AleksandarLilic/ama-riscv/examples/perf_runs_fpga/plots_mlp.pdf

## TDA for 'mlp_w2a8'

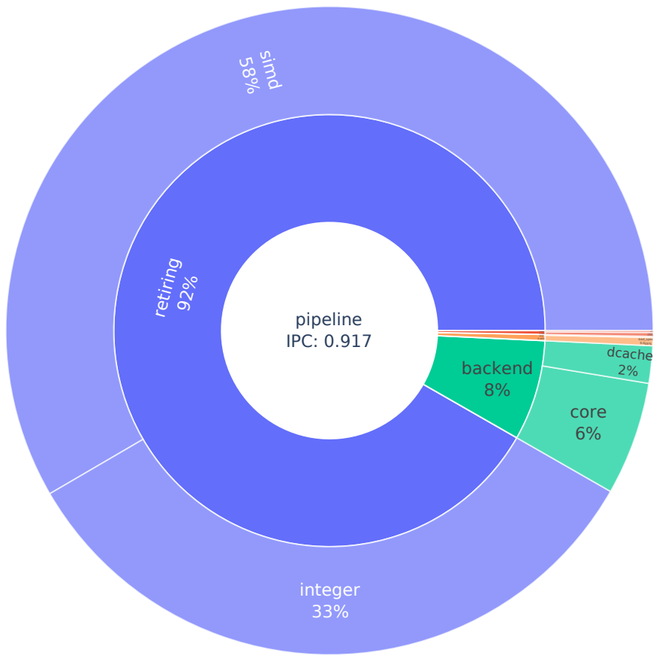
[picture p23: figure]
pipeline IPC: 0.917; retiring 92%; backend 8%; lost 0.46%; frontend 0.285%; simd 58%; integer 33%; core 6%; dcache 2%; bad_spec 0.405%; other 0.0551%; icache 0.193%; core 0.0921%

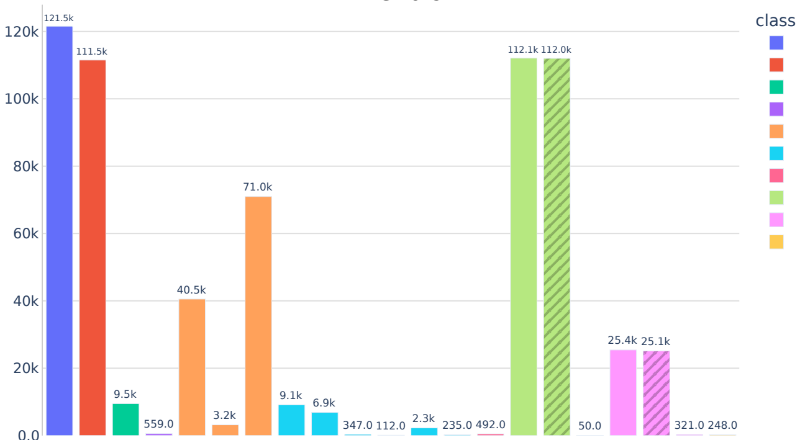
[picture p24: figure]
class

cycles
ret_inst

stalls
lost

ret_int
ret_ctrl_flow_br

ret_simd
stall_be
stall_be_core

stall_fe
stall_fe_core

stall_l1d

stall_l1i
bad_spec
l1i_ref

l1i_hit

l1i_miss
l1d_ref

l1d_hit

l1d_miss

bp_miss

0.0

20k

40k

60k

80k

100k

cycles
ret
stall
lost
ret_*
stall_*
bad_spec
l1i_*
l1d_*
bp_*

## Performance Counters for 'mlp_w2a8' IPC: 0.917

count

# hatched = derived

## TDA for 'mlp_w4a8'

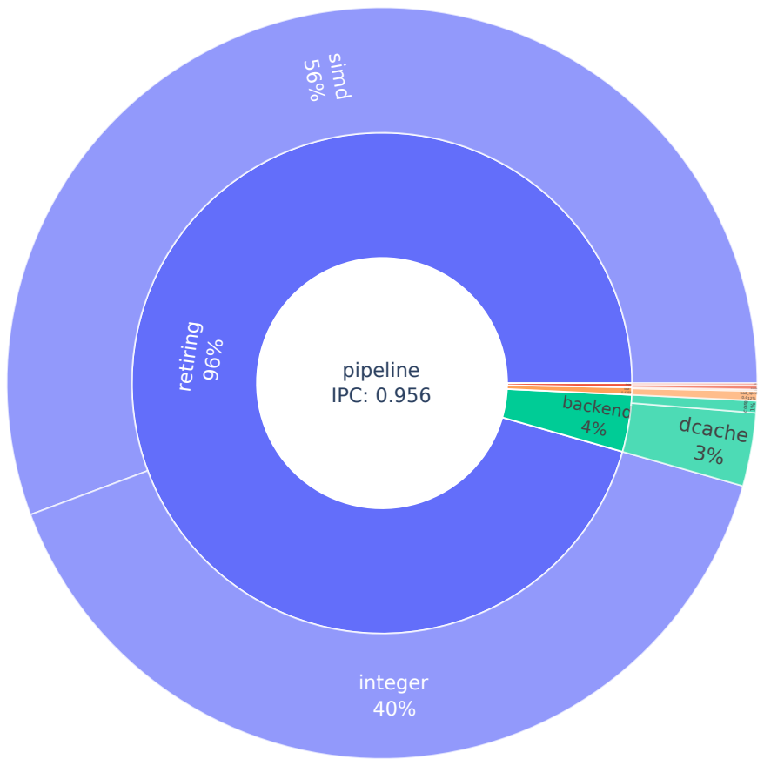
[picture p25: figure]
pipeline; IPC: 0.956 retiring 96%; backend 4%; lost 0.476%; frontend 0.27%; simd; integer 40%; dcache 3%; core; bad_spec 0.412%; other 0.0646%; icache 0.181%; core 0.0887%

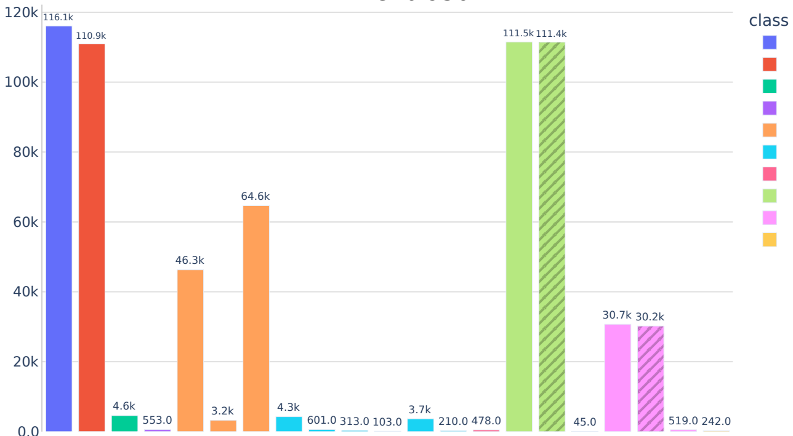
[picture p26: figure]
class

cycles
ret_inst

stalls
lost

ret_int
ret_ctrl_flow_br

ret_simd
stall_be
stall_be_core

stall_fe
stall_fe_core

stall_l1d

stall_l1i
bad_spec
l1i_ref

l1i_hit

l1i_miss
l1d_ref

l1d_hit

l1d_miss

bp_miss

0.0

20k

40k

60k

80k

100k

cycles
ret
stall
lost
ret_*
stall_*
bad_spec
l1i_*
l1d_*
bp_*

## Performance Counters for 'mlp_w4a8' IPC: 0.956

count

# hatched = derived

## TDA for 'mlp_w8a8'

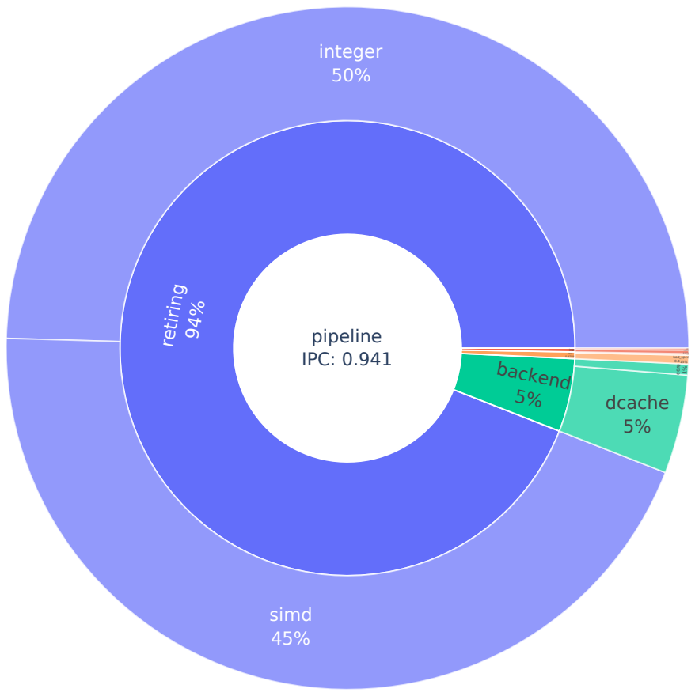
[picture p27: figure]
pipeline IPC: 0.941; retiring 94%; backend 5%; lost 0.478%; frontend 0.266%; integer 50%; simd 45%; dcache 5%; core; bad_spec 0.415%; other 0.0634%; icache 0.177%; core 0.0891%

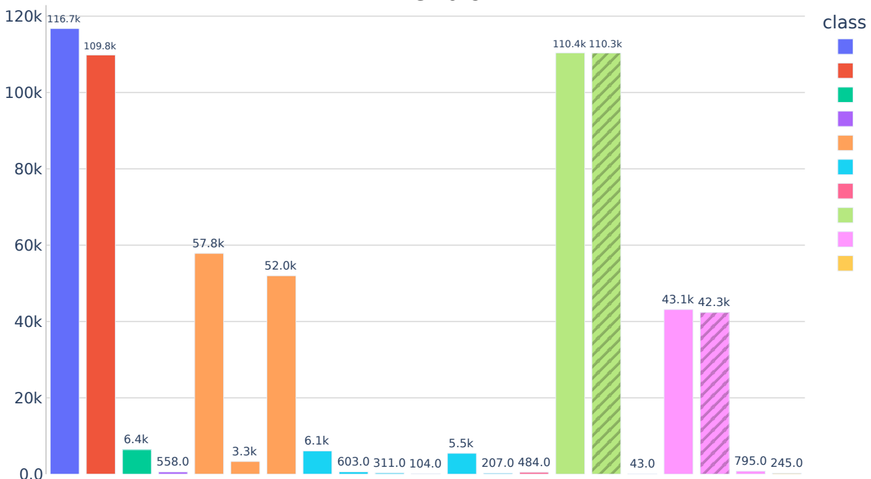
[picture p28: figure]
class

cycles
ret_inst

stalls
lost

ret_int
ret_ctrl_flow_br

ret_simd
stall_be
stall_be_core

stall_fe
stall_fe_core

stall_l1d

stall_l1i
bad_spec
l1i_ref

l1i_hit

l1i_miss
l1d_ref

l1d_hit

l1d_miss

bp_miss

0.0

20k

40k

60k

80k

100k

cycles
ret
stall
lost
ret_*
stall_*
bad_spec
l1i_*
l1d_*
bp_*

## Performance Counters for 'mlp_w8a8' IPC: 0.941

count

# hatched = derived
