AleksandarLilic/ama-riscv/examples/perf_runs_fpga/plots_ustress.pdf

## TDA for 'ustress_branch_direct'

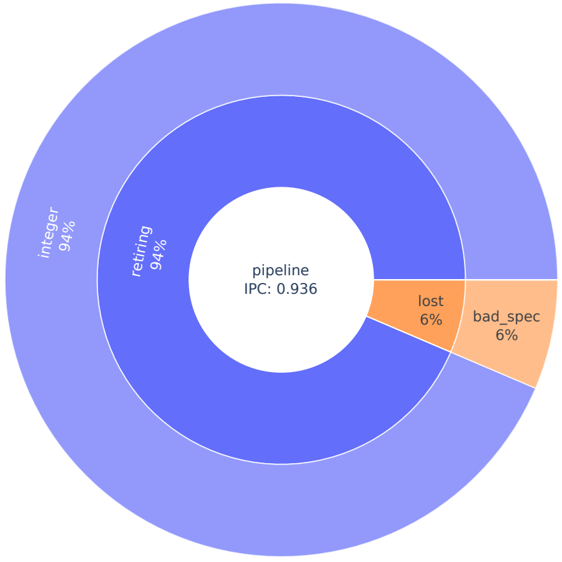
[picture p29: figure]
pipeline IPC: 0.936; retiring 94%; lost 6%; integer 94%; bad_spec 6%

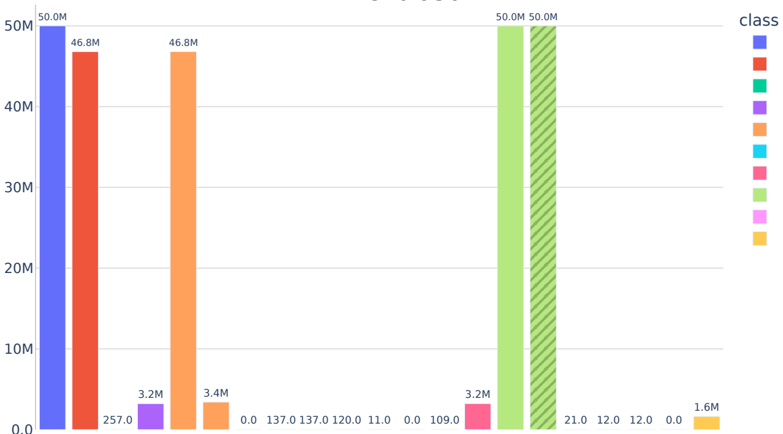
[picture p30: figure]
class

cycles
ret_inst

stalls
lost

ret_int
ret_ctrl_flow_br

ret_simd
stall_be
stall_be_core

stall_fe
stall_fe_core

stall_l1d

stall_l1i
bad_spec
l1i_ref

l1i_hit

l1i_miss
l1d_ref

l1d_hit

l1d_miss

bp_miss

0.0

10M

20M

30M

40M

cycles
ret
stall
lost
ret_*
stall_*
bad_spec
l1i_*
l1d_*
bp_*

## Performance Counters for 'ustress_branch_direct' IPC: 0.936

count

# hatched = derived

## TDA for 'ustress_branch_indirect'

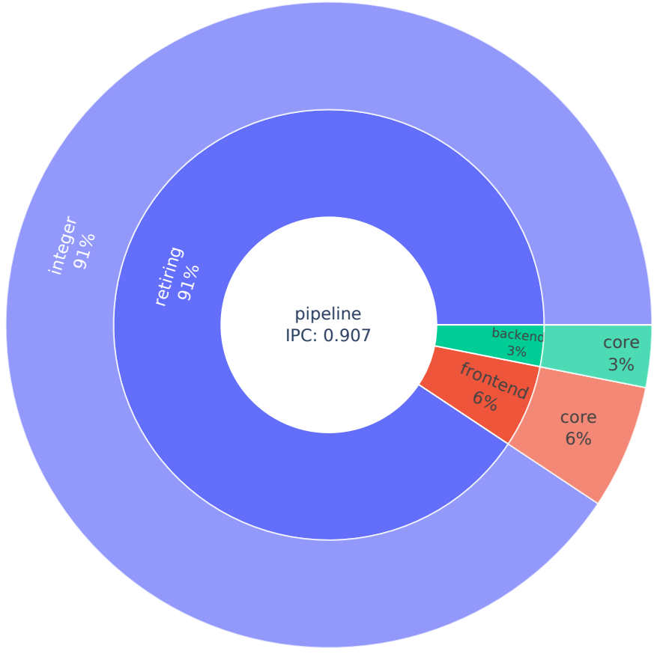
[picture p31: figure]
pipeline IPC: 0.907; retiring 91%; frontend 6%; backend 3%; integer 91%; core 6%; core 3%

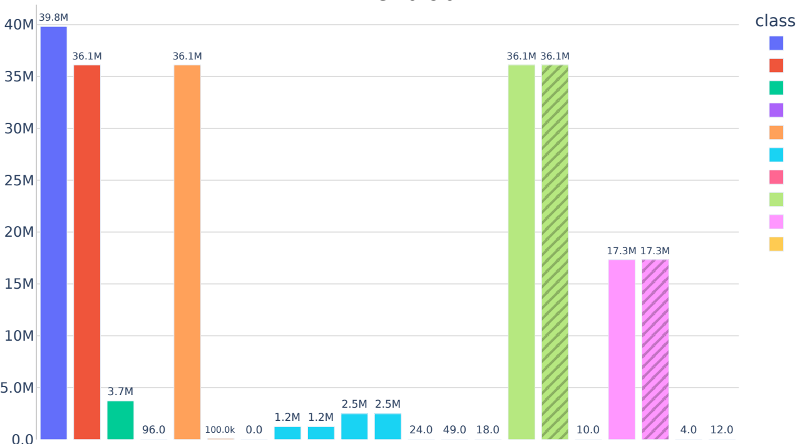
[picture p32: figure]
class

cycles
ret_inst

stalls
lost

ret_int
ret_ctrl_flow_br

ret_simd
stall_be
stall_be_core

stall_fe
stall_fe_core

stall_l1d

stall_l1i
bad_spec
l1i_ref

l1i_hit

l1i_miss
l1d_ref

l1d_hit

l1d_miss

bp_miss

0.0

5.0M

10M

15M

20M

25M

30M

35M

cycles
ret
stall
lost
ret_*
stall_*
bad_spec
l1i_*
l1d_*
bp_*

## Performance Counters for 'ustress_branch_indirect' IPC: 0.907

count

# hatched = derived

## TDA for 'ustress_call_return'

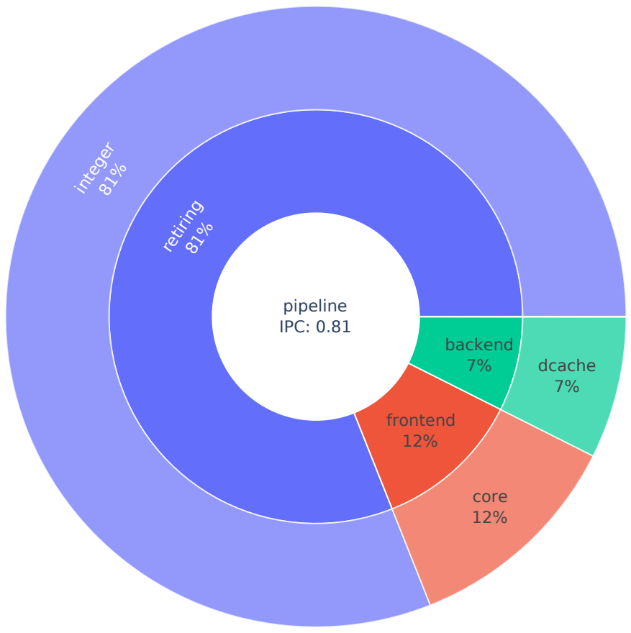
[picture p33: figure]
pipeline IPC: 0.81; retiring 81%; frontend 12%; backend 7%; lost 0.0118%; integer 81%; core 12%; dcache 7%; bad_spec 0.0117%

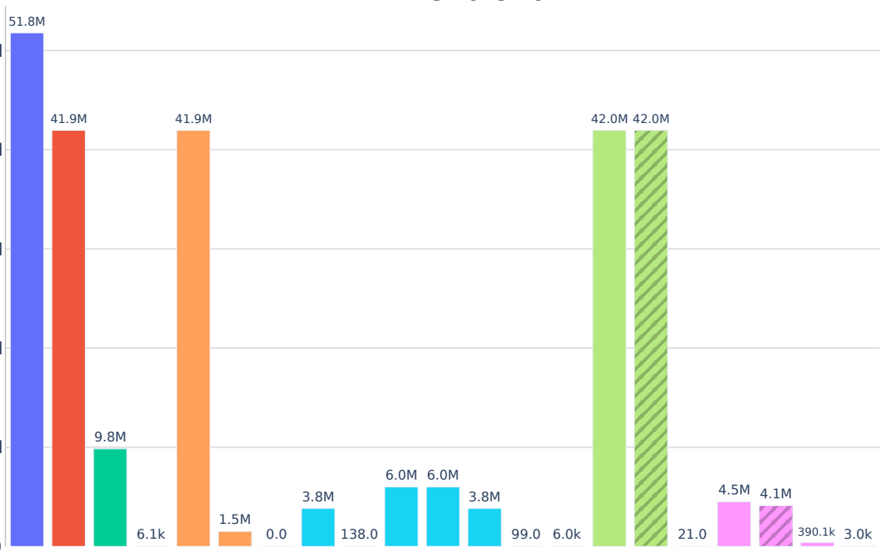
[picture p34: figure]

cycles
ret_inst

stalls
lost

ret_int
ret_ctrl_flow_br

ret_simd
stall_be
stall_be_core

stall_fe
stall_fe_core

stall_l1d

stall_l1i
bad_spec
l1i_ref

l1i_hit

l1i_miss
l1d_ref

l1d_hit

l1d_miss

bp_miss

0.0

10M

20M

30M

40M

50M

class
cycles
ret
stall
lost
ret_*
stall_*
bad_spec
l1i_*
l1d_*
bp_*

## Performance Counters for 'ustress_call_return' IPC: 0.810

count

# hatched = derived

## TDA for 'ustress_div32'

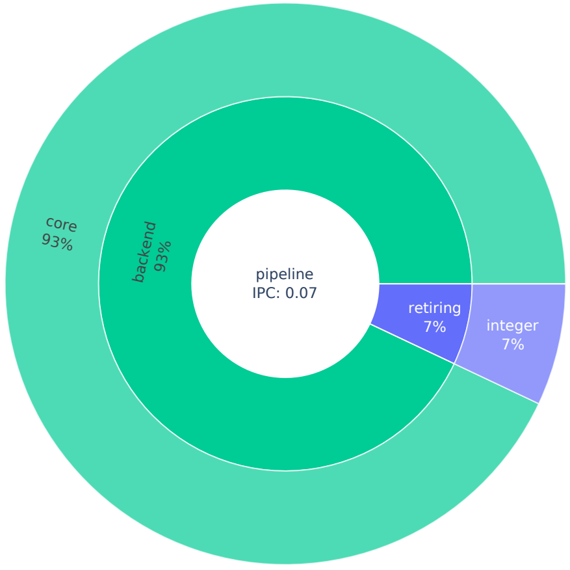
[picture p35: figure]
pipeline IPC: 0.07; backend 93%; retiring 7%; core 93%; integer 7%

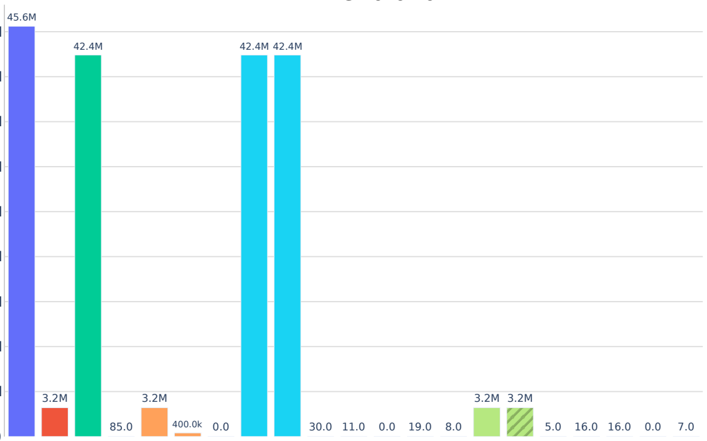
[picture p36: figure]

cycles
ret_inst

stalls
lost

ret_int
ret_ctrl_flow_br

ret_simd
stall_be
stall_be_core

stall_fe
stall_fe_core

stall_l1d

stall_l1i
bad_spec
l1i_ref

l1i_hit

l1i_miss
l1d_ref

l1d_hit

l1d_miss

bp_miss

0.0

5.0M

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
class
cycles
ret
stall
lost
ret_*
stall_*
bad_spec
l1i_*
l1d_*
bp_*

## Performance Counters for 'ustress_div32' IPC: 0.070

count

# hatched = derived

## TDA for 'ustress_div64'

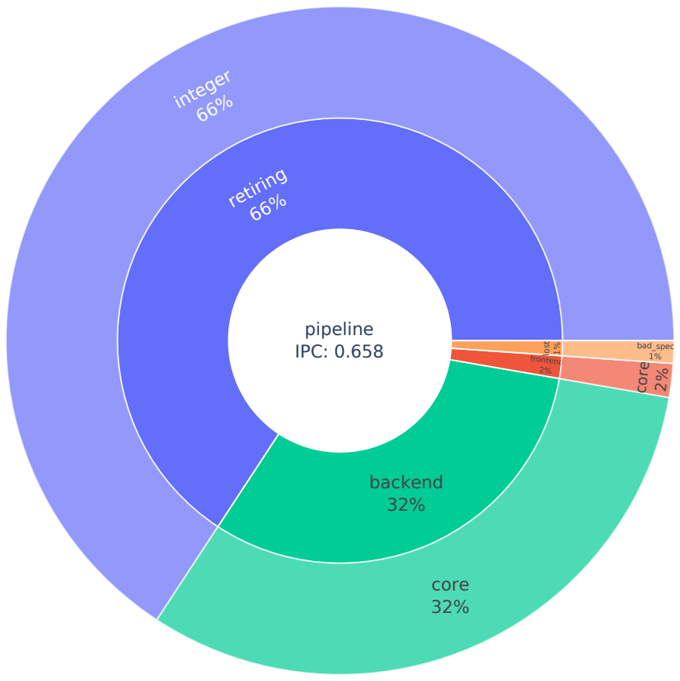
[picture p37: figure]
pipeline IPC: 0.658; retiring 66%; backend 32%; frontend; 2%lost; integer 66%; core 32%; core 2%; bad_spec 1%

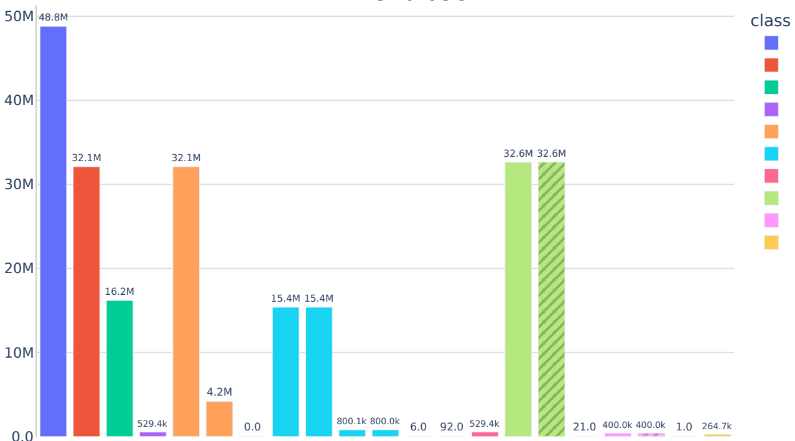
[picture p38: figure]
class

cycles
ret_inst

stalls
lost

ret_int
ret_ctrl_flow_br

ret_simd
stall_be
stall_be_core

stall_fe
stall_fe_core

stall_l1d

stall_l1i
bad_spec
l1i_ref

l1i_hit

l1i_miss
l1d_ref

l1d_hit

l1d_miss

bp_miss

0.0

10M

20M

30M

40M

cycles
ret
stall
lost
ret_*
stall_*
bad_spec
l1i_*
l1d_*
bp_*

## Performance Counters for 'ustress_div64' IPC: 0.658

count

# hatched = derived

## TDA for 'ustress_l1d_cache'

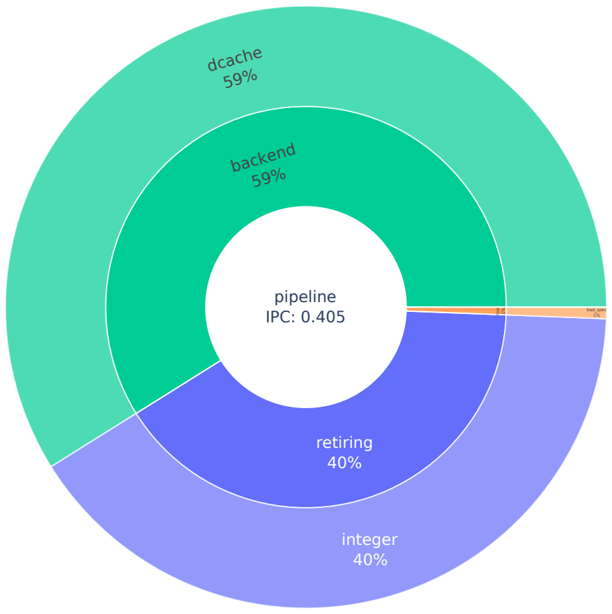
[picture p39: figure]
pipeline IPC: 0.405; backend 59%; retiring 40%; lost; dcache 59%; integer 40%; bad_spec 1%

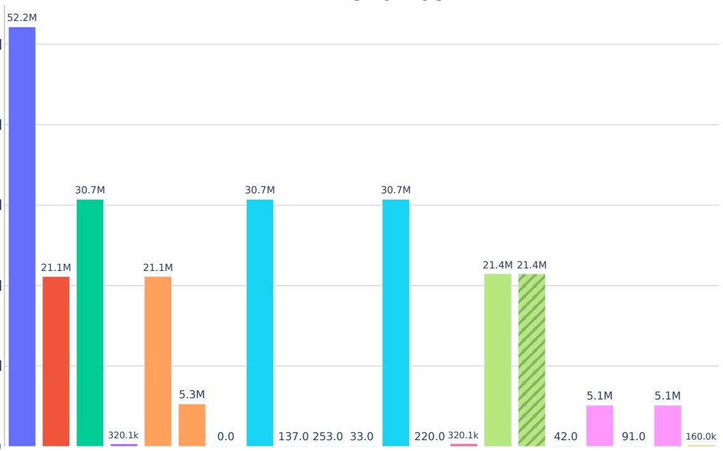
[picture p40: figure]
220.0 ³²⁰.1k

cycles
ret_inst

stalls
lost

ret_int
ret_ctrl_flow_br

ret_simd
stall_be
stall_be_core

stall_fe
stall_fe_core

stall_l1d

stall_l1i
bad_spec
l1i_ref

l1i_hit

l1i_miss
l1d_ref

l1d_hit

l1d_miss

bp_miss

0.0

10M

20M

30M

40M

50M

class
cycles
ret
stall
lost
ret_*
stall_*
bad_spec
l1i_*
l1d_*
bp_*

## Performance Counters for 'ustress_l1d_cache' IPC: 0.405

count

# hatched = derived

## TDA for 'ustress_l1i_cache'

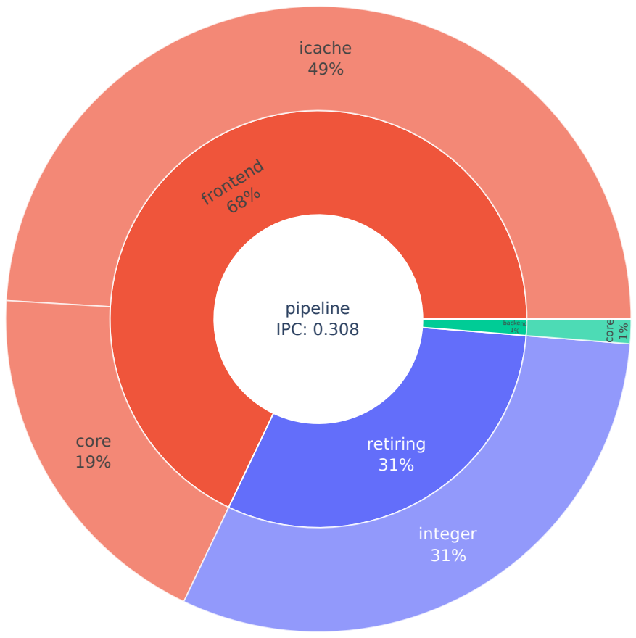
[picture p41: figure]
pipeline IPC: 0.308; frontend 68%; retiring 31%; backend 1%; icache 49%; core 19%; integer 31%; core

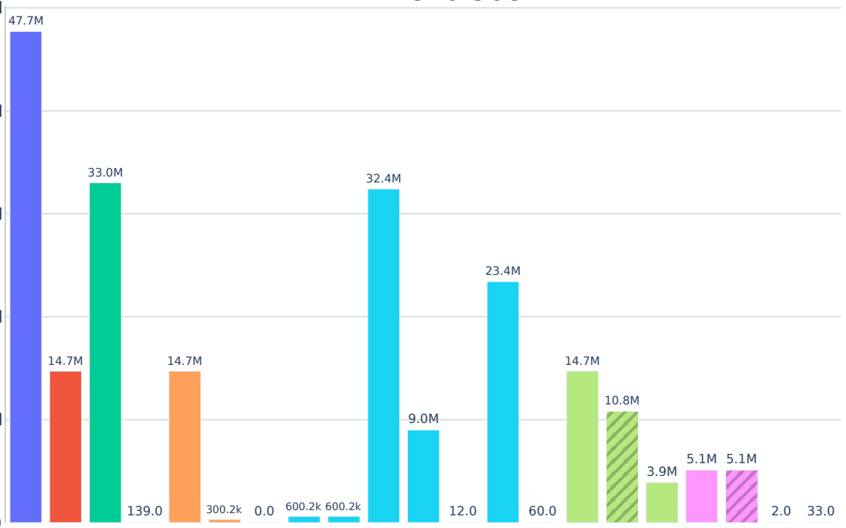
[picture p42: figure]

cycles
ret_inst

stalls
lost

ret_int
ret_ctrl_flow_br

ret_simd
stall_be
stall_be_core

stall_fe
stall_fe_core

stall_l1d

stall_l1i
bad_spec
l1i_ref

l1i_hit

l1i_miss
l1d_ref

l1d_hit

l1d_miss

bp_miss

0.0

10M

20M

30M

40M

50M
class
cycles
ret
stall
lost
ret_*
stall_*
bad_spec
l1i_*
l1d_*
bp_*

## Performance Counters for 'ustress_l1i_cache' IPC: 0.308

count

# hatched = derived

## TDA for 'ustress_load_after_store'

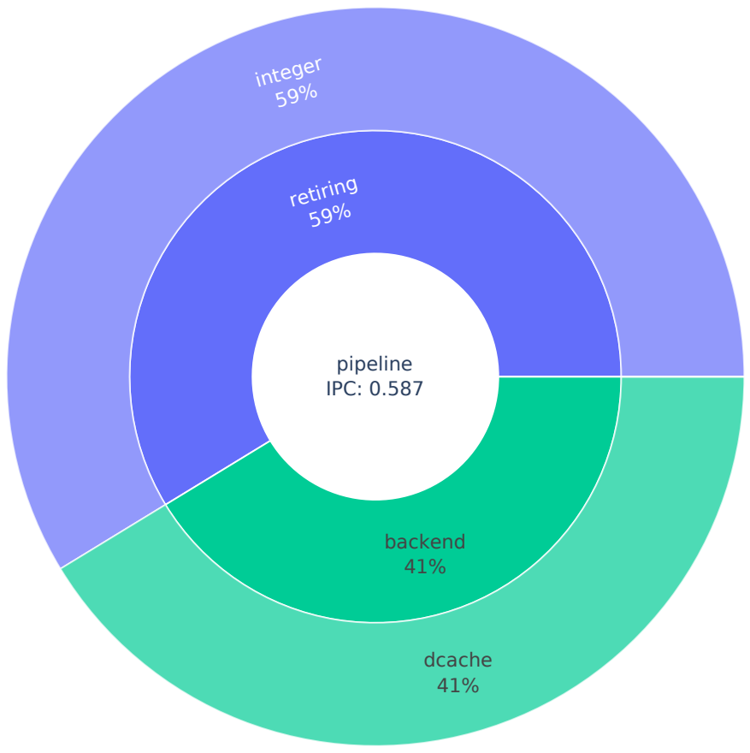
[picture p43: figure]
pipeline IPC: 0.587; retiring 59%; backend 41%; integer 59%; dcache 41%

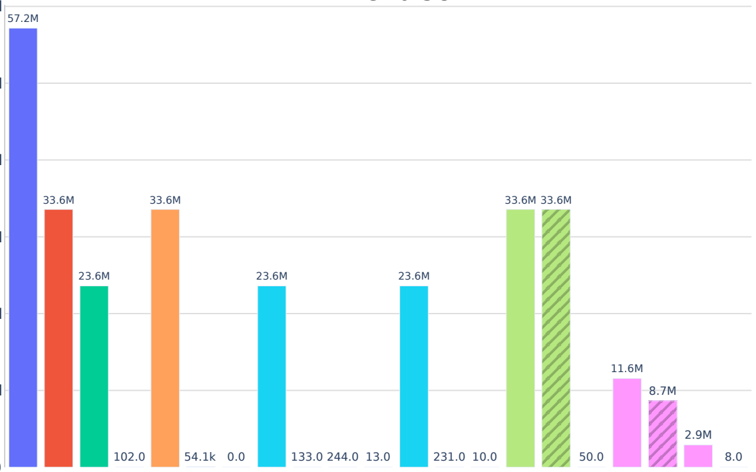
[picture p44: figure]

cycles
ret_inst

stalls
lost

ret_int
ret_ctrl_flow_br

ret_simd
stall_be
stall_be_core

stall_fe
stall_fe_core

stall_l1d

stall_l1i
bad_spec
l1i_ref

l1i_hit

l1i_miss
l1d_ref

l1d_hit

l1d_miss

bp_miss

0.0

10M

20M

30M

40M

50M

60M
class
cycles
ret
stall
lost
ret_*
stall_*
bad_spec
l1i_*
l1d_*
bp_*

## Performance Counters for 'ustress_load_after_store' IPC: 0.587

count

# hatched = derived

## TDA for 'ustress_mac32'

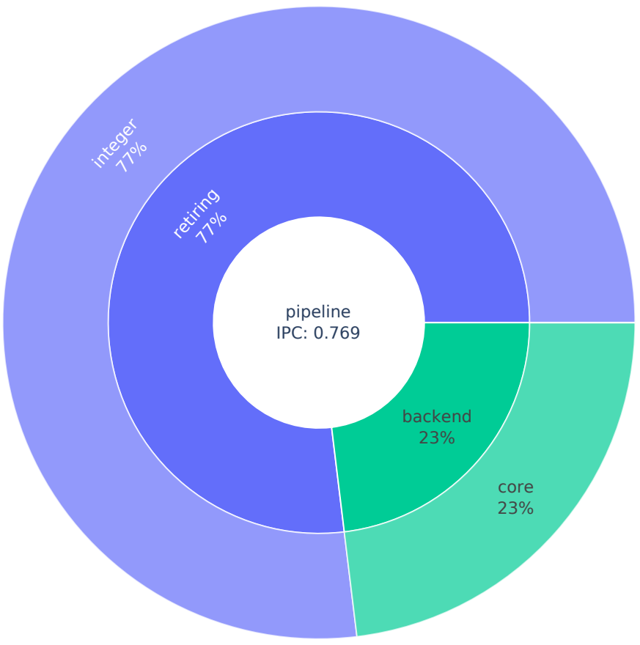
[picture p45: figure]
pipeline IPC: 0.769; retiring 77%; backend 23%; integer 77%; core 23%

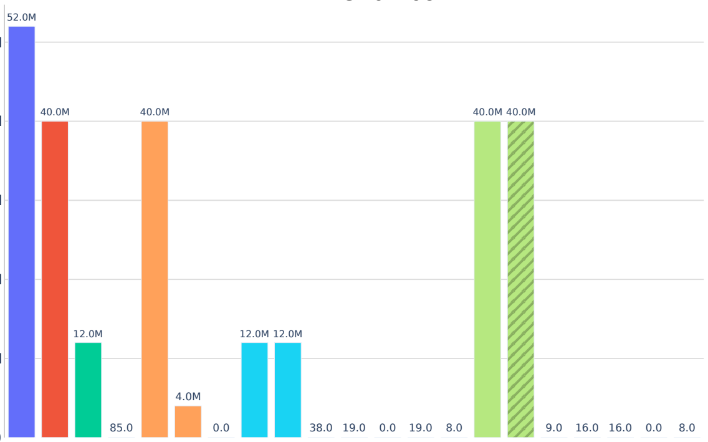
[picture p46: figure]

cycles
ret_inst

stalls
lost

ret_int
ret_ctrl_flow_br

ret_simd
stall_be
stall_be_core

stall_fe
stall_fe_core

stall_l1d

stall_l1i
bad_spec
l1i_ref

l1i_hit

l1i_miss
l1d_ref

l1d_hit

l1d_miss

bp_miss

0.0

10M

20M

30M

40M

50M

class
cycles
ret
stall
lost
ret_*
stall_*
bad_spec
l1i_*
l1d_*
bp_*

## Performance Counters for 'ustress_mac32' IPC: 0.769

count

# hatched = derived

## TDA for 'ustress_mac64'

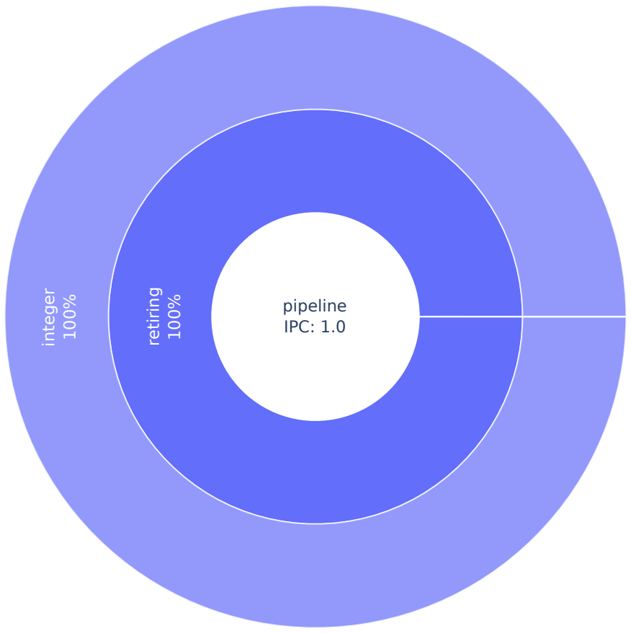
[picture p47: figure]
pipeline IPC: 1.0; retiring; integer

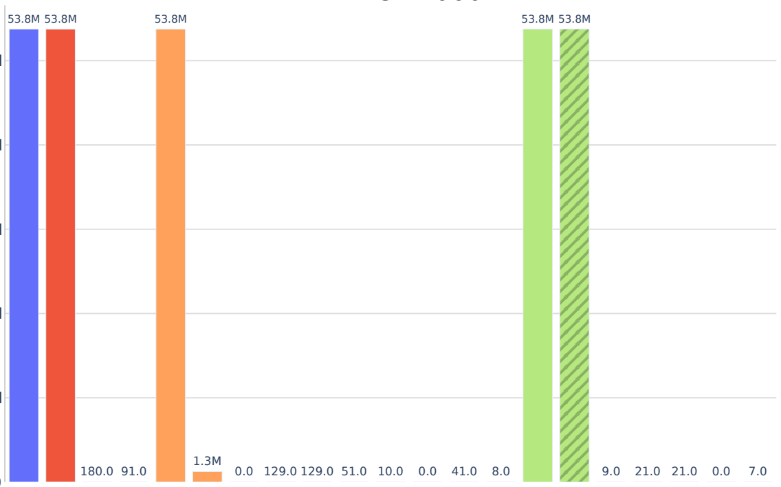
[picture p48: figure]

cycles
ret_inst

stalls
lost

ret_int
ret_ctrl_flow_br

ret_simd
stall_be
stall_be_core

stall_fe
stall_fe_core

stall_l1d

stall_l1i
bad_spec
l1i_ref

l1i_hit

l1i_miss
l1d_ref

l1d_hit

l1d_miss

bp_miss

0.0

10M

20M

30M

40M

50M

class
cycles
ret
stall
lost
ret_*
stall_*
bad_spec
l1i_*
l1d_*
bp_*

## Performance Counters for 'ustress_mac64' IPC: 1.000

count

# hatched = derived

## TDA for 'ustress_memcpy'

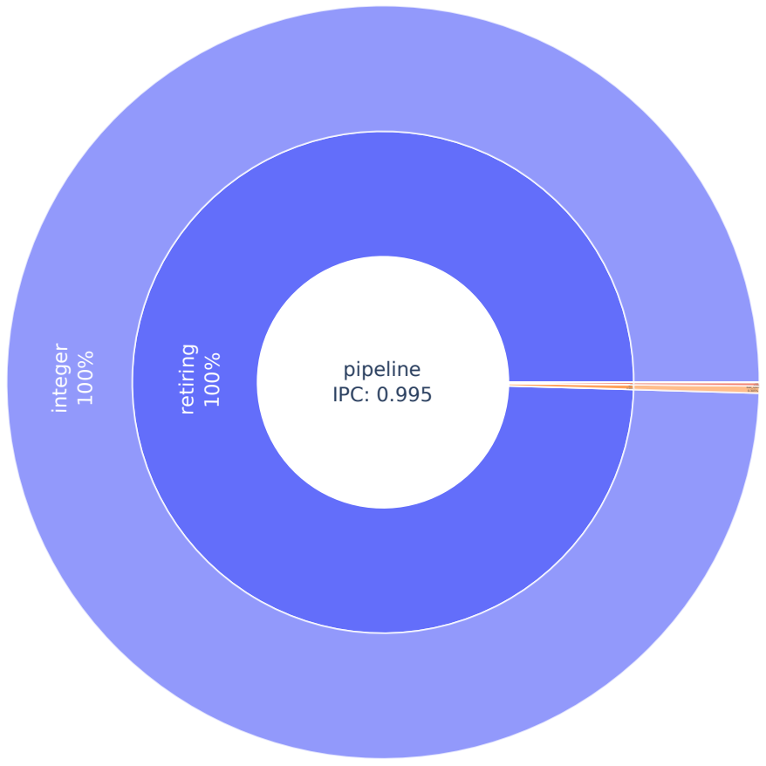
[picture p49: figure]
pipeline IPC: 0.995; retiring; lost 0.305%; frontend 0.153%; ba ck e nd 0. 0 13 9 % integer 100%; bad_spec 0.305%; core 0.153%

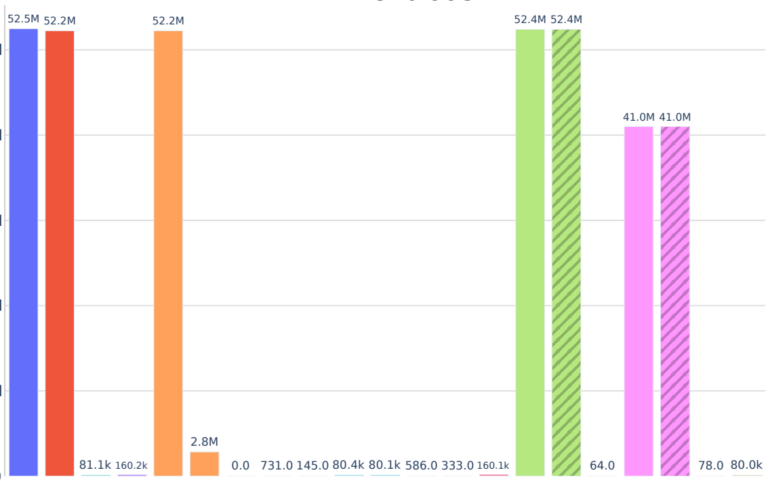
[picture p50: figure]

0.0 731.0 145.0 80.4k 80.1k 586.0 333.0 160.1k
cycles
ret_inst

stalls
lost

ret_int
ret_ctrl_flow_br

ret_simd
stall_be
stall_be_core

stall_fe
stall_fe_core

stall_l1d

stall_l1i
bad_spec
l1i_ref

l1i_hit

l1i_miss
l1d_ref

l1d_hit

l1d_miss

bp_miss

0.0

10M

20M

30M

40M

50M

class
cycles
ret
stall
lost
ret_*
stall_*
bad_spec
l1i_*
l1d_*
bp_*

## Performance Counters for 'ustress_memcpy' IPC: 0.995

count

# hatched = derived

## TDA for 'ustress_mul32'

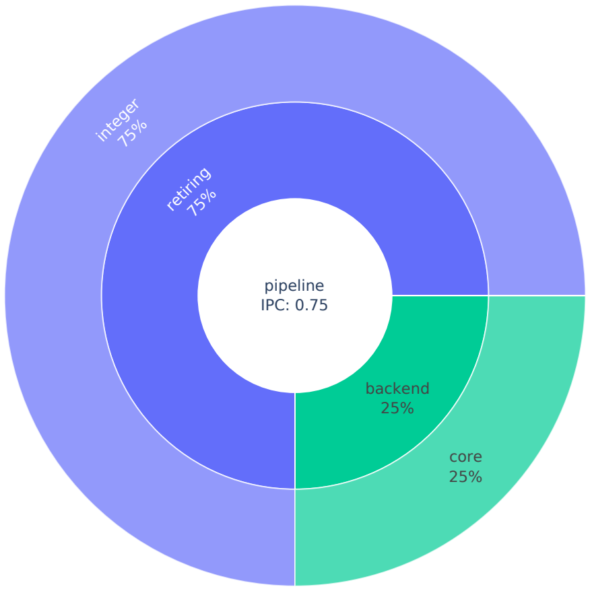
[picture p51: figure]
pipeline IPC: 0.75; retiring 75%; backend 25%; integer 75%; core 25%

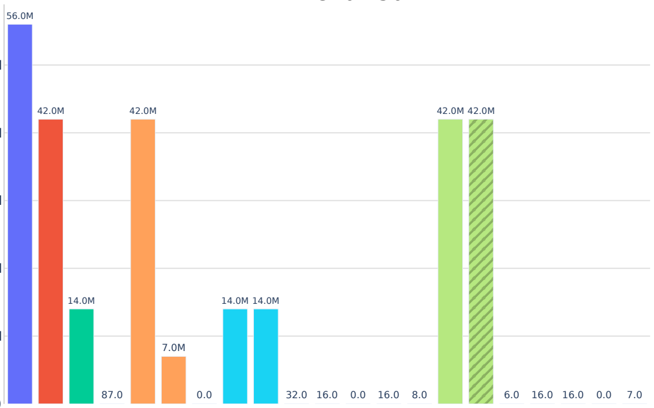
[picture p52: figure]

cycles
ret_inst

stalls
lost

ret_int
ret_ctrl_flow_br

ret_simd
stall_be
stall_be_core

stall_fe
stall_fe_core

stall_l1d

stall_l1i
bad_spec
l1i_ref

l1i_hit

l1i_miss
l1d_ref

l1d_hit

l1d_miss

bp_miss

0.0

10M

20M

30M

40M

50M

class
cycles
ret
stall
lost
ret_*
stall_*
bad_spec
l1i_*
l1d_*
bp_*

## Performance Counters for 'ustress_mul32' IPC: 0.750

count

# hatched = derived

## TDA for 'ustress_mul64'

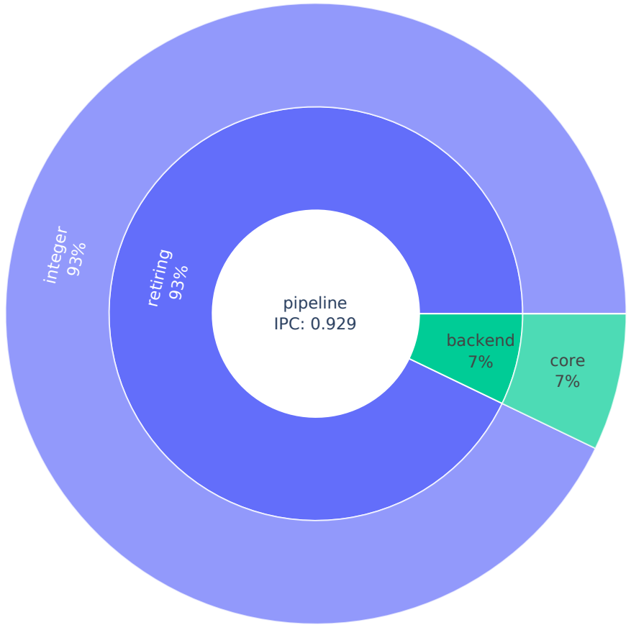
[picture p53: figure]
pipeline IPC: 0.929; retiring 93%; backend 7%; integer 93%; core 7%

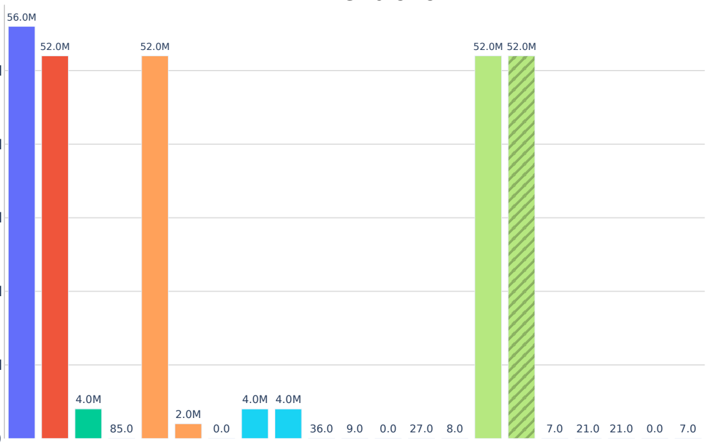
[picture p54: figure]

cycles
ret_inst

stalls
lost

ret_int
ret_ctrl_flow_br

ret_simd
stall_be
stall_be_core

stall_fe
stall_fe_core

stall_l1d

stall_l1i
bad_spec
l1i_ref

l1i_hit

l1i_miss
l1d_ref

l1d_hit

l1d_miss

bp_miss

0.0

10M

20M

30M

40M

50M

class
cycles
ret
stall
lost
ret_*
stall_*
bad_spec
l1i_*
l1d_*
bp_*

## Performance Counters for 'ustress_mul64' IPC: 0.929

count

# hatched = derived
