AleksandarLilic/ama-riscv/examples/dhrystone_dhrystone_out_cosim/callstack_folded_clk_cycle.png

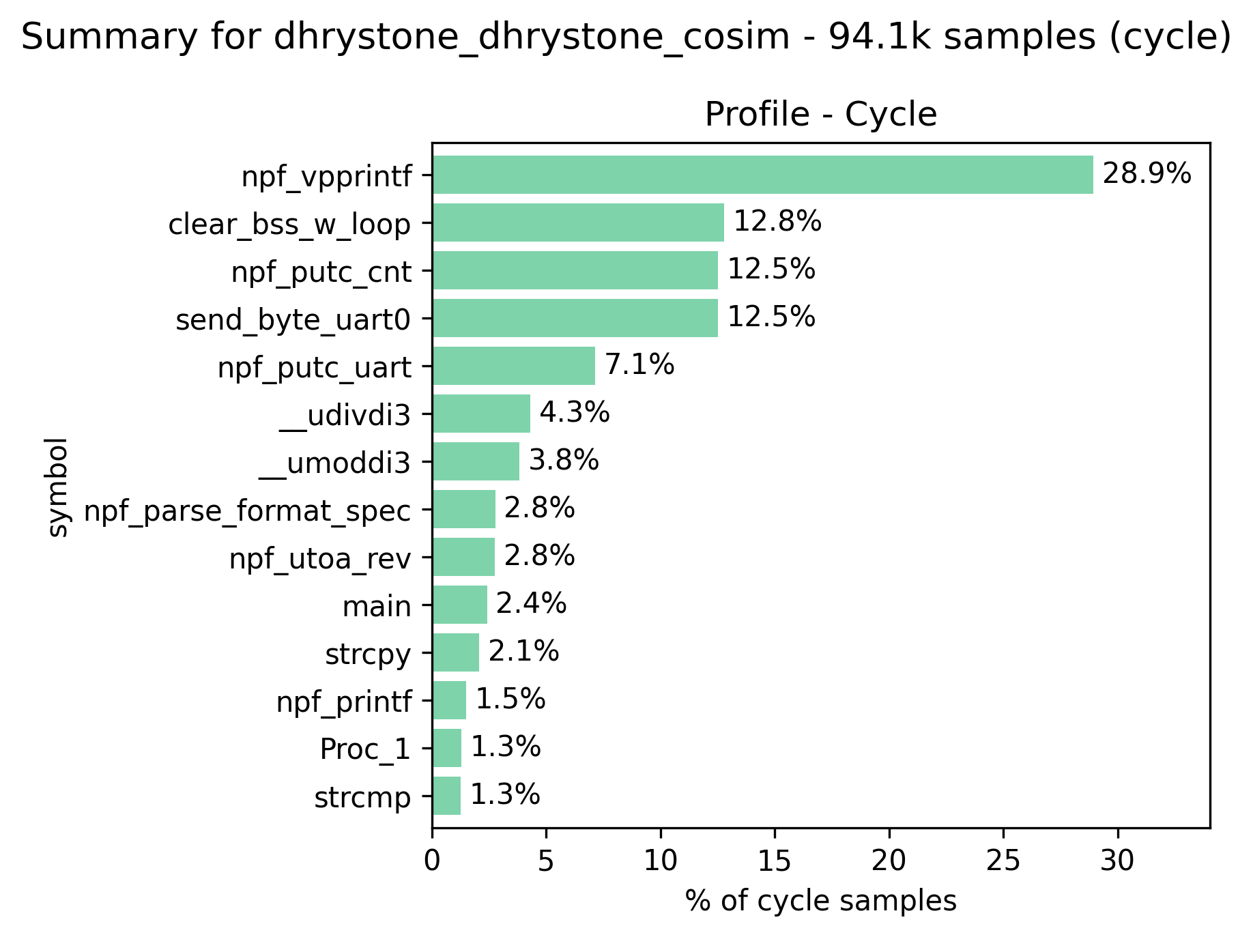
examples/dhrystone_dhrystone_out_cosim/callstack_folded_clk_cycle.png
