AleksandarLilic/ama-riscv/examples/perf_runs_fpga/plots_benchmarks.pdf

## TDA for 'coremark'

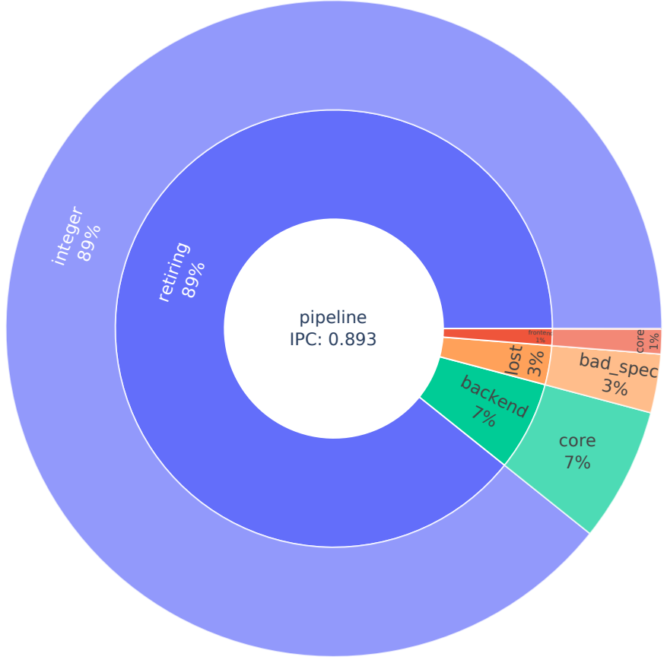
[picture p56: figure]
pipeline IPC: 0.893; retiring 89%; backend 7%; lost 3%; frontend 1%; integer 89%; core 7%; bad_spec 3%; core; 1% icache 0.0321%

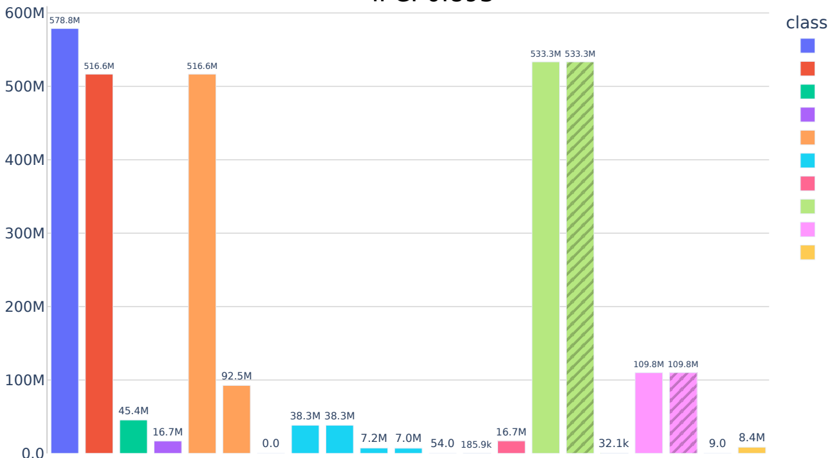
[picture p57: figure]
class

cycles
ret_inst

stalls
lost

ret_int
ret_ctrl_flow_br

ret_simd
stall_be
stall_be_core

stall_fe
stall_fe_core

stall_l1d

stall_l1i
bad_spec
l1i_ref

l1i_hit

l1i_miss
l1d_ref

l1d_hit

l1d_miss

bp_miss

0.0

100M

200M

300M

400M

500M

cycles
ret
stall
lost
ret_*
stall_*
bad_spec
l1i_*
l1d_*
bp_*

## Performance Counters for 'coremark' IPC: 0.893

count

# hatched = derived

## TDA for 'dhrystone'

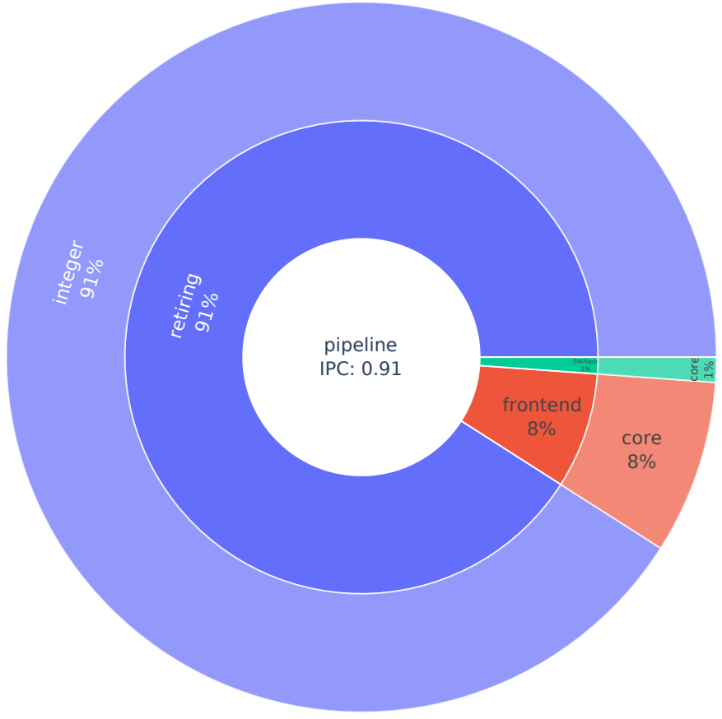
[picture p58: figure]
pipeline IPC: 0.91; retiring 91%; frontend 8%; backend 1%; integer 91%; core 8%; core

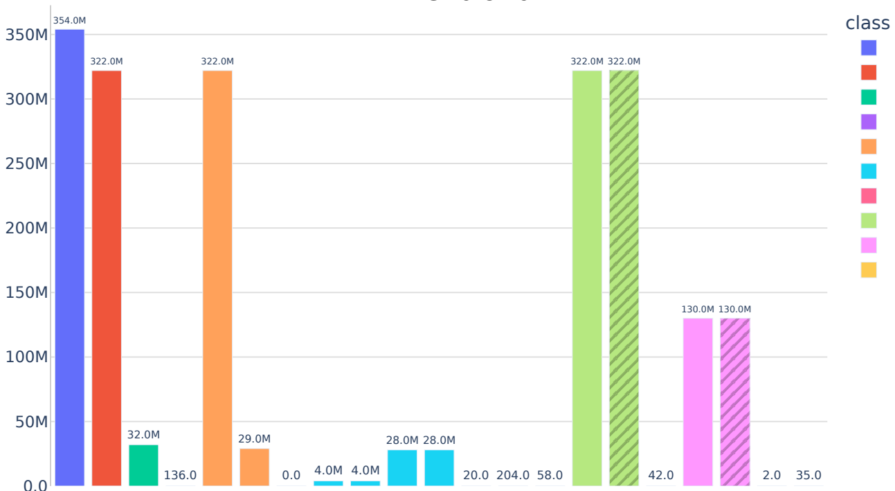
[picture p59: figure]
class

cycles
ret_inst

stalls
lost

ret_int
ret_ctrl_flow_br

ret_simd
stall_be
stall_be_core

stall_fe
stall_fe_core

stall_l1d

stall_l1i
bad_spec
l1i_ref

l1i_hit

l1i_miss
l1d_ref

l1d_hit

l1d_miss

bp_miss

0.0

50M

100M

150M

200M

250M

300M

cycles
ret
stall
lost
ret_*
stall_*
bad_spec
l1i_*
l1d_*
bp_*

## Performance Counters for 'dhrystone' IPC: 0.910

count

# hatched = derived

## TDA for 'stream_int'

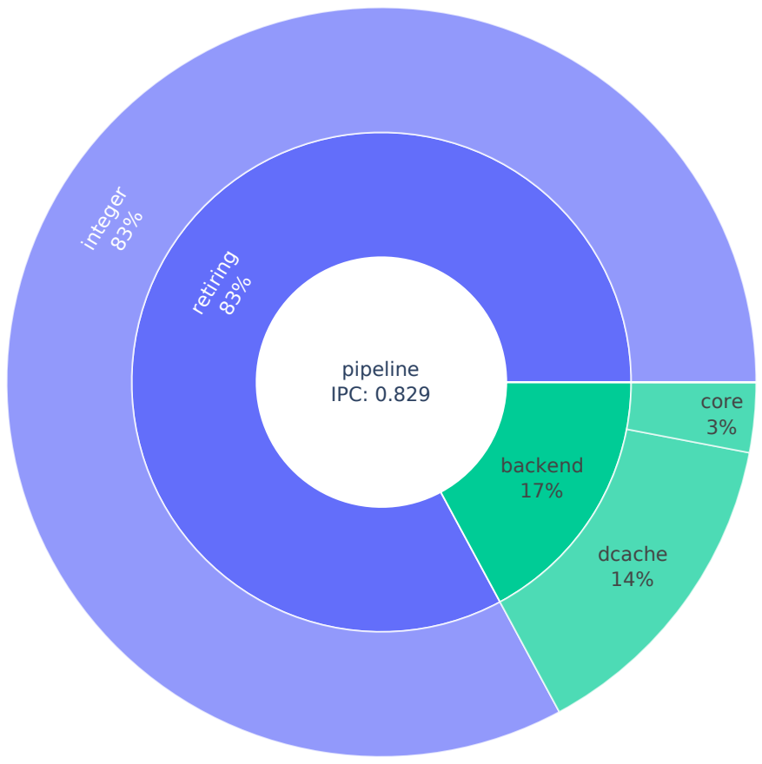
[picture p60: figure]
pipeline IPC: 0.829; retiring 83%; backend 17%; lost 0 .00915%; integer 83%; dcache 14%; core 3%; bad_spec 0.00636%; other 0.00279%; icache 0. 00159%

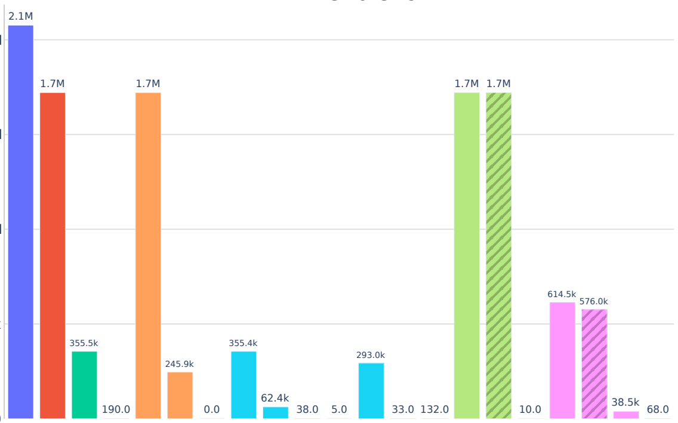
[picture p61: figure]

cycles
ret_inst

stalls
lost

ret_int
ret_ctrl_flow_br

ret_simd
stall_be
stall_be_core

stall_fe
stall_fe_core

stall_l1d

stall_l1i
bad_spec
l1i_ref

l1i_hit

l1i_miss
l1d_ref

l1d_hit

l1d_miss

bp_miss

0.0

500k

1.0M

1.5M

2.0M

class
cycles
ret
stall
lost
ret_*
stall_*
bad_spec
l1i_*
l1d_*
bp_*

## Performance Counters for 'stream_int' IPC: 0.829

count

# hatched = derived

## TDA for 'embench_aha-mont64'

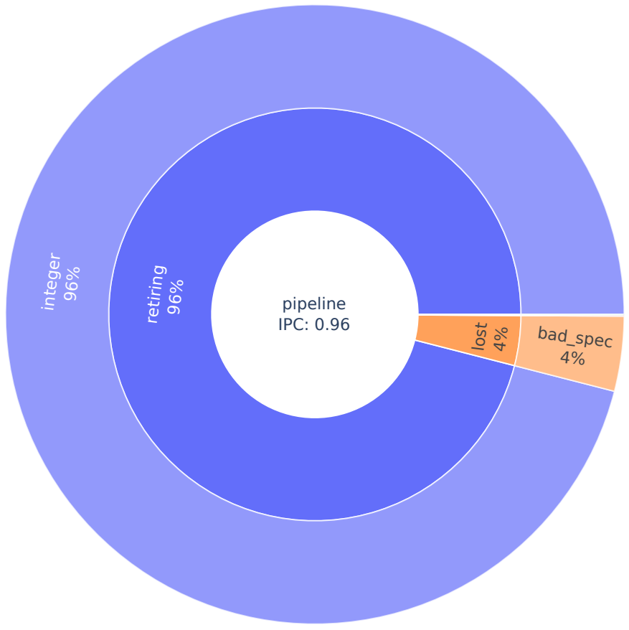
[picture p62: figure]
pipeline; IPC: 0.96 retiring 96%; lost; 4% frontend 0.0543%; backend 0.0362%; integer 96%; bad_spec 4%; core 0.0542%; core 0.0362%

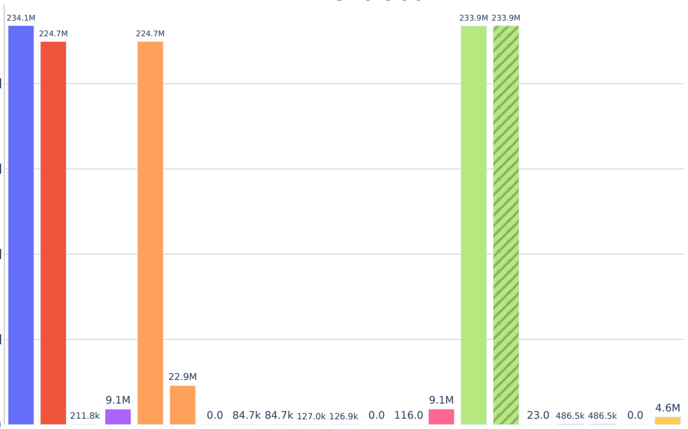
[picture p63: figure]

cycles
ret_inst

stalls
lost

ret_int
ret_ctrl_flow_br

ret_simd
stall_be
stall_be_core

stall_fe
stall_fe_core

stall_l1d

stall_l1i
bad_spec
l1i_ref

l1i_hit

l1i_miss
l1d_ref

l1d_hit

l1d_miss

bp_miss

0.0

50M

100M

150M

200M

class
cycles
ret
stall
lost
ret_*
stall_*
bad_spec
l1i_*
l1d_*
bp_*

## Performance Counters for 'embench_aha-mont64' IPC: 0.960

count

# hatched = derived

## TDA for 'embench_crc32'

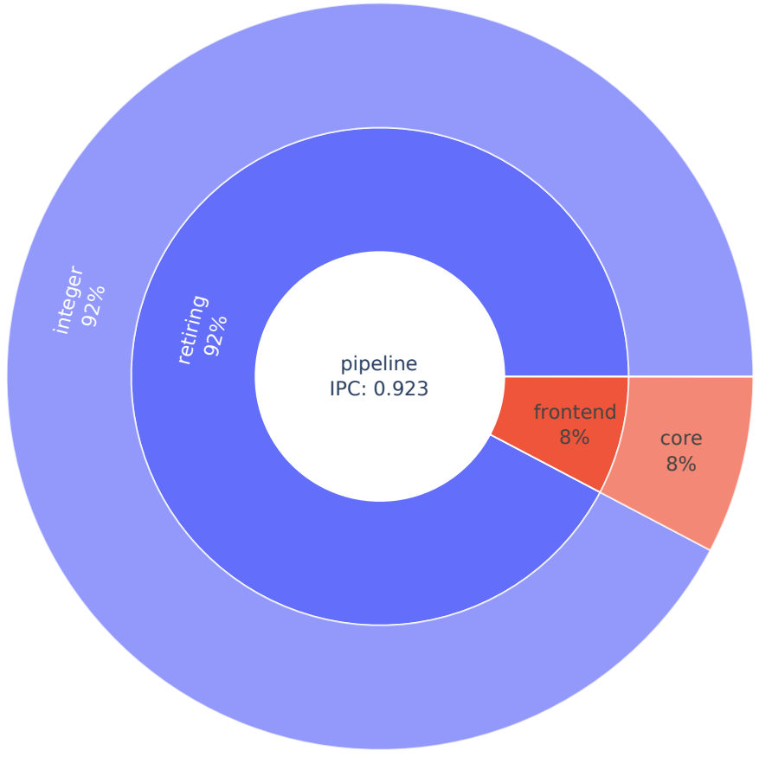
[picture p64: figure]
pipeline IPC: 0.923; retiring 92%; frontend 8%; lost 0 .00754%; integer 92%; core 8%; bad_spec 0.00751%

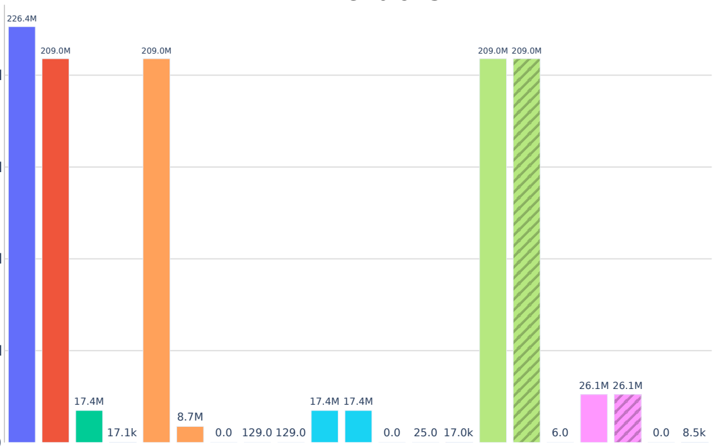
[picture p65: figure]

cycles
ret_inst

stalls
lost

ret_int
ret_ctrl_flow_br

ret_simd
stall_be
stall_be_core

stall_fe
stall_fe_core

stall_l1d

stall_l1i
bad_spec
l1i_ref

l1i_hit

l1i_miss
l1d_ref

l1d_hit

l1d_miss

bp_miss

0.0

50M

100M

150M

200M

class
cycles
ret
stall
lost
ret_*
stall_*
bad_spec
l1i_*
l1d_*
bp_*

## Performance Counters for 'embench_crc32' IPC: 0.923

count

# hatched = derived

## TDA for 'embench_cubic'

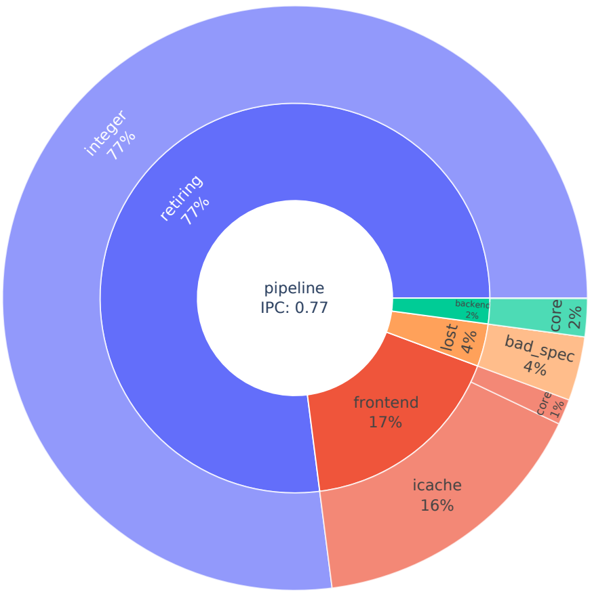
[picture p66: figure]
pipeline IPC: 0.77; retiring 77%; frontend 17%; lost 4%; backend 2%; integer 77%; icache 16%; core 1%; bad_spec 4%; core; 2% dcache 0.0172%

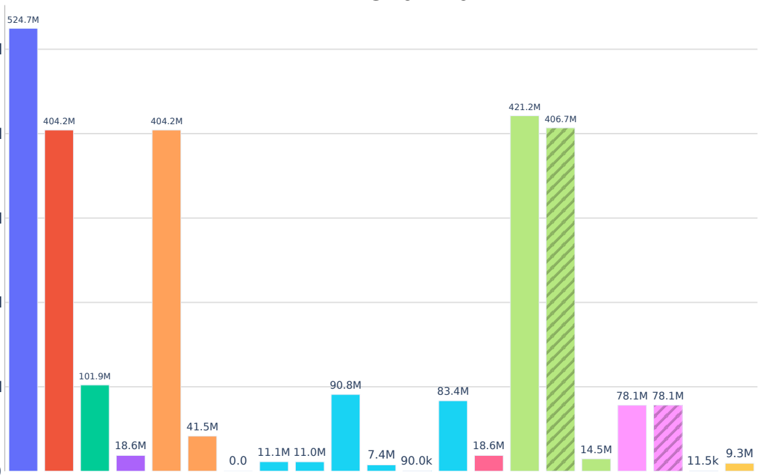
[picture p67: figure]

cycles
ret_inst

stalls
lost

ret_int
ret_ctrl_flow_br

ret_simd
stall_be
stall_be_core

stall_fe
stall_fe_core

stall_l1d

stall_l1i
bad_spec
l1i_ref

l1i_hit

l1i_miss
l1d_ref

l1d_hit

l1d_miss

bp_miss

0.0

100M

200M

300M

400M

500M

class
cycles
ret
stall
lost
ret_*
stall_*
bad_spec
l1i_*
l1d_*
bp_*

## Performance Counters for 'embench_cubic' IPC: 0.770

count

# hatched = derived

## TDA for 'embench_edn'

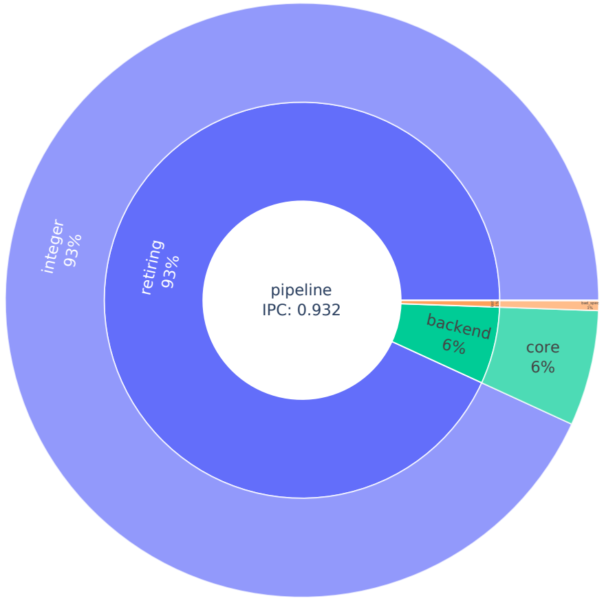
[picture p68: figure]
pipeline IPC: 0.932; retiring 93%; backend 6%; lost; 1% frontend 0.0186%; integer 93%; core 6%; bad_spec 1%; core 0.0185%

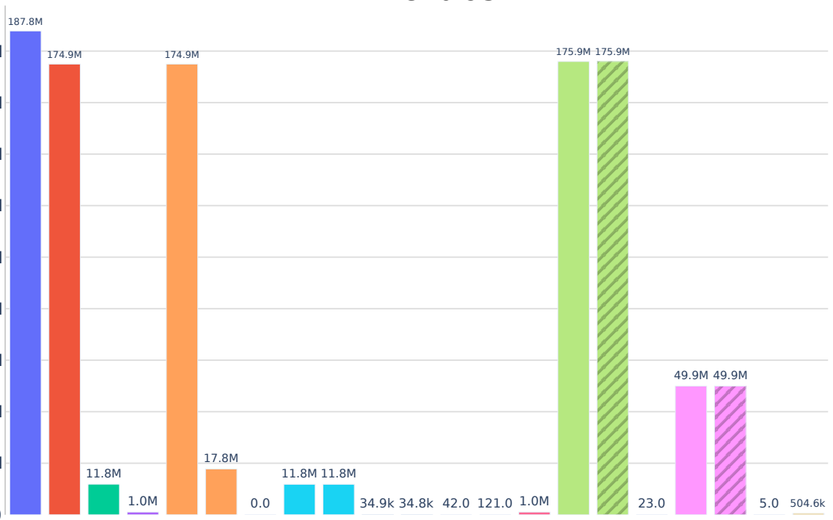
[picture p69: figure]

cycles
ret_inst

stalls
lost

ret_int
ret_ctrl_flow_br

ret_simd
stall_be
stall_be_core

stall_fe
stall_fe_core

stall_l1d

stall_l1i
bad_spec
l1i_ref

l1i_hit

l1i_miss
l1d_ref

l1d_hit

l1d_miss

bp_miss

0.0

20M

40M

60M

80M

100M

120M

140M

160M

180M

class
cycles
ret
stall
lost
ret_*
stall_*
bad_spec
l1i_*
l1d_*
bp_*

## Performance Counters for 'embench_edn' IPC: 0.932

count

# hatched = derived

## TDA for 'embench_huffbench'

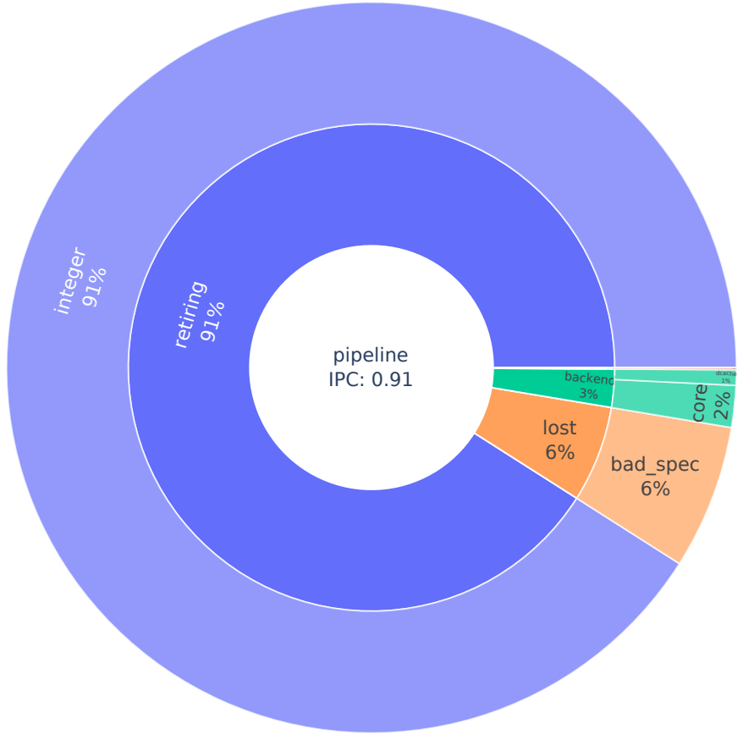
[picture p70: figure]
pipeline IPC: 0.91; retiring 91%; lost 6%; backend 3%; frontend 0.0953%; integer 91%; bad_spec 6%; core; 2% dcache 1%; core 0.0901%; icache 0.00518%

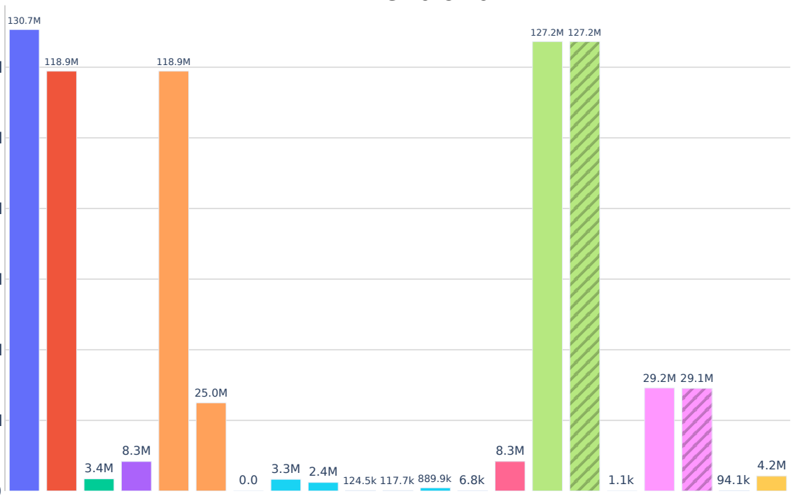
[picture p71: figure]

cycles
ret_inst

stalls
lost

ret_int
ret_ctrl_flow_br

ret_simd
stall_be
stall_be_core

stall_fe
stall_fe_core

stall_l1d

stall_l1i
bad_spec
l1i_ref

l1i_hit

l1i_miss
l1d_ref

l1d_hit

l1d_miss

bp_miss

0.0

20M

40M

60M

80M

100M

120M

class
cycles
ret
stall
lost
ret_*
stall_*
bad_spec
l1i_*
l1d_*
bp_*

## Performance Counters for 'embench_huffbench' IPC: 0.910

count

# hatched = derived

## TDA for 'embench_matmult-int'

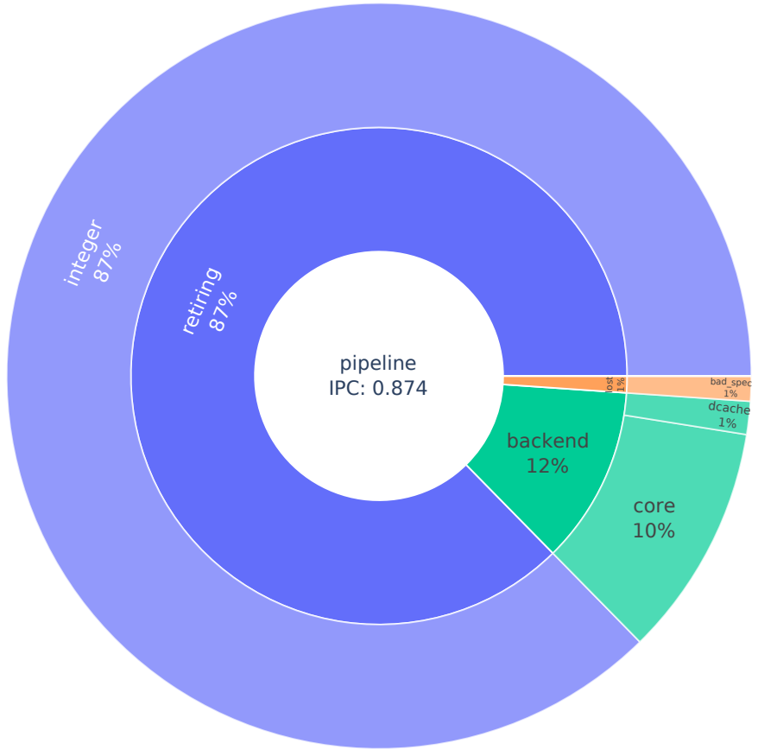
[picture p72: figure]
pipeline IPC: 0.874; retiring 87%; backend 12%; lost; 1% frontend 0.00763%; integer 87%; core 10%; dcache 1%; bad_spec 1%; core 0.00761%

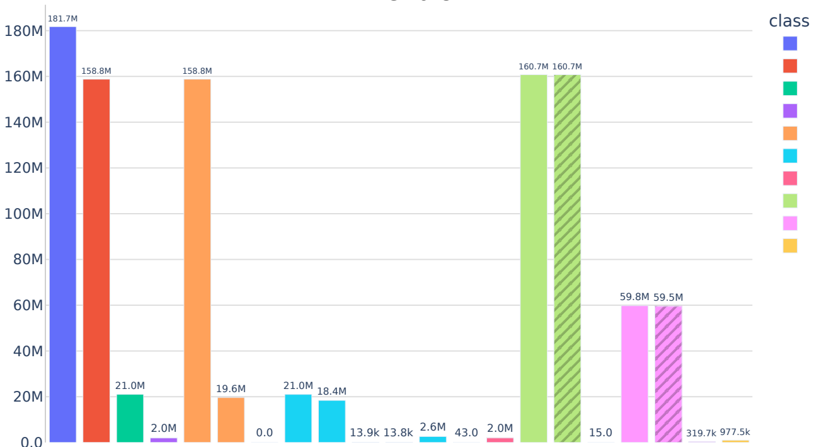
[picture p73: figure]
class

cycles
ret_inst

stalls
lost

ret_int
ret_ctrl_flow_br

ret_simd
stall_be
stall_be_core

stall_fe
stall_fe_core

stall_l1d

stall_l1i
bad_spec
l1i_ref

l1i_hit

l1i_miss
l1d_ref

l1d_hit

l1d_miss

bp_miss

0.0

20M

40M

60M

80M

100M

120M

140M

160M

cycles
ret
stall
lost
ret_*
stall_*
bad_spec
l1i_*
l1d_*
bp_*

## Performance Counters for 'embench_matmult-int' IPC: 0.874

count

# hatched = derived

## TDA for 'embench_md5sum'

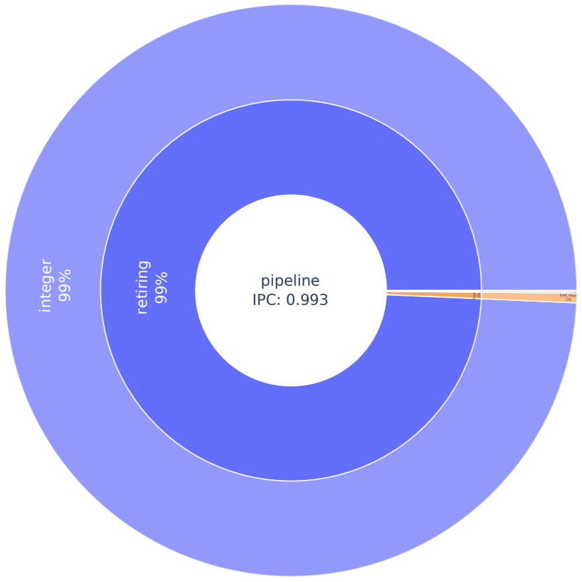
[picture p74: figure]
pipeline IPC: 0.993; retiring; lost; 1% backend 0.0892%; frontend 0.0545%; integer; bad_spec 1%; dcache 0.0891%; core 0.0544%

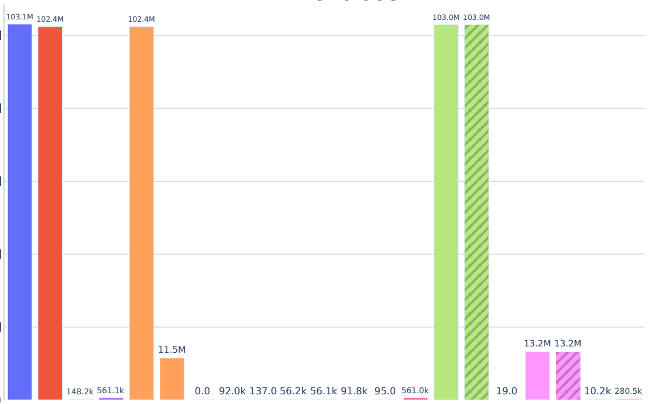
[picture p75: figure]

0.0 92.0k 137.0 56.2k 56.1k 91.8k 95.0 561.0k
cycles
ret_inst

stalls
lost

ret_int
ret_ctrl_flow_br

ret_simd
stall_be
stall_be_core

stall_fe
stall_fe_core

stall_l1d

stall_l1i
bad_spec
l1i_ref

l1i_hit

l1i_miss
l1d_ref

l1d_hit

l1d_miss

bp_miss

0.0

20M

40M

60M

80M

100M

class
cycles
ret
stall
lost
ret_*
stall_*
bad_spec
l1i_*
l1d_*
bp_*

## Performance Counters for 'embench_md5sum' IPC: 0.993

count

# hatched = derived

## TDA for 'embench_minver'

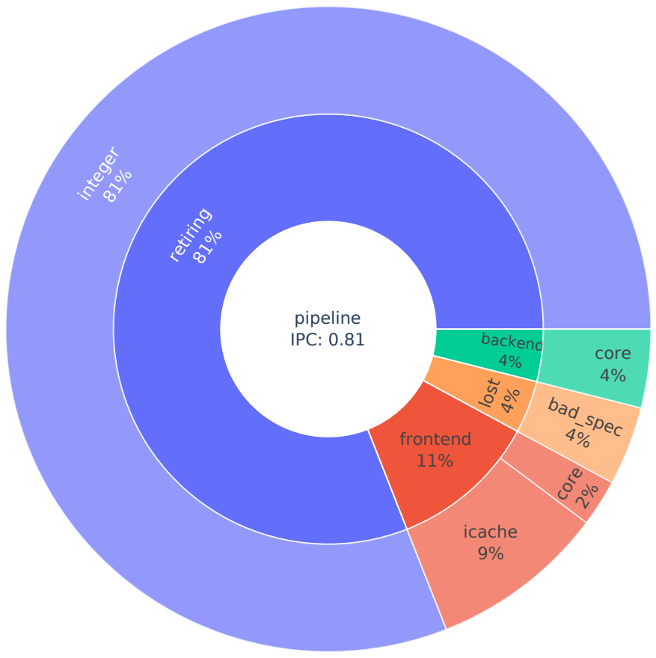
[picture p76: figure]
pipeline IPC: 0.81; retiring 81%; frontend 11%; lost 4%; backend 4%; integer 81%; icache 9%; core 2%; bad_spec 4%; core 4%

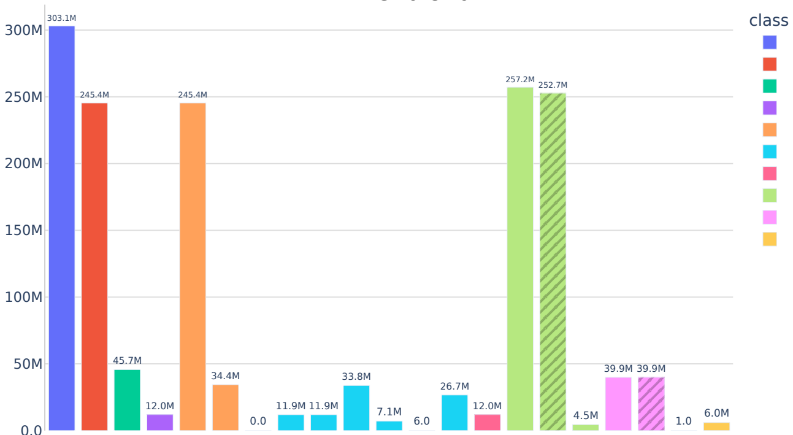
[picture p77: figure]
class

cycles
ret_inst

stalls
lost

ret_int
ret_ctrl_flow_br

ret_simd
stall_be
stall_be_core

stall_fe
stall_fe_core

stall_l1d

stall_l1i
bad_spec
l1i_ref

l1i_hit

l1i_miss
l1d_ref

l1d_hit

l1d_miss

bp_miss

0.0

50M

100M

150M

200M

250M

cycles
ret
stall
lost
ret_*
stall_*
bad_spec
l1i_*
l1d_*
bp_*

## Performance Counters for 'embench_minver' IPC: 0.810

count

# hatched = derived

## TDA for 'embench_nbody'

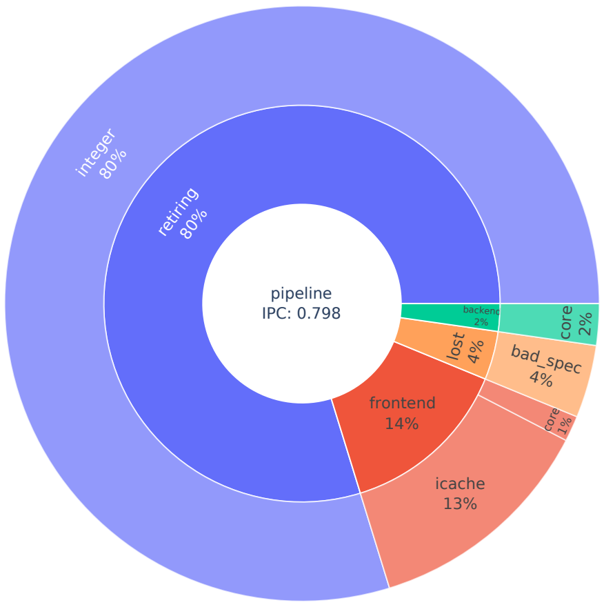
[picture p78: figure]
pipeline IPC: 0.798; retiring 80%; frontend 14%; lost 4%; backend 2%; integer 80%; icache 13%; core 1%; bad_spec 4%; core

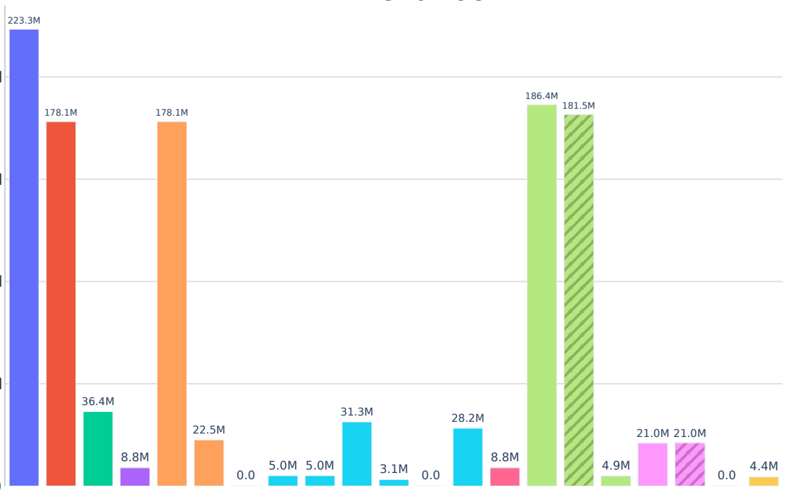
[picture p79: figure]

cycles
ret_inst

stalls
lost

ret_int
ret_ctrl_flow_br

ret_simd
stall_be
stall_be_core

stall_fe
stall_fe_core

stall_l1d

stall_l1i
bad_spec
l1i_ref

l1i_hit

l1i_miss
l1d_ref

l1d_hit

l1d_miss

bp_miss

0.0

50M

100M

150M

200M

class
cycles
ret
stall
lost
ret_*
stall_*
bad_spec
l1i_*
l1d_*
bp_*

## Performance Counters for 'embench_nbody' IPC: 0.798

count

# hatched = derived

## TDA for 'embench_nettle-aes'

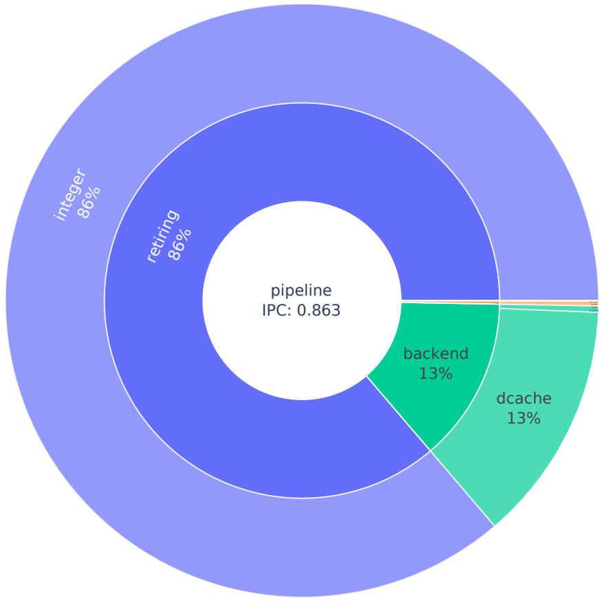
[picture p80: figure]
pipeline IPC: 0.863; retiring 86%; backend 13%; lost 0.27%; frontend 0.0166%; integer 86%; dcache 13%; core 0.342%; bad_spec 0.27%; core 0.0165%

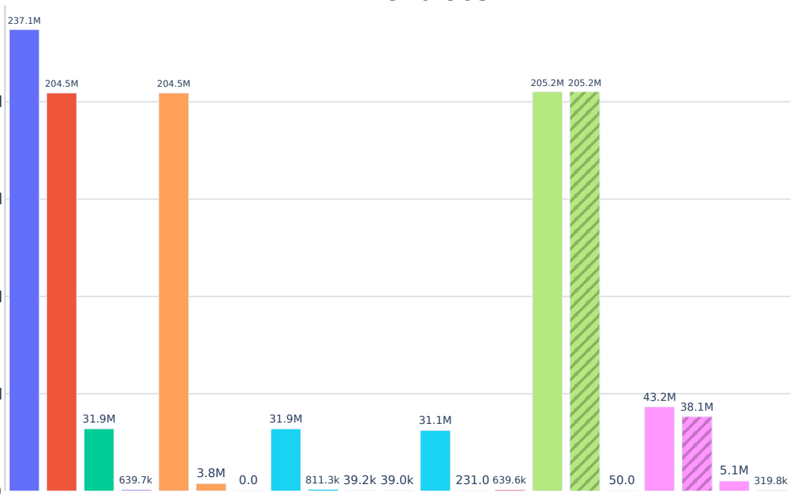
[picture p81: figure]

cycles
ret_inst

stalls
lost

ret_int
ret_ctrl_flow_br

ret_simd
stall_be
stall_be_core

stall_fe
stall_fe_core

stall_l1d

stall_l1i
bad_spec
l1i_ref

l1i_hit

l1i_miss
l1d_ref

l1d_hit

l1d_miss

bp_miss

0.0

50M

100M

150M

200M

class
cycles
ret
stall
lost
ret_*
stall_*
bad_spec
l1i_*
l1d_*
bp_*

## Performance Counters for 'embench_nettle-aes' IPC: 0.863

count

# hatched = derived

## TDA for 'embench_nettle-sha256'

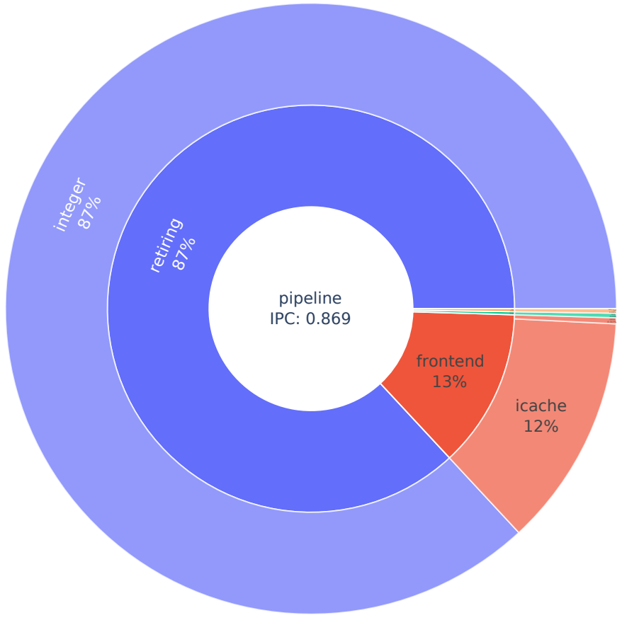
[picture p82: figure]
pipeline IPC: 0.869; retiring 87%; frontend 13%; backend 0.243%; lost; integer 87%; icache 12%; core 0.317%; core 0.243%; bad_spec 0.232%

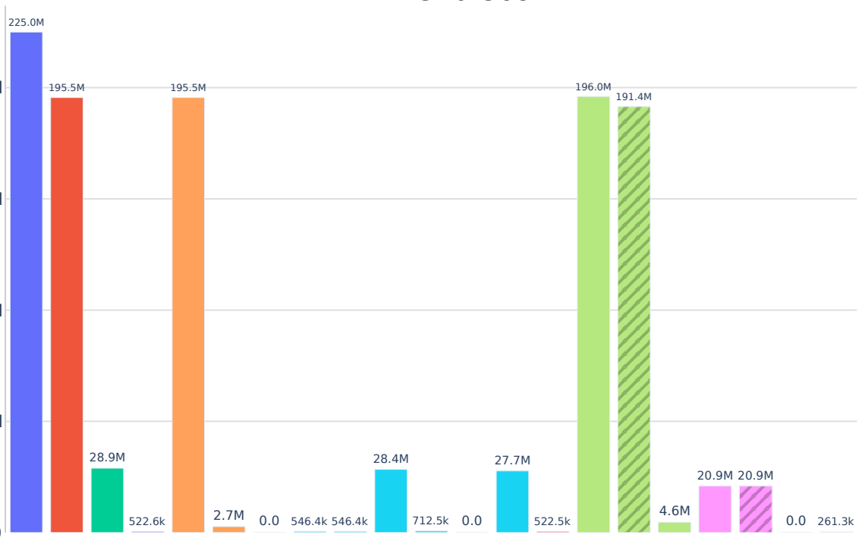
[picture p83: figure]

cycles
ret_inst

stalls
lost

ret_int
ret_ctrl_flow_br

ret_simd
stall_be
stall_be_core

stall_fe
stall_fe_core

stall_l1d

stall_l1i
bad_spec
l1i_ref

l1i_hit

l1i_miss
l1d_ref

l1d_hit

l1d_miss

bp_miss

0.0

50M

100M

150M

200M

class
cycles
ret
stall
lost
ret_*
stall_*
bad_spec
l1i_*
l1d_*
bp_*

## Performance Counters for 'embench_nettle-sha256' IPC: 0.869

count

# hatched = derived

## TDA for 'embench_nsichneu'

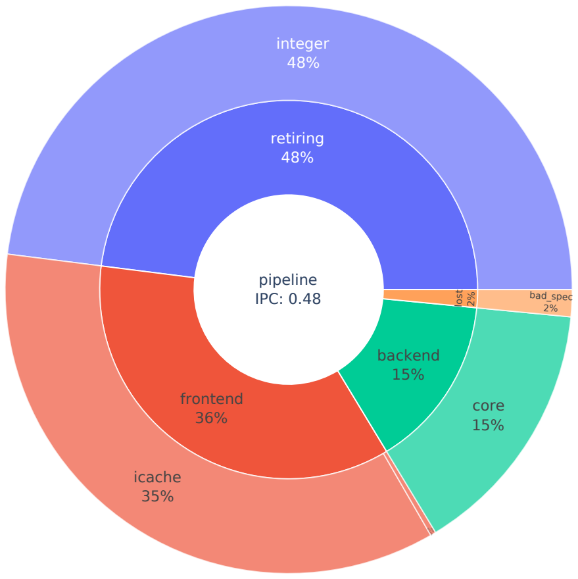
[picture p84: figure]
pipeline IPC: 0.48; retiring 48%; frontend 36%; backend 15%; lost; integer 48%; icache 35%; core; core 15%; bad_spec 2%

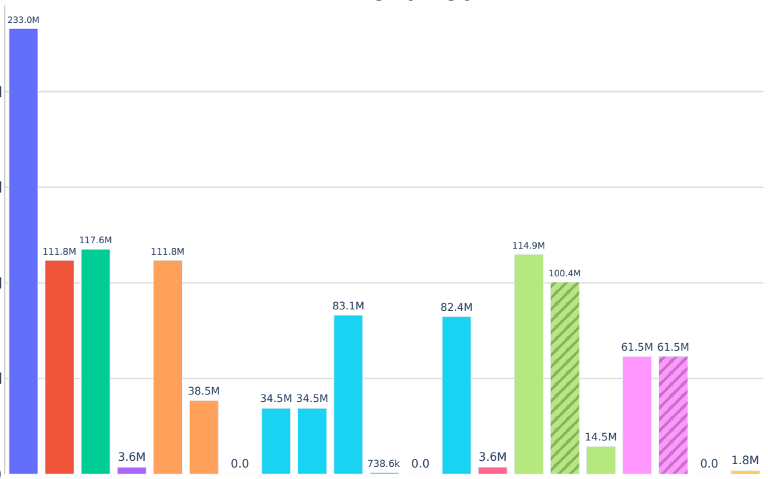
[picture p85: figure]

cycles
ret_inst

stalls
lost

ret_int
ret_ctrl_flow_br

ret_simd
stall_be
stall_be_core

stall_fe
stall_fe_core

stall_l1d

stall_l1i
bad_spec
l1i_ref

l1i_hit

l1i_miss
l1d_ref

l1d_hit

l1d_miss

bp_miss

0.0

50M

100M

150M

200M

class
cycles
ret
stall
lost
ret_*
stall_*
bad_spec
l1i_*
l1d_*
bp_*

## Performance Counters for 'embench_nsichneu' IPC: 0.480

count

# hatched = derived

## TDA for 'embench_picojpeg'

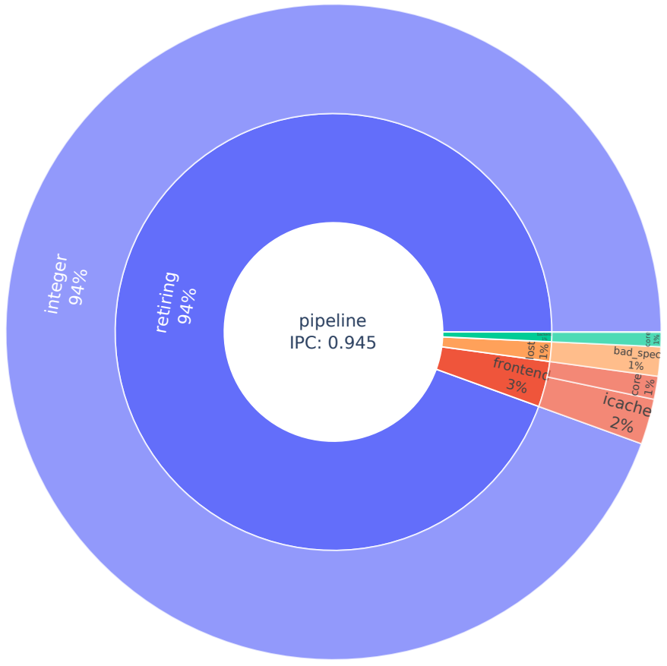
[picture p86: figure]
pipeline IPC: 0.945; retiring 94%; frontend 3%; lost 1%; backend 1%; integer 94%; icache 2%; core 1%; bad_spec 1%; core; 1% dcache 0.0085%

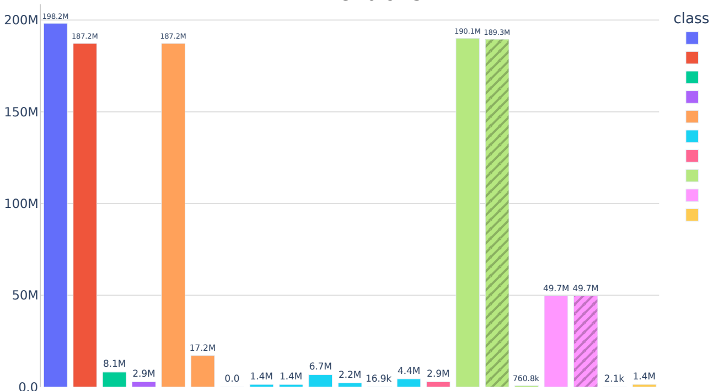
[picture p87: figure]
class

cycles
ret_inst

stalls
lost

ret_int
ret_ctrl_flow_br

ret_simd
stall_be
stall_be_core

stall_fe
stall_fe_core

stall_l1d

stall_l1i
bad_spec
l1i_ref

l1i_hit

l1i_miss
l1d_ref

l1d_hit

l1d_miss

bp_miss

0.0

50M

100M

150M

cycles
ret
stall
lost
ret_*
stall_*
bad_spec
l1i_*
l1d_*
bp_*

## Performance Counters for 'embench_picojpeg' IPC: 0.945

count

# hatched = derived

## TDA for 'embench_primecount'

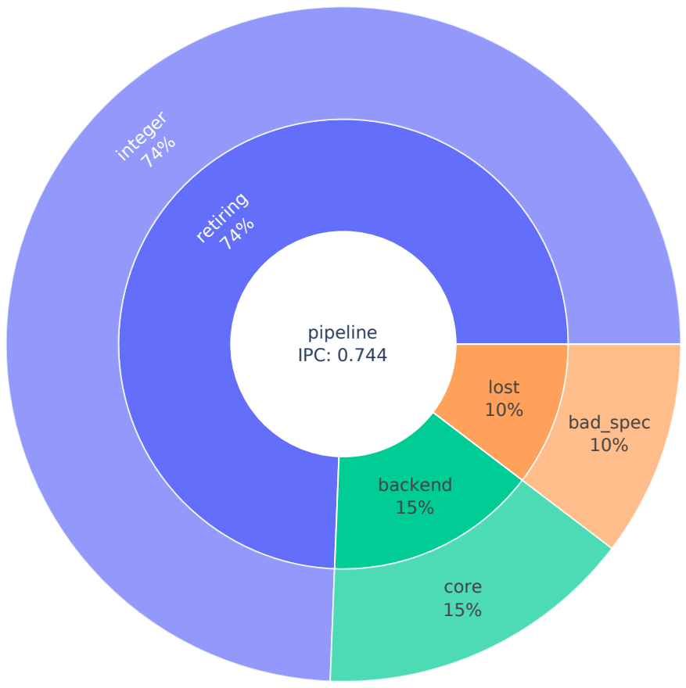
[picture p88: figure]
pipeline IPC: 0.744; retiring 74%; backend 15%; lost 10%; integer 74%; core 15%; bad_spec 10%

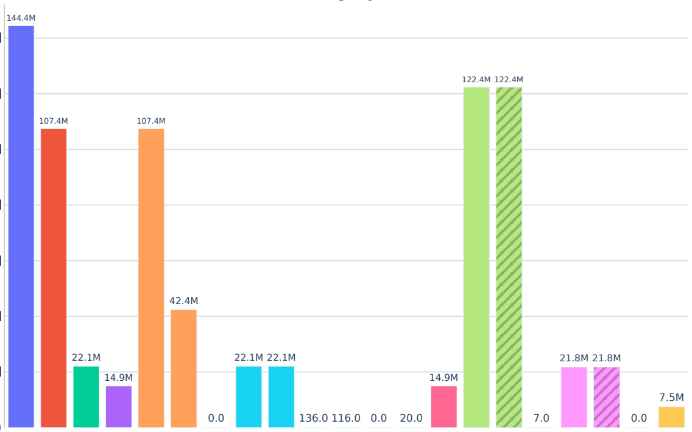
[picture p89: figure]

cycles
ret_inst

stalls
lost

ret_int
ret_ctrl_flow_br

ret_simd
stall_be
stall_be_core

stall_fe
stall_fe_core

stall_l1d

stall_l1i
bad_spec
l1i_ref

l1i_hit

l1i_miss
l1d_ref

l1d_hit

l1d_miss

bp_miss

0.0

20M

40M

60M

80M

100M

120M

140M

class
cycles
ret
stall
lost
ret_*
stall_*
bad_spec
l1i_*
l1d_*
bp_*

## Performance Counters for 'embench_primecount' IPC: 0.744

count

# hatched = derived

## TDA for 'embench_qrduino'

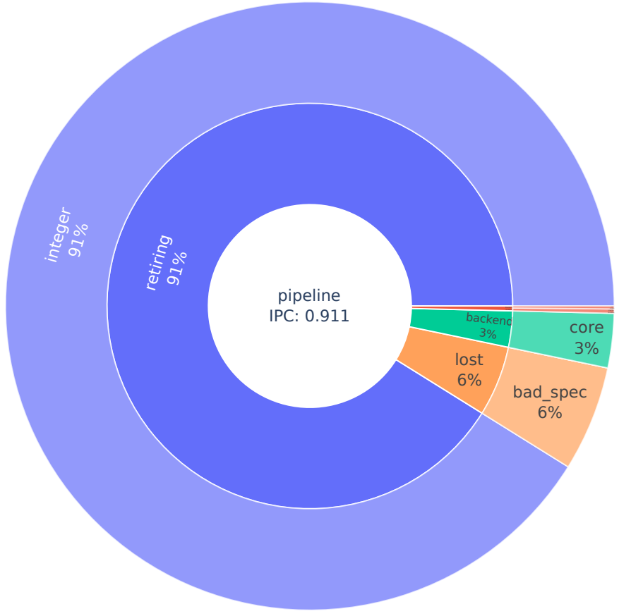
[picture p90: figure]
pipeline IPC: 0.911; retiring 91%; lost 6%; backend 3%; frontend 0.383%; integer 91%; bad_spec 6%; core 3%; icache 0.228%; core 0.156%

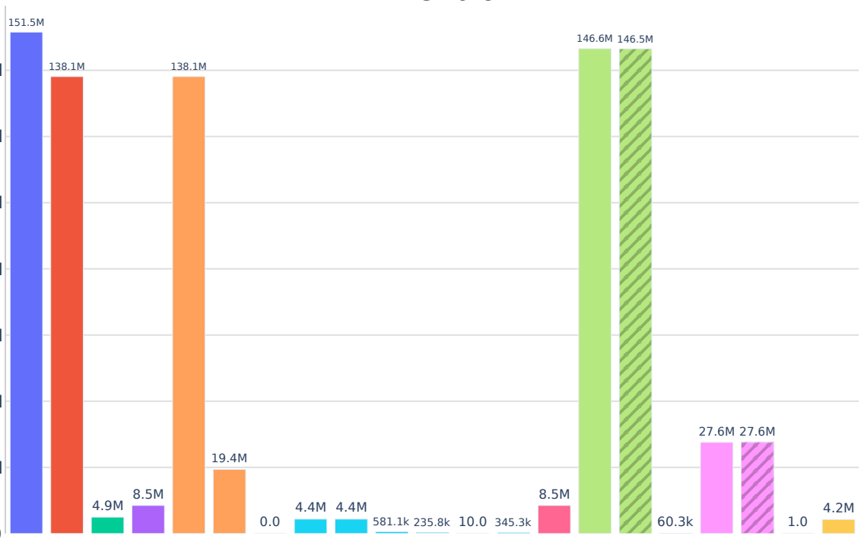
[picture p91: figure]

cycles
ret_inst

stalls
lost

ret_int
ret_ctrl_flow_br

ret_simd
stall_be
stall_be_core

stall_fe
stall_fe_core

stall_l1d

stall_l1i
bad_spec
l1i_ref

l1i_hit

l1i_miss
l1d_ref

l1d_hit

l1d_miss

bp_miss

0.0

20M

40M

60M

80M

100M

120M

140M

class
cycles
ret
stall
lost
ret_*
stall_*
bad_spec
l1i_*
l1d_*
bp_*

## Performance Counters for 'embench_qrduino' IPC: 0.911

count

# hatched = derived

## TDA for 'embench_sglib-combined'

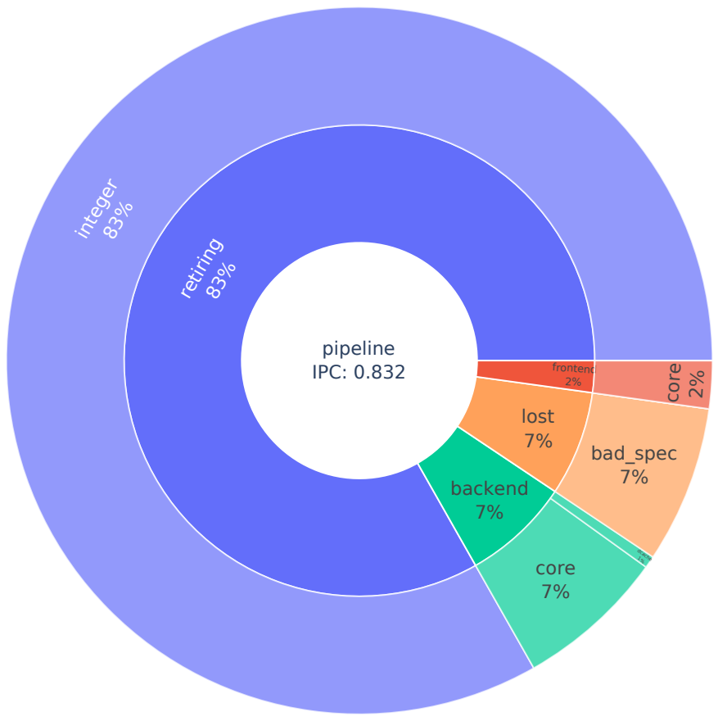
[picture p92: figure]
pipeline IPC: 0.832; retiring 83%; backend 7%; lost 7%; frontend 2%; integer 83%; core 7%; dcache 1%; bad_spec 7%; core

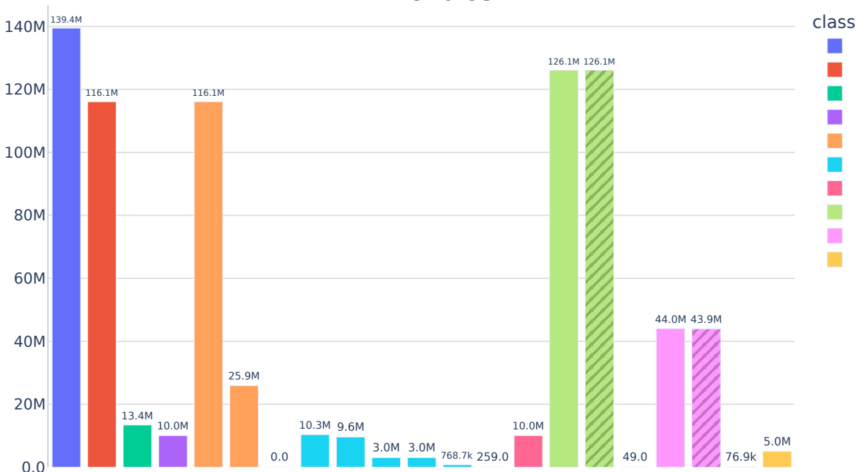
[picture p93: figure]
class

cycles
ret_inst

stalls
lost

ret_int
ret_ctrl_flow_br

ret_simd
stall_be
stall_be_core

stall_fe
stall_fe_core

stall_l1d

stall_l1i
bad_spec
l1i_ref

l1i_hit

l1i_miss
l1d_ref

l1d_hit

l1d_miss

bp_miss

0.0

20M

40M

60M

80M

100M

120M

cycles
ret
stall
lost
ret_*
stall_*
bad_spec
l1i_*
l1d_*
bp_*

## Performance Counters for 'embench_sglib-combined' IPC: 0.832

count

# hatched = derived

## TDA for 'embench_slre'

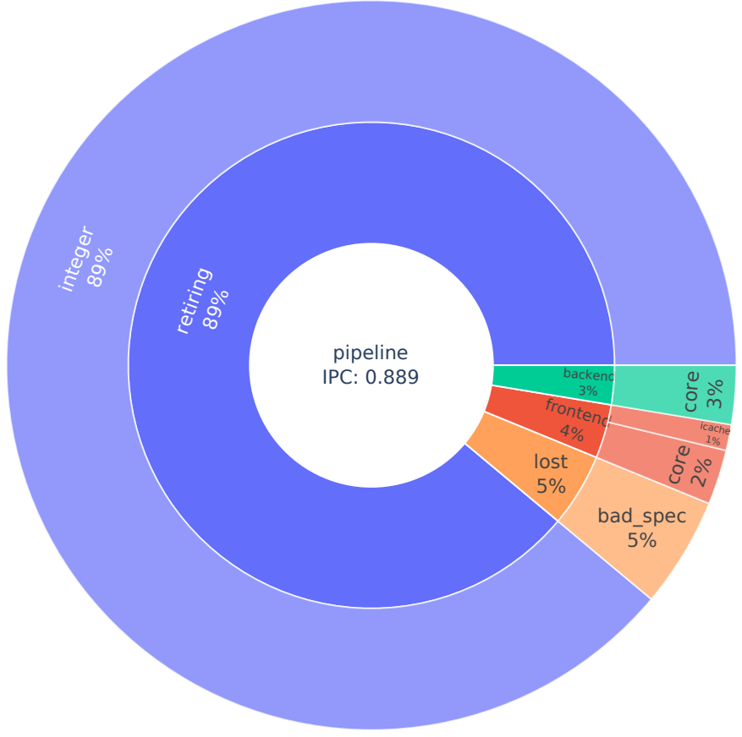
[picture p94: figure]
pipeline IPC: 0.889; retiring 89%; lost 5%; frontend 4%; backend 3%; integer 89%; bad_spec 5%; core 2%; icache 1%; core 3%

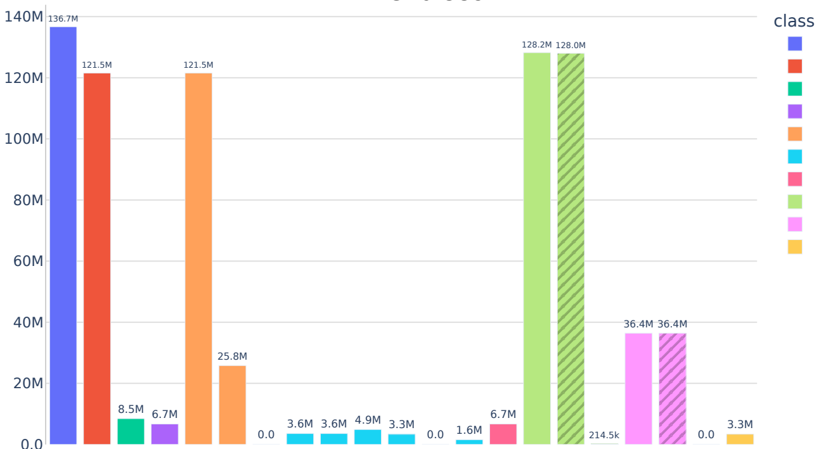
[picture p95: figure]
class

cycles
ret_inst

stalls
lost

ret_int
ret_ctrl_flow_br

ret_simd
stall_be
stall_be_core

stall_fe
stall_fe_core

stall_l1d

stall_l1i
bad_spec
l1i_ref

l1i_hit

l1i_miss
l1d_ref

l1d_hit

l1d_miss

bp_miss

0.0

20M

40M

60M

80M

100M

120M

cycles
ret
stall
lost
ret_*
stall_*
bad_spec
l1i_*
l1d_*
bp_*

## Performance Counters for 'embench_slre' IPC: 0.889

count

# hatched = derived

## TDA for 'embench_st'

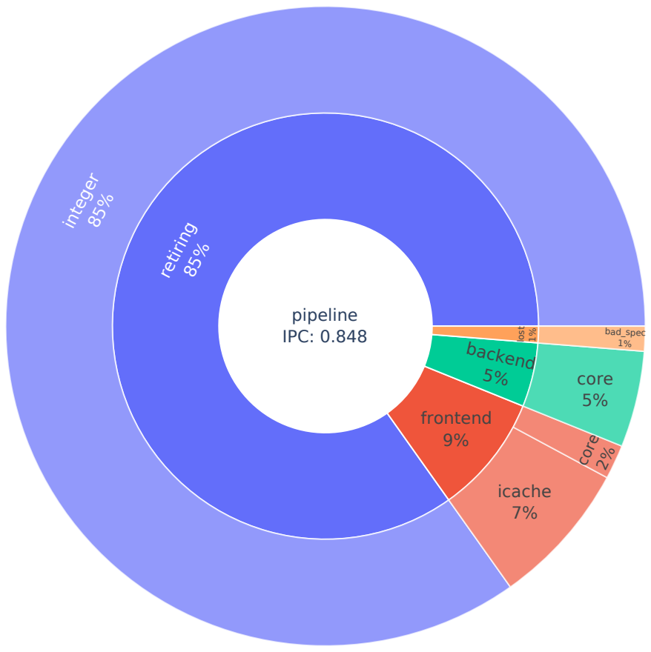
[picture p96: figure]
pipeline IPC: 0.848; retiring 85%; frontend 9%; backend 5%; lost; integer 85%; icache 7%; core 2%; core 5%; bad_spec 1%

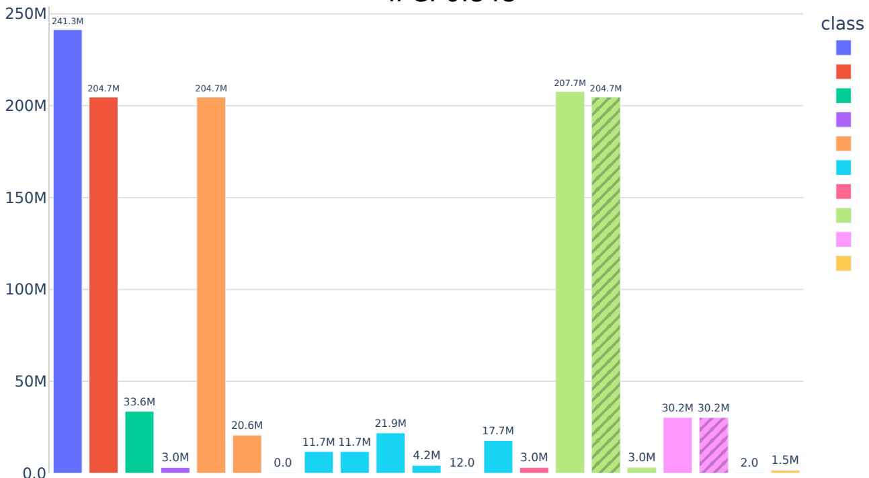
[picture p97: figure]
class

cycles
ret_inst

stalls
lost

ret_int
ret_ctrl_flow_br

ret_simd
stall_be
stall_be_core

stall_fe
stall_fe_core

stall_l1d

stall_l1i
bad_spec
l1i_ref

l1i_hit

l1i_miss
l1d_ref

l1d_hit

l1d_miss

bp_miss

0.0

50M

100M

150M

200M

cycles
ret
stall
lost
ret_*
stall_*
bad_spec
l1i_*
l1d_*
bp_*

## Performance Counters for 'embench_st' IPC: 0.848

count

# hatched = derived

## TDA for 'embench_statemate'

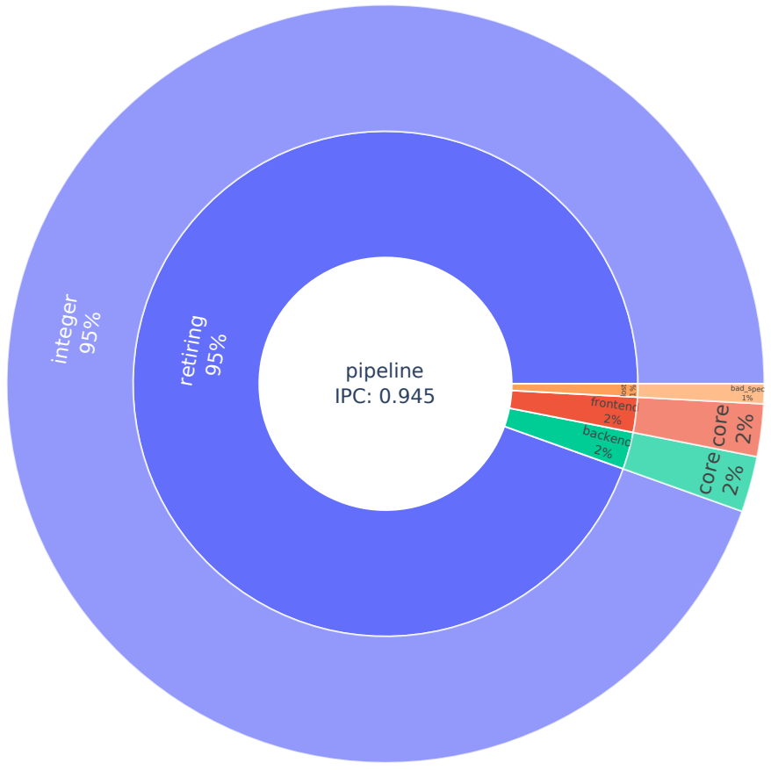
[picture p98: figure]
pipeline IPC: 0.945; retiring 95%; backend 2%; frontend; 2%lost; integer 95%; core 2%; bad_spec 1%

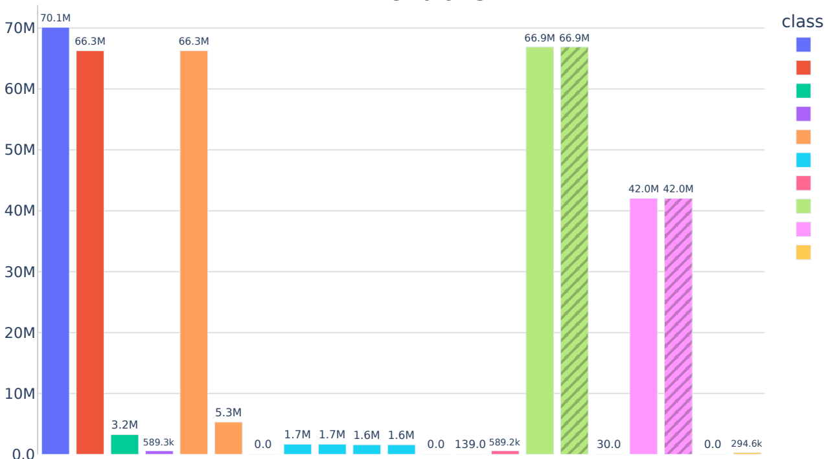
[picture p99: figure]
0.0 139.0 ⁵⁸⁹.2k; class

cycles
ret_inst

stalls
lost

ret_int
ret_ctrl_flow_br

ret_simd
stall_be
stall_be_core

stall_fe
stall_fe_core

stall_l1d

stall_l1i
bad_spec
l1i_ref

l1i_hit

l1i_miss
l1d_ref

l1d_hit

l1d_miss

bp_miss

0.0

10M

20M

30M

40M

50M

60M

cycles
ret
stall
lost
ret_*
stall_*
bad_spec
l1i_*
l1d_*
bp_*

## Performance Counters for 'embench_statemate' IPC: 0.945

count

# hatched = derived

## TDA for 'embench_tarfind'

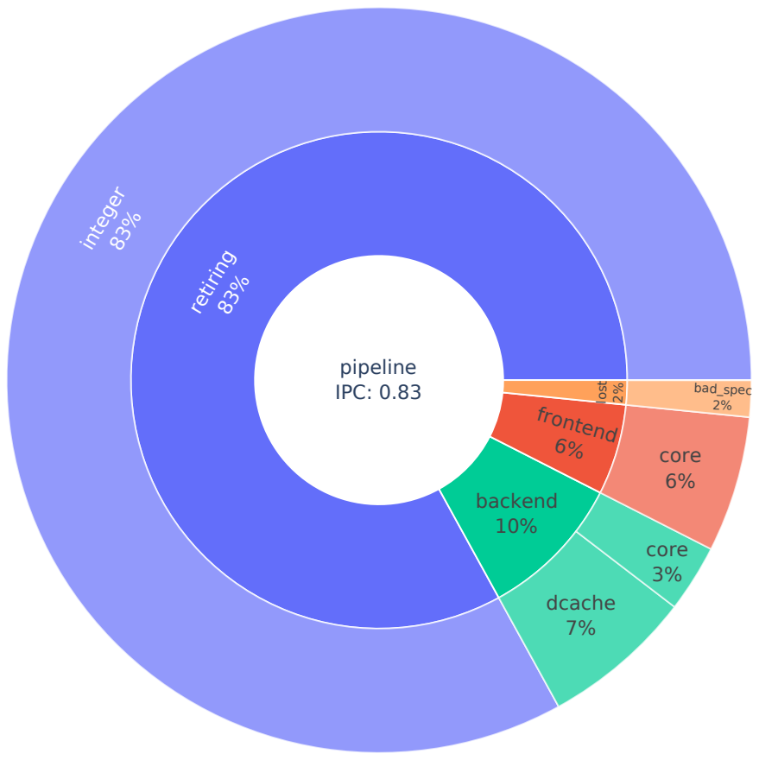
[picture p100: figure]
pipeline IPC: 0.83; retiring 83%; backend 10%; frontend 6%; lost; integer 83%; dcache 7%; core 3%; core 6%; bad_spec 2%; o the r 0 .00 336 %

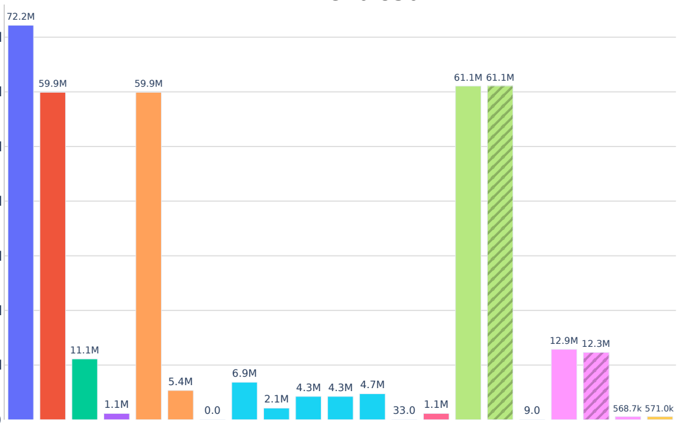
[picture p101: figure]

cycles
ret_inst

stalls
lost

ret_int
ret_ctrl_flow_br

ret_simd
stall_be
stall_be_core

stall_fe
stall_fe_core

stall_l1d

stall_l1i
bad_spec
l1i_ref

l1i_hit

l1i_miss
l1d_ref

l1d_hit

l1d_miss

bp_miss

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
class
cycles
ret
stall
lost
ret_*
stall_*
bad_spec
l1i_*
l1d_*
bp_*

## Performance Counters for 'embench_tarfind' IPC: 0.830

count

# hatched = derived

## TDA for 'embench_ud'

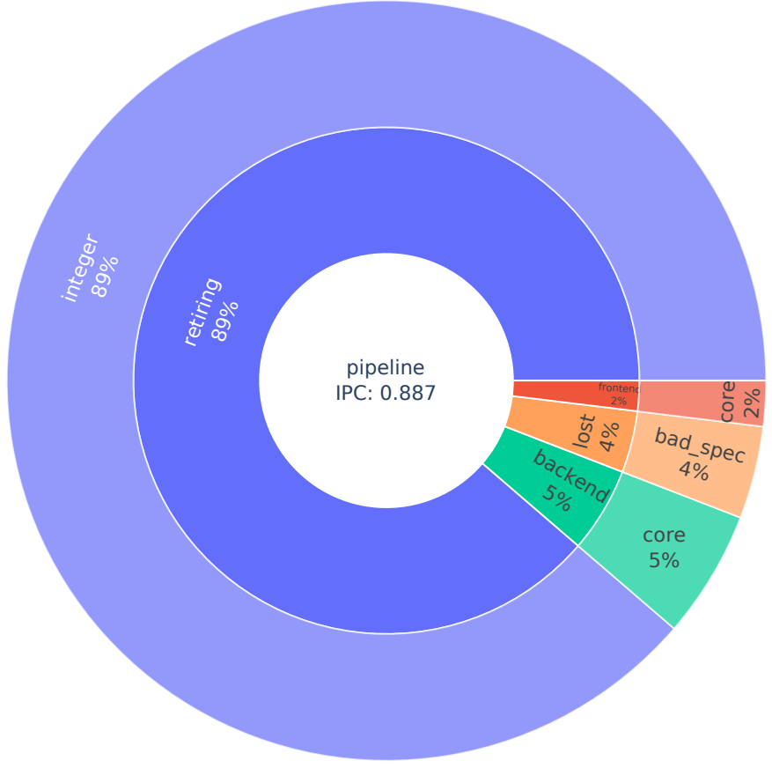
[picture p102: figure]
pipeline IPC: 0.887; retiring 89%; backend 5%; lost 4%; frontend 2%; integer 89%; core 5%; bad_spec 4%; core

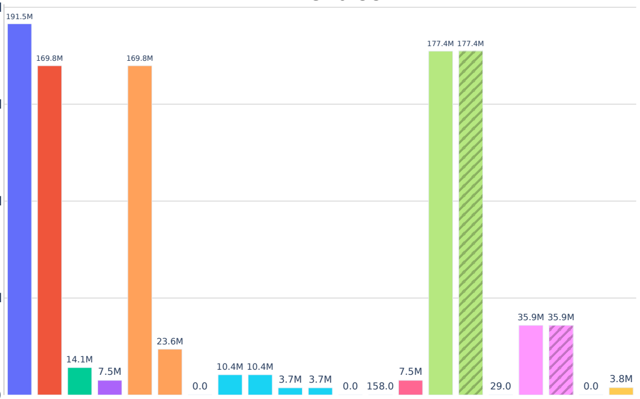
[picture p103: figure]

cycles
ret_inst

stalls
lost

ret_int
ret_ctrl_flow_br

ret_simd
stall_be
stall_be_core

stall_fe
stall_fe_core

stall_l1d

stall_l1i
bad_spec
l1i_ref

l1i_hit

l1i_miss
l1d_ref

l1d_hit

l1d_miss

bp_miss

0.0

50M

100M

150M

200M
class
cycles
ret
stall
lost
ret_*
stall_*
bad_spec
l1i_*
l1d_*
bp_*

## Performance Counters for 'embench_ud' IPC: 0.887

count

# hatched = derived

## TDA for 'embench_wikisort'

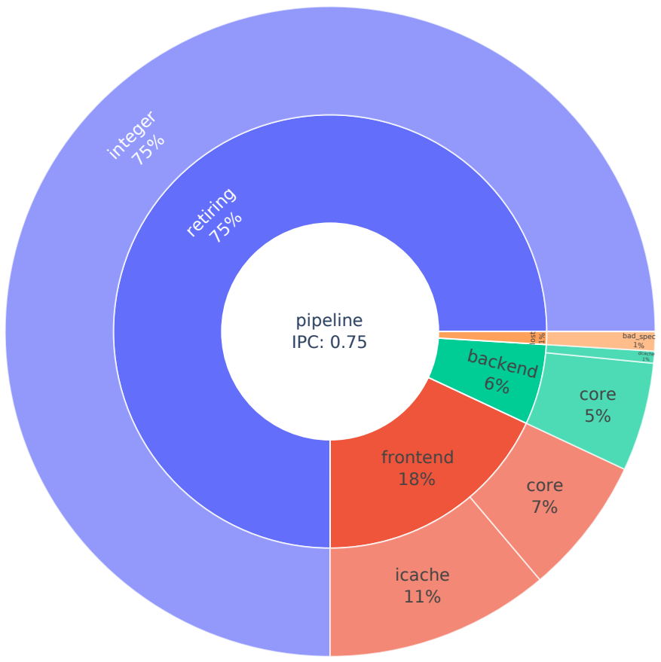
[picture p104: figure]
pipeline IPC: 0.75; retiring 75%; frontend 18%; backend 6%; lost; integer 75%; icache 11%; core 7%; core 5%; dcache 1%; bad_spec 1%

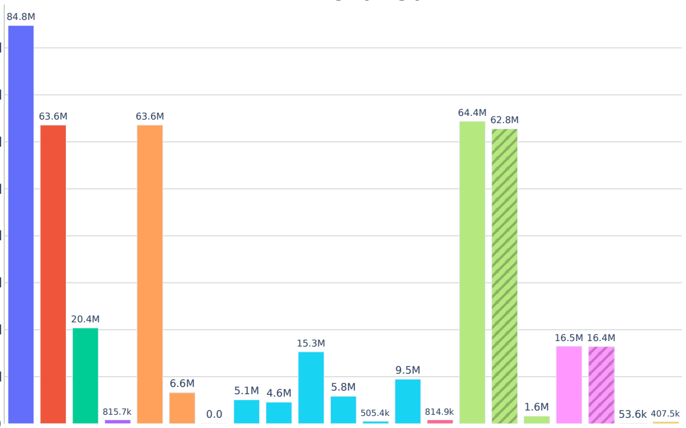
[picture p105: figure]

cycles
ret_inst

stalls
lost

ret_int
ret_ctrl_flow_br

ret_simd
stall_be
stall_be_core

stall_fe
stall_fe_core

stall_l1d

stall_l1i
bad_spec
l1i_ref

l1i_hit

l1i_miss
l1d_ref

l1d_hit

l1d_miss

bp_miss

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
class
cycles
ret
stall
lost
ret_*
stall_*
bad_spec
l1i_*
l1d_*
bp_*

## Performance Counters for 'embench_wikisort' IPC: 0.750

count

# hatched = derived
