AleksandarLilic/ama-riscv/examples/perf_runs_fpga/hw_stats_benchmarks.csv

name | ipc | cycles | empty | stalls | lost | lost_other | bad_spec | stall_be | stall_l1d | stall_be_core | stall_fe | stall_l1i | stall_fe_core | ret_inst | ret_simd | ret_int | ret_ctrl_flow_br | bp_miss | l1i_ref | l1i_miss | l1d_ref | l1d_miss | l1i_hit | l1d_hit | li1_hr | li1_mpki | ld1_hr | ld1_mpki | bp_acc | bp_mpki
coremark | 0.893 | 578803779 | 62160350 | 45422759 | 16737591 | 77 | 16737514 | 38251581 | 54 | 38251527 | 7171178 | 185890 | 6985288 | 516643429 | 0 | 516643429 | 92541716 | 8368786 | 533347311 | 32057 | 109847580 | 9 | 533315254 | 109847571 | 99.99 | 0.06 | 100.0 | 0.0 | 90.96 | 16.2
dhrystone | 0.91 | 354000697 | 32000540 | 32000404 | 136 | 78 | 58 | 4000173 | 20 | 4000153 | 28000231 | 204 | 28000027 | 322000157 | 0 | 322000157 | 29000017 | 35 | 322000277 | 42 | 130000018 | 2 | 322000235 | 130000016 | 100.0 | 0.0 | 100.0 | 0.0 | 100.0 | 0.0
stream_int | 0.829 | 2076686 | 355656 | 355466 | 190 | 58 | 132 | 355428 | 293000 | 62428 | 38 | 33 | 5 | 1721030 | 0 | 1721030 | 245851 | 68 | 1721227 | 10 | 614522 | 38508 | 1721217 | 576014 | 100.0 | 0.01 | 93.73 | 22.37 | 99.97 | 0.04
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
