AleksandarLilic/ama-riscv/src/ama_riscv_top.sv

`include "ama_riscv_defines.svh"

module ama_riscv_top #(
    parameter unsigned CLOCK_FREQ = 100_000_000,
    parameter unsigned UART_BR = BR_115200
)(
    input  logic clk,
    input  logic rst,
    input  logic uart_serial_in,
    output logic uart_serial_out,
    output logic inst_retired
);

// icache <-> main mem
rv_if #(.DW(MEM_ADDR_BUS)) mem_r_req_ch_imem ();
rv_if #(.DW(MEM_DATA_BUS)) mem_r_rsp_ch_imem ();
// dcache <-> main mem
rv_if #(.DW(MEM_ADDR_BUS)) mem_r_req_ch_dmem ();
rv_if_da #(.AW(MEM_ADDR_BUS), .DW(MEM_DATA_BUS)) mem_w_req_ch_dmem ();
rv_if #(.DW(MEM_DATA_BUS)) mem_r_rsp_ch_dmem ();

// core <-> uart
uart_if uart_ch ();
logic meip;

ama_riscv_core_top #(
    .CLOCK_FREQ (CLOCK_FREQ)
) core_top_i(
    .clk (clk),
    .rst (rst),
    .req_imem (mem_r_req_ch_imem.TX),
    .rsp_imem (mem_r_rsp_ch_imem.RX),
    .req_dmem_r (mem_r_req_ch_dmem.TX),
    .req_dmem_w (mem_w_req_ch_dmem.TX),
    .rsp_dmem (mem_r_rsp_ch_dmem.RX),
    .uart_ch (uart_ch.TX),
    .meip (meip),
    .inst_retired (inst_retired)
);

ama_riscv_mem mem_i (
    .clk (clk),
    .rst (rst),
    .req_imem (mem_r_req_ch_imem.RX),
    .rsp_imem (mem_r_rsp_ch_imem.TX),
    .req_dmem_r (mem_r_req_ch_dmem.RX),
    .req_dmem_w (mem_w_req_ch_dmem.RX),
    .rsp_dmem (mem_r_rsp_ch_dmem.TX)
);

ama_riscv_uart # (
    .CLOCK_FREQ (CLOCK_FREQ),
    .BAUD_RATE (UART_BR)
) uart_i (
    .clk (clk),
    .rst (rst),
    .uart_ch (uart_ch.RX),
    .meip (meip),
    .serial_in (uart_serial_in),
    .serial_out (uart_serial_out)
);

endmodule
