AleksandarLilic/ama-riscv/fpga/constraints/arty_a7-100_ama_riscv_fpga.xdc

set_property CFGBVS VCCO [current_design]
set_property CONFIG_VOLTAGE 3.3 [current_design]

set_property -dict { PACKAGE_PIN E3    IOSTANDARD LVCMOS33 } [get_ports { CLK_BOARD }]; #IO_L12P_T1_MRCC_35 Sch=gclk[100]
create_clock -add -name sys_clk_pin -period 10.00 -waveform {0 5} [get_ports { CLK_BOARD }];

## LEDs
set_property -dict { PACKAGE_PIN H5    IOSTANDARD LVCMOS33 } [get_ports { LEDS[0] }]; #IO_L24N_T3_35 Sch=led[4]
set_property -dict { PACKAGE_PIN J5    IOSTANDARD LVCMOS33 } [get_ports { LEDS[1] }]; #IO_25_35 Sch=led[5]
set_property -dict { PACKAGE_PIN T9    IOSTANDARD LVCMOS33 } [get_ports { LEDS[2] }]; #IO_L24P_T3_A01_D17_14 Sch=led[6]
set_property -dict { PACKAGE_PIN T10   IOSTANDARD LVCMOS33 } [get_ports { LEDS[3] }]; #IO_L24N_T3_A00_D16_14 Sch=led[7]

## Buttons
set_property -dict { PACKAGE_PIN D9    IOSTANDARD LVCMOS33 } [get_ports { RST_BOARD }]; #IO_L6N_T0_VREF_16 Sch=btn[0]

## USB-UART Interface
set_property -dict { PACKAGE_PIN D10   IOSTANDARD LVCMOS33 } [get_ports { FPGA_SERIAL_TX }]; #IO_L19N_T3_VREF_16 Sch=uart_rxd_out
set_property -dict { PACKAGE_PIN A9    IOSTANDARD LVCMOS33 } [get_ports { FPGA_SERIAL_RX }]; #IO_L14N_T2_SRCC_16 Sch=uart_txd_in

## Async I/O false paths
set_false_path -from [get_ports { RST_BOARD }]
set_false_path -to   [get_ports { LEDS[*] }]
set_false_path -to   [get_ports { FPGA_SERIAL_TX }]
set_false_path -from [get_ports { FPGA_SERIAL_RX }]
