AleksandarLilic/ama-riscv/fpga/constraints/zybo_z7_button_parser_fpga.xdc

# Clock signal
set_property -dict { PACKAGE_PIN K17   IOSTANDARD LVCMOS33 } [get_ports { CLK_125MHZ_FPGA }]; #IO_L12P_T1_MRCC_35 Sch=sysclk
#create_clock -add -name sys_clk_pin -period 8.00 -waveform {0 4} [get_ports { CLK_125MHZ_FPGA }];

# Switches
set_property -dict { PACKAGE_PIN G15   IOSTANDARD LVCMOS33 } [get_ports { SWITCHES[0] }]; #IO_L19N_T3_VREF_35 Sch=sw[0]
set_property -dict { PACKAGE_PIN P15   IOSTANDARD LVCMOS33 } [get_ports { SWITCHES[1] }]; #IO_L24P_T3_34 Sch=sw[1]
#set_property -dict { PACKAGE_PIN W13   IOSTANDARD LVCMOS33 } [get_ports { sw[2] }]; #IO_L4N_T0_34 Sch=sw[2]
set_property -dict { PACKAGE_PIN T16   IOSTANDARD LVCMOS33 } [get_ports { RST }]; #IO_L9P_T1_DQS_34 Sch=sw[3]

# Buttons
set_property -dict { PACKAGE_PIN K18   IOSTANDARD LVCMOS33 } [get_ports { BUTTONS[0] }]; #IO_L12N_T1_MRCC_35 Sch=btn[0]
set_property -dict { PACKAGE_PIN P16   IOSTANDARD LVCMOS33 } [get_ports { BUTTONS[1] }]; #IO_L24N_T3_34 Sch=btn[1]
set_property -dict { PACKAGE_PIN K19   IOSTANDARD LVCMOS33 } [get_ports { BUTTONS[2] }]; #IO_L10P_T1_AD11P_35 Sch=btn[2]
set_property -dict { PACKAGE_PIN Y16   IOSTANDARD LVCMOS33 } [get_ports { BUTTONS[3] }]; #IO_L7P_T1_34 Sch=btn[3]

# LEDs
set_property -dict { PACKAGE_PIN M14   IOSTANDARD LVCMOS33 } [get_ports { LEDS[0] }]; #IO_L23P_T3_35 Sch=led[0]
set_property -dict { PACKAGE_PIN M15   IOSTANDARD LVCMOS33 } [get_ports { LEDS[1] }]; #IO_L23N_T3_35 Sch=led[1]
set_property -dict { PACKAGE_PIN G14   IOSTANDARD LVCMOS33 } [get_ports { LEDS[2] }]; #IO_0_35 Sch=led[2]
set_property -dict { PACKAGE_PIN D18   IOSTANDARD LVCMOS33 } [get_ports { LEDS[3] }]; #IO_L3N_T0_DQS_AD1N_35 Sch=led[3]

# RGB LED 6
#set_property -dict { PACKAGE_PIN V16   IOSTANDARD LVCMOS33 } [get_ports { LEDS[4] }]; #IO_L18P_T2_34 Sch=led6_r
set_property -dict { PACKAGE_PIN F17   IOSTANDARD LVCMOS33 } [get_ports { LEDS[4] }]; #IO_L6N_T0_VREF_35 Sch=led6_g
set_property -dict { PACKAGE_PIN M17   IOSTANDARD LVCMOS33 } [get_ports { LEDS[5] }]; #IO_L8P_T1_AD10P_35 Sch=led6_b
