AleksandarLilic/ama-riscv/src/ama_riscv_core.sv

`include "ama_riscv_defines.svh"

module ama_riscv_core #(
    parameter bit SIMD_EN = 1,
    parameter bit MULT_USE_BW = 1
)(
    input  logic clk,
    input  logic rst,
    input perf_event_icache_t pe_ic,
    input perf_event_dcache_t pe_dc,
    rv_if.TX     imem_req,
    rv_if.RX     imem_rsp,
    rv_if_dc.TX  dmem_req,
    rv_if.RX     dmem_rsp,
    uart_if.TX   uart_ch,
    clint_if.TX  clint_ch,
    input  logic mtip,
    input  logic meip,
    output spec_exec_t spec,
    output logic inst_retired
);

localparam unsigned PIPE_STAGES = 4;
localparam logic [PIPE_STAGES-1:0] RST_INIT = ((1 << PIPE_STAGES) - 1);

pipeline_if #(.W(INST_WIDTH)) inst ();
pipeline_if #(.W(ARCH_WIDTH)) pc ();
pipeline_if_s flush ();
pipeline_if_s pc_nz ();
pipeline_if_typed #(.T(rf_addr_t)) rd_addr ();
pipeline_if_typed #(.T(rf_we_t)) rf_we ();
pipeline_if_typed #(.T(trap_tag_t)) trap_tag ();
pipeline_if_typed #(.T(wb_sel_t)) wb_sel ();
pipeline_if_typed #(.T(mem_region_t)) mem_region ();
pipeline_if_typed #(.T(inst_type_t)) itype ();
pipeline_if_typed #(.T(cycle_pe_tag_t)) ct ();
pipeline_if_typed #(.T(cycle_pe_tag_t)) ct_gen ();
pipeline_if_s csr_minstret_wr ();

//------------------------------------------------------------------------------
// pipe stage controls
stage_ctrl_t ctrl_dec_exe, ctrl_exe_mem, ctrl_mem_wbk, ctrl_wbk_ret;

//------------------------------------------------------------------------------
// FET Stage
arch_width_t pc_fet_last, pc_inc4_in, pc_inc4, pc_branch_jal, pc_new_mem;
fe_ctrl_t fe_ctrl;
logic be_stalled_d;
decoder_t decoded; // from decode

`ifdef USE_BP
arch_width_t pc_fet_cp; // checkpoint fetch PC before going to speculative
arch_width_t pc_fet_cp_get;
assign pc_fet_cp_get = fe_ctrl.use_cp ? pc_fet_cp : pc_fet_last;
assign pc_inc4_in = pc_fet_cp_get;
branch_t bp_pred;
`else
assign pc_inc4_in = pc_fet_last;
`endif

/* verilator lint_off PINCONNECTEMPTY */
add #(.W(ARCH_WIDTH)) pc_fet_inc4_i (
    .a(pc_inc4_in), .b('d4), .ci(1'b0), .s(pc_inc4), .co()
);
/* verilator lint_on PINCONNECTEMPTY */

// PC_SEL_PC front mux
trap_ctrl_t trap_ctrl;
arch_width_t pc_sel_pc_src, mtvec_exe, mepc_exe;
assign pc_sel_pc_src =
    trap_ctrl.trap_redirect ? mtvec_exe :
    trap_ctrl.mret_redirect ? mepc_exe : pc_fet_last;

arch_width_t pc_fet_raw;
always_comb begin
    pc_fet_raw = pc_sel_pc_src;
    unique case (fe_ctrl.pc_sel)
        PC_SEL_PC: pc_fet_raw = pc_sel_pc_src;
        PC_SEL_INC4: pc_fet_raw = pc_inc4;
        PC_SEL_ALU: pc_fet_raw = pc_new_mem;
        PC_SEL_JAL_BP: pc_fet_raw = pc_branch_jal;
    endcase
    pc.fet = pc_align(pc_fet_raw);
end
assign imem_req.data = pc.fet[CORE_WORD_ADDR_BUS+2-1:2];

`DFF_CI_RI_RV_EN(RESET_VECTOR, fe_ctrl.pc_we, pc.fet, pc_fet_last)

`ifndef SYNT
assign pc_nz.fet = (pc.fet != 'h0);
`endif

logic stall_act_flow;
always_comb begin
    ct_gen.fet = '0;
    ct_gen.fet.stall_act_flow = stall_act_flow;
end

`DFF_CI_RI_RVI(ct_gen.fet, ct.dec)

//------------------------------------------------------------------------------
// DEC Stage
inst_width_t inst_dec_d;
arch_width_t pc_dec_d;
always_comb begin
    if (be_stalled_d && !imem_rsp.valid) begin
        // keep current inst, new requests are not issued to the same addr
        inst.dec = inst_dec_d;
        pc.dec = pc_dec_d;
    end else begin
        // even if be in stall, take inst if imem_rsp.valid
        // happens when i$ missed before be stalled
        pc.dec = imem_rsp.valid ? pc_fet_last : 'h0;
        inst.dec = imem_rsp.valid ? imem_rsp.data : 'h0;
    end
end

`DFF_CI_RI_RVI(inst.dec, inst_dec_d)
`DFF_CI_RI_RVI(pc.dec, pc_dec_d)

`ifndef SYNT
always_ff @(posedge clk) begin
    if (!rst && !ctrl_dec_exe.bubble) begin
        assert (!(imem_rsp.valid && imem_rsp.data == 'h0))
        else $fatal(1, "IMEM returned zero-word instruction");
    end
end
`endif

fe_ctrl_t decoded_fe_ctrl;
ama_riscv_decoder #(.SIMD_EN (SIMD_EN)) decoder_i (
    .inst_dec (inst.dec), .decoded (decoded), .fe_ctrl (decoded_fe_ctrl)
);

// short paths to avoid full decoder delay just for inst detection
logic branch_in_dec, jalr_in_dec;
assign branch_in_dec = (get_opc7(inst.dec) == OPC7_BRANCH);
assign jalr_in_dec = (get_opc7(inst.dec) == OPC7_JALR);

csr_trap_status_t csr_status;
csr_trap_wr_t csr_trap_wr;
ama_riscv_trap_ctrl trap_ctrl_i (
    .clk,
    .rst,
    // inputs
    .xcpt (decoded.xcpt),
    .mret_dec (decoded.mret),
    .wfi_dec (decoded.wfi),
    .dec_valid ((inst.dec != 'h0)),
    .dec_en (ctrl_dec_exe.en && !ctrl_dec_exe.bubble),
    .pc_dec (pc.dec),
    .pc_inc4,
    .inst_dec (inst.dec),
    .spec,
    .trap_tag_wbk (trap_tag.wbk),
    .csr_status,
    // outputs
    .csr_trap_wr,
    .trap_tag_dec (trap_tag.dec),
    .ctrl (trap_ctrl)
);

/* verilator lint_off UNUSEDSIGNAL */
decoder_t decoded_exe; // some bits are not always used
/* verilator lint_on UNUSEDSIGNAL */
logic dc_stalled, div_stalled;
logic csr_inst_exe, csr_drain_done, csr_stalled;
branch_t branch_resolution_mem;
hazard_t hazard;
logic spec_ic_miss_sink;

rv_ctrl_if imem_req_rv ();
rv_ctrl_if imem_rsp_rv ();
assign imem_req_rv.ready = imem_req.ready;
assign imem_req.valid = imem_req_rv.valid;
assign imem_rsp.ready = imem_rsp_rv.ready;
assign imem_rsp_rv.valid = imem_rsp.valid;

ama_riscv_fe_ctrl fe_ctrl_i (
    .clk,
    .rst,
    .imem_req (imem_req_rv),
    .imem_rsp (imem_rsp_rv),
    // inputs
    .pc_dec (pc.dec),
    .pc_mem (pc.mem),
    .branch_in_dec,
    .branch_in_mem (itype.mem.branch),
    .jalr_in_dec,
    .jalr_in_exe (decoded_exe.itype.jalr),
    .jalr_in_mem (itype.mem.jalr),
    `ifdef USE_BP
    .bp_pred,
    `endif
    .branch_resolution (branch_resolution_mem),
    .decoded_fe_ctrl,
    .trap_ctrl,
    .hazard,
    .dc_stalled,
    .div_stalled,
    .csr_stalled,
    // outputs
    `ifdef USE_BP
    .pc_cp (pc_fet_cp),
    `endif
    .stall_act_flow,
    .spec_ic_miss_sink,
    .spec, // tied to 0 when BP is not used
    .fe_ctrl
);

arch_width_t e_writeback_mem, e_writeback_p_mem; // from MEM stage
arch_width_t writeback, writeback_p; // from WBK stage

// reg file
rf_addr_t rs1_addr_dec, rs2_addr_dec, rs3_addr_dec;
arch_width_t rs1_data_dec, rs2_data_dec, rs3_data_dec;

assign rs1_addr_dec = get_rs1(inst.dec, decoded.has_reg.rs1);
assign rs2_addr_dec = get_rs2(inst.dec, decoded.has_reg.rs2);
assign rs3_addr_dec = get_rd(inst.dec, decoded.has_reg.rs3);
assign rd_addr.dec = get_rd(inst.dec, decoded.has_reg.rd);

ama_riscv_reg_file #(
    .BANKED (RF_BANKED),
    .SIMD_EN (SIMD_EN)
) reg_file_i (
    .clk (clk),
    // inputs
    .we (rf_we.wbk),
    .addr_a (rs1_addr_dec),
    .addr_b (rs2_addr_dec),
    .addr_c (rs3_addr_dec),
    .addr_d (rd_addr.wbk),
    .data_d (writeback),
    .data_dp (writeback_p),
    // outputs
    .data_a (rs1_data_dec),
    .data_b (rs2_data_dec),
    .data_c (rs3_data_dec)
);

// imm gen
arch_width_t imm_gen_out_dec, imm_jal;
`ifdef USE_BP
arch_width_t imm_b;
`endif
ama_riscv_imm_gen imm_gen_i(
    .sel (decoded.ig_sel),
    .in (inst.dec[31:7]),
    `ifdef USE_BP
    .out_b (imm_b),
    `endif
    .out_jal (imm_jal),
    .out (imm_gen_out_dec)
);

arch_width_t imm_branch_jal;
assign imm_branch_jal = branch_in_dec ? imm_b : imm_jal;

/* verilator lint_off PINCONNECTEMPTY */
add #(.W(ARCH_WIDTH)) pc_branch_jal_add_i (
    .a(pc.dec), .b(imm_branch_jal), .ci(1'b0), .s(pc_branch_jal), .co()
);
/* verilator lint_on PINCONNECTEMPTY */

`ifdef USE_BP
// all predictors use imm_b right away, no BTB

if (BP_TYPE == BP_STATIC) begin: gen_bp_sttc

if (BP_STATIC_TYPE == BP_STATIC_AT) begin : gen_bp_sttc_at
assign bp_pred = B_T;
end else if (BP_STATIC_TYPE == BP_STATIC_ANT) begin: gen_bp_sttc_ant
assign bp_pred = B_NT;
end else if (BP_STATIC_TYPE == BP_STATIC_BTFN) begin: gen_bp_sttc_btfn
assign bp_pred = branch_t'(branch_in_dec && (pc_branch_jal < pc.dec));
end

end else begin: gen_bp_dyn
branch_t bp_pred_1;
bp_pipe_t pipe_to_bp;
assign pipe_to_bp = '{
    pc_dec: pc.dec,
    pc_mem: pc.mem,
    spec: spec,
    br_res: branch_resolution_mem
};

ama_riscv_bp #(
    .PC_BITS (BP_1_PC_BITS),
    .CNT_BITS (BP_1_CNT_BITS),
    .BP_TYPE_SEL (BP_1_TYPE)
) bp_c1_i (
    .clk (clk),
    .rst (rst),
    .pipe_in (pipe_to_bp),
    .bp_comp_pred ('{B_NT, B_NT}), // dc
    .pred (bp_pred_1)
);

if (BP_TYPE != BP_COMBINED) begin: gen_bp_dyn_single
assign bp_pred = bp_pred_1;

end else begin: gen_bp_dyn_comb
branch_t bp_pred_2, bp_pred_meta;

ama_riscv_bp #(
    .GHR_BITS (BP_2_GHR_BITS),
    .CNT_BITS (BP_2_CNT_BITS),
    .BP_TYPE_SEL (BP_2_TYPE)
) bp_c2_i (
    .clk (clk),
    .rst (rst),
    .pipe_in (pipe_to_bp),
    .bp_comp_pred ('{B_NT, B_NT}), // dc
    .pred (bp_pred_2)
);

ama_riscv_bp #(
    .PC_BITS (BP_C_PC_BITS),
    .CNT_BITS (BP_C_CNT_BITS),
    .BP_TYPE_SEL (BP_COMBINED)
) bp_i (
    .clk (clk),
    .rst (rst),
    .pipe_in (pipe_to_bp),
    .bp_comp_pred ('{bp_pred_1, bp_pred_2}),
    .pred (bp_pred_meta)
);
assign bp_pred = bp_pred_meta;

end // gen_bp_dyn_single/gen_bp_dyn_comb
end // gen_bp_sttc/gen_bp_dyn
`endif // USE_BP

// decoded reg src addresses
rf_addr_t rs1_addr_exe, rs2_addr_exe, rs3_addr_exe, rs3_addr_mem;
// forwarding sources
fwd_be_t fwd_src_sel_rs1_dec, fwd_src_sel_rs2_dec, fwd_src_sel_rs3_dec;
fwd_be_t fwd_src_sel_rs1_exe, fwd_src_sel_rs2_exe, fwd_src_sel_rs3_exe;
fwd_be_t fwd_src_sel_rs3_mem;
// forwarding selects
a_sel_t a_sel_dec_fwd;
b_sel_t b_sel_dec_fwd;
logic c_sel_dec_fwd;
logic a_sel_fwd_exe, b_sel_fwd_exe, c_sel_fwd_exe, c_sel_fwd_mem;

ama_riscv_operand_forwarding #(
    .SIMD_EN (SIMD_EN)
) operand_forwarding_i (
    // inputs
    .load_inst_mem (itype.mem.load),
    .load_inst_wbk (itype.wbk.load),
    .dc_stalled (dc_stalled),
    .mul_simd_arith_exe (itype.exe.mul || itype.exe.simd_arith),
    .mul_simd_arith_mem (itype.mem.mul || itype.mem.simd_arith),
    .rs1_dec (rs1_addr_dec),
    .rs2_dec (rs2_addr_dec),
    .rs3_dec (rs3_addr_dec),
    .rs1_exe (rs1_addr_exe),
    .rs2_exe (rs2_addr_exe),
    .rs3_exe (rs3_addr_exe),
    .rs3_mem (rs3_addr_mem),
    .rd_mem (rd_addr.mem),
    .rd_wbk (rd_addr.wbk),
    .rf_we_mem (rf_we.mem),
    .rf_we_wbk (rf_we.wbk),
    .a_sel_dec (decoded.a_sel),
    .b_sel_dec (decoded.b_sel),
    // outputs (to decode)
    .fwd_src_sel_rs1_dec (fwd_src_sel_rs1_dec),
    .fwd_src_sel_rs2_dec (fwd_src_sel_rs2_dec),
    .fwd_src_sel_rs3_dec (fwd_src_sel_rs3_dec),
    .a_sel_dec_fwd (a_sel_dec_fwd),
    .b_sel_dec_fwd (b_sel_dec_fwd),
    .c_sel_dec_fwd (c_sel_dec_fwd),
    // outputs (to execute)
    .fwd_src_sel_rs1_exe (fwd_src_sel_rs1_exe),
    .fwd_src_sel_rs2_exe (fwd_src_sel_rs2_exe),
    .fwd_src_sel_rs3_exe (fwd_src_sel_rs3_exe),
    .a_sel_fwd_exe (a_sel_fwd_exe),
    .b_sel_fwd_exe (b_sel_fwd_exe),
    .c_sel_fwd_exe (c_sel_fwd_exe),
    // outputs to mem
    .fwd_src_sel_rs3_mem (fwd_src_sel_rs3_mem),
    .c_sel_fwd_mem (c_sel_fwd_mem),
    // hazard detection
    .hazard (hazard)
);

// prepare forwading values from backend
arch_width_t rs1_dec_be_fwd, rs2_dec_be_fwd, rs3_dec_be_fwd;
always_comb begin
    unique case (fwd_src_sel_rs1_dec)
        FWD_BE_WBK: rs1_dec_be_fwd = writeback;
        FWD_BE_WBK_P: rs1_dec_be_fwd = writeback_p;
        default: rs1_dec_be_fwd = 'h0;
    endcase
end

always_comb begin
    unique case (fwd_src_sel_rs2_dec)
        FWD_BE_WBK: rs2_dec_be_fwd = writeback;
        FWD_BE_WBK_P: rs2_dec_be_fwd = writeback_p;
        default: rs2_dec_be_fwd = 'h0;
    endcase
end

always_comb begin
    unique case (fwd_src_sel_rs3_dec)
        FWD_BE_WBK: rs3_dec_be_fwd = writeback;
        FWD_BE_WBK_P: rs3_dec_be_fwd = writeback_p;
        default: rs3_dec_be_fwd = 'h0;
    endcase
end

// get RF (rs1/rs2) or alternate (pc/imm), or forward from backend if rs1/rs2
arch_width_t op_a_dec, op_b_dec, op_c_dec;
always_comb begin
    unique case (a_sel_dec_fwd)
        A_SEL_RS1: op_a_dec = rs1_data_dec;
        A_SEL_PC: op_a_dec = pc.dec;
        A_SEL_FWD: op_a_dec = rs1_dec_be_fwd;
        default: op_a_dec = 'h0;
    endcase
end

always_comb begin
    unique case (b_sel_dec_fwd)
        B_SEL_RS2: op_b_dec = rs2_data_dec;
        B_SEL_IMM: op_b_dec = imm_gen_out_dec;
        B_SEL_FWD: op_b_dec = rs2_dec_be_fwd;
        default: op_b_dec = 'h0;
    endcase
end

assign op_c_dec = c_sel_dec_fwd ? rs3_dec_be_fwd : rs3_data_dec;

//------------------------------------------------------------------------------
// Pipeline FF DEC/EXE

arch_width_t op_a_exe, op_b_exe, op_c_exe, pc_branch_exe;
branch_sel_t branch_sel_dec, branch_sel_exe;
assign branch_sel_dec = get_branch_sel(inst.dec);

logic [DMEM_ADDR_OFFSET_WIDTH-1:0] dmem_offset_dec, dmem_offset_exe;
assign dmem_offset_dec = imm_gen_out_dec[DMEM_ADDR_OFFSET_WIDTH-1:0];
logic decoded_itype_dmem;
assign decoded_itype_dmem = (decoded.itype.load || decoded.itype.store);
dmem_dtype_t dmem_dtype_dec, dmem_dtype_exe;
assign dmem_dtype_dec = dmem_dtype_t'(get_fn3(inst.dec));

logic [4:0] csr_imm5_dec, csr_imm5_exe;
assign csr_imm5_dec = inst.dec[19:15];
csr_addr_t csr_addr_dec, csr_addr_exe;
assign csr_addr_dec = csr_addr_t'(inst.dec[31:20]);

`ifndef SYNT
assign pc_nz.dec = (pc.dec != 'h0);
`endif
`STAGE_D_E(1'b1, inst.dec, inst.exe, 'h0)
`STAGE_D_E(1'b1, pc.dec, pc.exe, 'h0)
`STAGE_D_E(1'b1, trap_tag.dec, trap_tag.exe, 'h0)
`STAGE_D_E(1'b1, rd_addr.dec, rd_addr.exe, RF_X0_ZERO)
`STAGE_D_E(1'b1, rs1_addr_dec, rs1_addr_exe, RF_X0_ZERO)
`STAGE_D_E(1'b1, rs2_addr_dec, rs2_addr_exe, RF_X0_ZERO)
`STAGE_D_E(1'b1, rs3_addr_dec, rs3_addr_exe, RF_X0_ZERO)
`STAGE_D_E(branch_in_dec, pc_branch_jal, pc_branch_exe, 'h0)
`STAGE_D_E(branch_in_dec, branch_sel_dec, branch_sel_exe, BRANCH_SEL_BEQ)
`STAGE_D_E(decoded_itype_dmem, dmem_offset_dec, dmem_offset_exe, 'h0)
`STAGE_D_E(decoded_itype_dmem, dmem_dtype_dec, dmem_dtype_exe, DMEM_DTYPE_BYTE)
`STAGE_D_E(decoded.csr_ctrl.en, csr_imm5_dec, csr_imm5_exe, 'h0)
`STAGE_D_E(decoded.csr_ctrl.en, csr_addr_dec, csr_addr_exe, csr_addr_t'('h0))
`STAGE_D_E_CLR(1'b1, trap_tag.dec.trapped, decoded, decoded_exe, `DECODER_INIT_VAL)

// special case for two operands, to save (writeback fwd) values on stall
arch_width_t op_a_r, op_b_r, op_c_r_exe; // resolved operands from exe stage
always_ff @(posedge clk) begin
    if (rst) begin
        {op_a_exe, op_b_exe, op_c_exe} <= {3{ARCH_WIDTH'(0)}};
    end else if (ctrl_dec_exe.flush) begin
        {op_a_exe, op_b_exe, op_c_exe} <= {3{ARCH_WIDTH'(0)}};
    end else if (ctrl_exe_mem.bubble) begin // saved operands
        {op_a_exe, op_b_exe, op_c_exe} <= {op_a_r, op_b_r, op_c_r_exe};
    end else if (ctrl_dec_exe.en) begin
        if (ctrl_dec_exe.bubble) begin
            {op_a_exe, op_b_exe, op_c_exe} <= {3{ARCH_WIDTH'(0)}};;
        end else begin
            {op_a_exe, op_b_exe, op_c_exe} <= {op_a_dec, op_b_dec, op_c_dec};
        end
    end
end

always_comb begin
    ct_gen.dec = ct.dec;
    ct_gen.dec.stall_l1i = !imem_req.ready;
    ct_gen.dec.spec_ic_miss_sink = spec_ic_miss_sink;
    ct_gen.dec.bad_spec = spec.wrong;
end

`DFF_CI_RI_RVI(ct_gen.dec, ct.exe)

//------------------------------------------------------------------------------
// EXE stage

// select forwarding source (if any) and resolve operands
arch_width_t rs1_exe_be_fwd, rs2_exe_be_fwd, rs3_exe_be_fwd;
always_comb begin
    rs1_exe_be_fwd = 'h0;
    unique case (fwd_src_sel_rs1_exe)
        FWD_BE_MEM: rs1_exe_be_fwd = e_writeback_mem;
        FWD_BE_WBK: rs1_exe_be_fwd = writeback;
        FWD_BE_MEM_P: rs1_exe_be_fwd = e_writeback_p_mem;
        FWD_BE_WBK_P: rs1_exe_be_fwd = writeback_p;
    endcase
end

always_comb begin
    rs2_exe_be_fwd = 'h0;
    unique case (fwd_src_sel_rs2_exe)
        FWD_BE_MEM: rs2_exe_be_fwd = e_writeback_mem;
        FWD_BE_WBK: rs2_exe_be_fwd = writeback;
        FWD_BE_MEM_P: rs2_exe_be_fwd = e_writeback_p_mem;
        FWD_BE_WBK_P: rs2_exe_be_fwd = writeback_p;
    endcase
end

always_comb begin
    rs3_exe_be_fwd = 'h0;
    unique case (fwd_src_sel_rs3_exe)
        FWD_BE_MEM: rs3_exe_be_fwd = e_writeback_mem;
        FWD_BE_WBK: rs3_exe_be_fwd = writeback;
        FWD_BE_MEM_P: rs3_exe_be_fwd = e_writeback_p_mem;
        FWD_BE_WBK_P: rs3_exe_be_fwd = writeback_p;
    endcase
end

assign op_a_r = a_sel_fwd_exe ? rs1_exe_be_fwd : op_a_exe;
assign op_b_r = b_sel_fwd_exe ? rs2_exe_be_fwd : op_b_exe;
assign op_c_r_exe = c_sel_fwd_exe ? rs3_exe_be_fwd : op_c_exe;

logic div_start, div_busy, div_issued;
assign div_start = (
    decoded_exe.itype.div &&
    !div_issued &&
    !div_busy &&
    !hazard.to_exe &&
    !(flush.dec || flush.exe)
);
assign div_stalled = ((div_start || div_busy) && !spec.wrong);

always_ff @(posedge clk) begin
    if (rst) div_issued <= 1'b0;
    else if (flush.exe) div_issued <= 1'b0;
    else if (ctrl_exe_mem.en && !ctrl_exe_mem.bubble) div_issued <= 1'b0;
    else if (div_start) div_issued <= 1'b1;
end

// ALU
arch_width_t alu_out_exe, pc_new_exe;
branch_t branch_resolution_exe;
ama_riscv_alu alu_i (
    .op (decoded_exe.alu_op),
    .a (op_a_r),
    .b (op_b_r),
    .s (alu_out_exe),
    .is_branch(decoded_exe.itype.branch),
    .branch_u(decoded_exe.branch_u),
    .branch_sel(branch_sel_exe),
    .branch_res(branch_resolution_exe)
);
assign pc_new_exe = decoded_exe.itype.branch ? pc_branch_exe : alu_out_exe;

simd_t data_fmt_out_exe, data_fmt_out_p_exe;

if (SIMD_EN) begin: gen_data_fmt
simd_d_t data_fmt_out, data_fmt_out_widen;
ama_riscv_simd_data_fmt simd_data_fmt_i (
    .op (decoded_exe.simd_data_fmt_op),
    .a (op_a_r),
    .b (op_b_r),
    .c (op_c_r_exe),
    .s (data_fmt_out),
    .s_widen (data_fmt_out_widen)
);

simd_t shift_a, shift_b;
assign shift_a = decoded_exe.simd_shift_op[3] ? data_fmt_out_widen.w[0] :op_a_r;
assign shift_b = data_fmt_out_widen.w[1];

simd_d_t shift_s;
ama_riscv_simd_shift simd_shift_i (
    .op(decoded_exe.simd_shift_op),
    .a(shift_a),
    .b(shift_b),
    .shamt(op_b_r[4:0]),
    .s(shift_s)
);

assign {data_fmt_out_p_exe, data_fmt_out_exe} =
    decoded_exe.itype.simd_shift ? shift_s : data_fmt_out;

end else begin: gen_no_data_fmt
    assign data_fmt_out_exe = '0;
    assign data_fmt_out_p_exe = '0;
end

/* verilator lint_off UNUSEDSIGNAL */
arch_width_t op_c_r_mem; // no late_c without SIMD
/* verilator lint_on UNUSEDSIGNAL */
simd_d_t simd_out_wbk;

if (SIMD_EN || MULT_USE_BW) begin: gen_mult_simd
ama_riscv_simd #(
    .RV32M_ONLY(!SIMD_EN)
) simd_i (
    .clk,
    .rst,
    .en (itype.exe.mul || itype.exe.simd_arith),
    .ctrl_exe_mem,
    .ctrl_mem_wbk,
    .op (decoded_exe.simd_arith_op),
    .a (op_a_r),
    .b (op_b_r),
    .c_late (op_c_r_mem),
    .p (simd_out_wbk)
);

end else begin: gen_mult_plain
arch_width_t mult_p;
ama_riscv_mult mult_i (
    .clk,
    .rst,
    .en (itype.exe.mul),
    .ctrl_exe_mem,
    .ctrl_mem_wbk,
    .op (decoded_exe.simd_arith_op[1:0]),
    .a (op_a_r),
    .b (op_b_r),
    .p (mult_p)
);
assign simd_out_wbk.w[0] = mult_p;
assign simd_out_wbk.w[1] = 'h0;

end

arch_width_t div_result;
ama_riscv_div div_i (
    .clk (clk),
    .rst (rst),
    .start (div_start),
    .flush (flush.exe || spec.wrong),
    .op (decoded_exe.div_op),
    .a (op_a_r),
    .b (op_b_r),
    .result (div_result),
    .busy (div_busy)
);

// CSR
csr_ctrl_t csr_ctrl_exe;
always_comb begin
    csr_ctrl_exe = decoded_exe.csr_ctrl;
    csr_ctrl_exe.en = (
        decoded_exe.csr_ctrl.en &&
        !spec.wrong &&
        (ctrl_exe_mem.en && !ctrl_exe_mem.bubble)
    );
end

perf_event_t perf_events;
arch_width_t csr_out_exe;
logic csr_minstret_wr_skip;
logic inst_retired_d;
logic csr_minstret_inc;
assign csr_minstret_inc = (inst_retired_d && !csr_minstret_wr_skip);
ama_riscv_csr csr_i (
    .clk,
    .rst,
    .ctrl (csr_ctrl_exe),
    .in (op_a_r),
    .imm5 (csr_imm5_exe),
    .addr (csr_addr_exe),
    .perf_events,
    .minstret_inc (csr_minstret_inc),
    .mtime (clint_ch.mtime),
    .out (csr_out_exe),
    // trap interface
    .trap_wr (csr_trap_wr),
    .trap_status (csr_status),
    .mtvec (mtvec_exe),
    .mepc (mepc_exe),
    .mtip (mtip),
    .meip (meip)
);

// CSR access serialization
assign csr_inst_exe = (decoded_exe.csr_ctrl.en && !spec.wrong);
assign csr_drain_done = (
    !pc_nz.mem && !pc_nz.wbk && !pc_nz.ret && !inst_retired_d
);
assign csr_stalled = (csr_inst_exe && !csr_drain_done);

// minstret increment skip on write to minstret csr
assign csr_minstret_wr.exe = (
    csr_ctrl_exe.en && csr_ctrl_exe.we &&
    ((csr_addr_exe == CSR_MINSTRET) || (csr_addr_exe == CSR_MINSTRETH))
);

arch_width_t pc_exe_inc4;
/* verilator lint_off PINCONNECTEMPTY */
add #(.W(ARCH_WIDTH)) pc_exe_inc4_i (
    .a(pc.exe), .b('d4), .ci(1'b0), .s(pc_exe_inc4), .co()
);
/* verilator lint_on PINCONNECTEMPTY */

// execute stage instruction result mux
arch_width_t e_writeback_exe;
always_comb begin
    unique case (decoded_exe.ewb_sel)
        EWB_SEL_ALU: e_writeback_exe = alu_out_exe;
        EWB_SEL_IMM_U: e_writeback_exe = op_b_r;
        EWB_SEL_PC_INC4: e_writeback_exe = pc_exe_inc4;
        EWB_SEL_CSR: e_writeback_exe = csr_out_exe;
        EWB_SEL_DATA_FMT: e_writeback_exe = data_fmt_out_exe;
        EWB_SEL_DIV: e_writeback_exe = div_result;
        default: e_writeback_exe = 'h0;
    endcase
end

// AGU
arch_width_t mem_addr;
arch_width_t mem_addr_imm;
assign mem_addr_imm = {{20{dmem_offset_exe[11]}}, dmem_offset_exe};
/* verilator lint_off PINCONNECTEMPTY */
add #(.W(ARCH_WIDTH)) dmem_agu_exe_i (
    .a(op_a_r), .b(mem_addr_imm), .ci(1'b0), .s(mem_addr), .co()
);
/* verilator lint_on PINCONNECTEMPTY */

// memory map
assign mem_region.exe = '{
    dmem: (mem_addr[ARCH_WIDTH-1-:DMEM_RANGE_MATCH] == MM_DMEM_RANGE),
    uart: (mem_addr[ARCH_WIDTH-1:12] == MM_UART_RANGE),
    clint: (mem_addr[ARCH_WIDTH-1:12] == MM_CLINT_RANGE)
};

// DMEM
dmem_req_side_t dmem_req_exe;
assign dmem_req_exe.wdata = op_b_r;
assign dmem_req_exe.addr = mem_addr[CORE_BYTE_ADDR_BUS-1:0];
assign dmem_req_exe.dtype = dmem_dtype_exe;
assign dmem_req_exe.rtype = decoded_exe.itype.store ? DMEM_WRITE : DMEM_READ;
assign dmem_req_exe.en =
    (mem_region.exe.dmem && decoded_exe.dmem_en && (!hazard.to_exe));

// UART
uart_ch_side_t uart_ch_exe;
assign uart_ch_exe.ctrl.en =
    (mem_region.exe.uart && decoded_exe.dmem_en && (!hazard.to_exe));
assign uart_ch_exe.ctrl.we = (uart_ch_exe.ctrl.en && decoded_exe.itype.store);
assign uart_ch_exe.ctrl.addr = uart_addr_t'(mem_addr[4:2]);
assign uart_ch_exe.ctrl.load_signed = (dmem_dtype_exe == DMEM_DTYPE_BYTE);
assign uart_ch_exe.send = op_b_r[7:0]; // uart is 1 byte wide

// CLINT
clint_ch_side_t clint_ch_exe;
assign clint_ch_exe.ctrl.en =
    (mem_region.exe.clint && decoded_exe.dmem_en && (!hazard.to_exe));
assign clint_ch_exe.ctrl.we = (clint_ch_exe.ctrl.en && decoded_exe.itype.store);
assign clint_ch_exe.ctrl.addr = mem_addr[4:2];
assign clint_ch_exe.wdata = op_b_r;

//------------------------------------------------------------------------------
// Pipeline FF EXE/MEM
logic data_fmt_en_exe, data_fmt_en_mem;
assign data_fmt_en_exe = decoded_exe.itype.simd_data_fmt;
assign itype.exe = decoded_exe.itype;
assign pc_nz.exe = (pc.exe != 'h0);
assign wb_sel.exe = decoded_exe.wb_sel;
assign rf_we.exe = '{
    rd: decoded_exe.rd_we,
    rdp: (decoded_exe.rd_we && decoded_exe.has_reg.rdp)
};

dmem_req_side_t dmem_req_mem;
uart_ch_side_t uart_ch_mem;
clint_ch_side_t clint_ch_mem;
arch_width_t rs3_mem;

`STAGE_E_M(1'b1, inst.exe, inst.mem, 'h0)
`STAGE_E_M(1'b1, pc.exe, pc.mem, 'h0)
`STAGE_E_M(1'b1, pc_nz.exe, pc_nz.mem, 'h0)
`STAGE_E_M(1'b1, trap_tag.exe, trap_tag.mem, 'h0)
`STAGE_E_M(rf_we.exe.rd, e_writeback_exe, e_writeback_mem, 'h0)
`STAGE_E_M(data_fmt_en_exe, data_fmt_out_p_exe, e_writeback_p_mem, 'h0)
`STAGE_E_M(data_fmt_en_exe, data_fmt_en_exe, data_fmt_en_mem, 'h0)
`STAGE_E_M(rf_we.exe.rd, wb_sel.exe, wb_sel.mem, WB_SEL_EWB)
`STAGE_E_M(1'b1, rd_addr.exe, rd_addr.mem, RF_X0_ZERO)
`STAGE_E_M(1'b1, rs3_addr_exe, rs3_addr_mem, RF_X0_ZERO)
`STAGE_E_M(1'b1, rf_we.exe, rf_we.mem, 'h0)
`STAGE_E_M(1'b1, pc_new_exe, pc_new_mem, 'h0)
`STAGE_E_M(1'b1, op_c_r_exe, rs3_mem, 'h0)
`STAGE_E_M(1'b1, branch_resolution_exe, branch_resolution_mem, B_NT)
`STAGE_E_M(1'b1, itype.exe, itype.mem, '0)
`STAGE_E_M(1'b1, dmem_req_exe, dmem_req_mem, 'h0)
`STAGE_E_M(1'b1, uart_ch_exe, uart_ch_mem, 'h0)
`STAGE_E_M(1'b1, mem_region.exe, mem_region.mem, 'h0)
`STAGE_E_M(1'b1, clint_ch_exe, clint_ch_mem, 'h0)
`STAGE_E_M(1'b1, csr_minstret_wr.exe, csr_minstret_wr.mem, 1'b0)

`DFF_CI_RI_RVI(
    (dc_stalled || hazard.to_exe || div_stalled || csr_stalled),
    be_stalled_d
)

always_comb begin
    ct_gen.exe = ct.exe;
    ct_gen.exe.bad_spec |= spec.wrong; // DEC can also generate bad_spec
    ct_gen.exe.stall_load_use = (
        (hazard.from_mem && itype.mem.load && !dc_stalled)
    );
    ct_gen.exe.stall_mul_simd_use = (
        hazard.from_mem && (itype.mem.mul || itype.mem.simd_arith)
    );
    ct_gen.exe.stall_div = div_stalled;
    ct_gen.exe.stall_csr = (
        csr_stalled &&
        !ct_gen.exe.stall_load_use &&
        !ct_gen.exe.stall_mul_simd_use
    );
end

`DFF_CI_RI_RVI(ct_gen.exe, ct.mem)

//------------------------------------------------------------------------------
// MEM stage

arch_width_t rs3_mem_be_fwd;
always_comb begin
    unique case (fwd_src_sel_rs3_mem)
        FWD_BE_WBK: rs3_mem_be_fwd = writeback;
        FWD_BE_WBK_P: rs3_mem_be_fwd = writeback_p;
        default: rs3_mem_be_fwd = 'h0;
    endcase
end

assign op_c_r_mem = c_sel_fwd_mem ? rs3_mem_be_fwd : rs3_mem;

// DMEM
assign dmem_req.wdata = dmem_req_mem.wdata;
assign dmem_req.addr = dmem_req_mem.addr;
assign dmem_req.dtype = dmem_req_mem.dtype;
assign dmem_req.rtype = dmem_req_mem.rtype;
assign dmem_req.valid = (dmem_req_mem.en && (!dc_stalled));
assign dc_stalled = !dmem_req.ready;

// UART
assign uart_ch.ctrl.en = uart_ch_mem.ctrl.en;
assign uart_ch.ctrl.we = uart_ch_mem.ctrl.we;
assign uart_ch.ctrl.addr = uart_ch_mem.ctrl.addr;
assign uart_ch.ctrl.load_signed = uart_ch_mem.ctrl.load_signed;
assign uart_ch.send = uart_ch_mem.send;
// uart_ch.recv arrives in the next cycle

// CLINT
assign clint_ch.ctrl.en = clint_ch_mem.ctrl.en;
assign clint_ch.ctrl.we = clint_ch_mem.ctrl.we;
assign clint_ch.ctrl.addr = clint_ch_mem.ctrl.addr;
assign clint_ch.wdata = clint_ch_mem.wdata;
// clint_ch.rdata arrives in the next cycle

//------------------------------------------------------------------------------
// Pipeline FF MEM/WBK

arch_width_t e_writeback_wbk, e_writeback_p_wbk;

`ifndef SYNT
`STAGE_M_W(1'b1, pc.mem, pc.wbk, 'h0)
`endif
`STAGE_M_W(1'b1, inst.mem, inst.wbk, 'h0)
`STAGE_M_W(1'b1, pc_nz.mem, pc_nz.wbk, 1'b0)
`STAGE_M_W(1'b1, trap_tag.mem, trap_tag.wbk, 'h0)
`STAGE_M_W(rf_we.mem.rd, e_writeback_mem, e_writeback_wbk, 'h0)
`STAGE_M_W(data_fmt_en_mem, e_writeback_p_mem, e_writeback_p_wbk, 'h0)
`STAGE_M_W(rf_we.mem.rd, wb_sel.mem, wb_sel.wbk, WB_SEL_EWB)
`STAGE_M_W(1'b1, rd_addr.mem, rd_addr.wbk, RF_X0_ZERO)
`STAGE_M_W(1'b1, rf_we.mem, rf_we.wbk, 'h0)
`STAGE_M_W(1'b1, itype.mem, itype.wbk, 'h0)
`STAGE_M_W(1'b1, mem_region.mem, mem_region.wbk, 'h0)
`STAGE_M_W(1'b1, csr_minstret_wr.mem, csr_minstret_wr.wbk, 1'b0)

logic stall_load_use_pend, stall_load_use_release;
assign stall_load_use_release = (stall_load_use_pend && !dc_stalled);
always_ff @(posedge clk) begin
    if (rst) stall_load_use_pend <= 1'b0;
    else if (ct.mem.stall_load_use && dc_stalled) stall_load_use_pend <= 1'b1;
    else if (stall_load_use_release) stall_load_use_pend <= 1'b0;
end

always_comb begin
    ct_gen.mem = ct.mem;
    ct_gen.mem.stall_load_use &= !dc_stalled; // squashed if dcache stalls
    ct_gen.mem.stall_load_use |= stall_load_use_release; // released on d$ resp.
end

`DFF_CI_RI_RVI(ct_gen.mem, ct.wbk)

//------------------------------------------------------------------------------
// WBK stage

arch_width_t dmem_rsp_data_v, dmem_out_wbk;
assign dmem_rsp_data_v = (itype.wbk.load && dmem_rsp.valid) ? dmem_rsp.data :'h0;
always_comb begin
    unique case (1'b1)
        mem_region.wbk.dmem: dmem_out_wbk = dmem_rsp_data_v;
        mem_region.wbk.uart: dmem_out_wbk = uart_ch.recv;
        mem_region.wbk.clint: dmem_out_wbk = clint_ch.rdata;
        default: dmem_out_wbk = 'h0;
    endcase
end

always_comb begin
    unique case (wb_sel.wbk)
        WB_SEL_EWB: writeback = e_writeback_wbk;
        WB_SEL_DMEM: writeback = dmem_out_wbk;
        WB_SEL_SIMD: writeback = simd_out_wbk.w[0];
        default: writeback = 'h0;
    endcase
end

always_comb begin
    if (wb_sel.wbk == WB_SEL_SIMD) writeback_p = simd_out_wbk.w[1];
    else writeback_p = e_writeback_p_wbk;
end

//------------------------------------------------------------------------------
// retire

// a trapped inst is not retired: kill pc/inst/pc_nz into RET on trapped.wbk
`ifndef SYNT
`STAGE_W_R_CLR(1'b1, pc.wbk, pc.ret, 'h0)
`STAGE_W_R(1'b1, trap_tag.wbk, trap_tag.ret, 'h0)
`endif
`STAGE_W_R_CLR(1'b1, inst.wbk, inst.ret, 'h0)
`STAGE_W_R_CLR(1'b1, pc_nz.wbk, pc_nz.ret, 1'b0)
`STAGE_W_R_CLR(1'b1, itype.wbk, itype.ret, 'h0)
`STAGE_W_R_CLR(1'b1, csr_minstret_wr.wbk, csr_minstret_wr.ret, 1'b0)
`STAGE_W_R_CLR(1'b1, mem_region.wbk.dmem, mem_region.ret.dmem, 1'b0)

always_comb begin
    ct_gen.wbk = ct.wbk;
    ct_gen.wbk.stall_l1d = dc_stalled;
    ct_gen.wbk.stall_l1d_r = (dc_stalled && pe_dc.rd_pend);
end

`DFF_CI_RI_RVI(ct_gen.wbk, ct.ret)

//------------------------------------------------------------------------------
// perf
perf_event_t cpe; // collect perf events
logic fe_unblocked, be_unblocked;
always_comb begin
    cpe = '0;
    fe_unblocked = '0;
    be_unblocked = '0;
    inst_retired = pc_nz.ret; // core output
    // stalls
    if (!inst_retired) begin
        cpe.bad_spec = ct.ret.bad_spec;
        // be
        be_unblocked = (!cpe.bad_spec);
        if (be_unblocked) begin
            cpe.stall_be = (
                // dcache
                ct.ret.stall_l1d ||
                // or core
                ct.ret.stall_load_use ||
                ct.ret.stall_mul_simd_use ||
                ct.ret.stall_div ||
                ct.ret.stall_csr
            );
            cpe.stall_l1d = ct.ret.stall_l1d;
            cpe.stall_l1d_r = ct.ret.stall_l1d_r;
            cpe.stall_load_use = ct.ret.stall_load_use;
            cpe.stall_mul_simd_use = ct.ret.stall_mul_simd_use;
            cpe.stall_div = ct.ret.stall_div;
        end
        // fe
        fe_unblocked = (!cpe.bad_spec && !cpe.stall_be);
        if (fe_unblocked) begin
            cpe.stall_fe = (
                ct.ret.stall_l1i ||
                ct.ret.stall_act_flow ||
                ct.ret.spec_ic_miss_sink
            );
            cpe.stall_l1i = ct.ret.stall_l1i;
        end
    end
    // core
    cpe.ret_ctrl_flow_jr = (get_opc7(inst.ret) == OPC7_JALR);
    cpe.ret_ctrl_flow_br = (get_opc7(inst.ret) == OPC7_BRANCH);
    cpe.ret_ctrl_flow = (
       (get_opc7(inst.ret) == OPC7_JAL) ||
       cpe.ret_ctrl_flow_jr ||
       cpe.ret_ctrl_flow_br
    );
    if (mem_region.ret.dmem) begin
        cpe.ret_mem_load = (get_opc7(inst.ret) == OPC7_LOAD);
        cpe.ret_mem = (cpe.ret_mem_load || (get_opc7(inst.ret) == OPC7_STORE));
    end
    cpe.ret_mul = itype.ret.mul;
    cpe.ret_div = itype.ret.div;
    cpe.ret_simd = itype.ret.simd;
    cpe.ret_simd_arith_dot = (
        itype.ret.simd && (get_fn7(inst.ret) == CUSTOM_ISA_FN7_SIMD_DOT)
    );
    cpe.ret_simd_arith = (itype.ret.simd && (!get_fn7_b5(inst.ret)));
    // bp
    cpe.bp_miss = spec.wrong;
    // icache
    cpe.l1i_ref = (pe_ic.hit || pe_ic.miss);
    cpe.l1i_miss = pe_ic.miss;
    cpe.l1i_spec_miss = pe_ic.spec_miss;
    cpe.l1i_spec_miss_bad = pe_ic.spec_miss_bad;
    // dcache
    cpe.l1d_ref = (pe_dc.hit || pe_dc.miss);
    cpe.l1d_ref_r = (cpe.l1d_ref && pe_dc.rd);
    cpe.l1d_miss = pe_dc.miss;
    cpe.l1d_miss_r = (cpe.l1d_miss && pe_dc.rd);
    cpe.l1d_writeback = pe_dc.writeback;
end

`DFF_CI_RI_RVI(cpe, perf_events)
`DFF_CI_RI_RVI(inst_retired, inst_retired_d) // align w/ perf_events
`DFF_CI_RI_RVI(csr_minstret_wr.ret, csr_minstret_wr_skip) //align w/ perf_events

//------------------------------------------------------------------------------
// Reset sequence
logic [PIPE_STAGES-1:0] reset_seq;
`DFF_CI_RI_RV(RST_INIT, {reset_seq[PIPE_STAGES-2:0], 1'b0}, reset_seq)

//------------------------------------------------------------------------------
// pipeline control

assign flush.fet = 1'b0;
assign flush.dec = reset_seq[0];
assign flush.exe = reset_seq[1];
assign flush.mem = reset_seq[2];
assign flush.wbk = reset_seq[3];

assign ctrl_dec_exe = '{
    flush: (flush.dec || fe_ctrl.bubble_exe),
    en: ((!dc_stalled) && (!hazard.to_exe) && (!div_stalled) && (!csr_stalled)),
    bubble: (fe_ctrl.bubble_dec /*|| hazard.to_dec*/)
};

assign ctrl_exe_mem = '{
    flush: flush.exe,
    en: (!dc_stalled),
    bubble: (
        !ctrl_dec_exe.en || hazard.to_exe || fe_ctrl.bubble_exe ||
        div_stalled || csr_stalled
    )
};

assign ctrl_mem_wbk = '{
    flush: flush.exe,
    en: (!dc_stalled),
    bubble: (
        !pc_nz.mem &&
        !(!pc_nz.mem && trap_tag.mem.trapped) // tag passes on pc=0
    )
};

assign ctrl_wbk_ret = '{
    flush: flush.wbk,
    en: 1'b1,
    bubble: (!ctrl_mem_wbk.en)
};

//------------------------------------------------------------------------------
// asserts

`ifndef SYNT

logic valid_dmem_access_exe;
assign valid_dmem_access_exe = (
    (decoded_exe.itype.load || decoded_exe.itype.store) &&
    decoded_exe.dmem_en &&
    !hazard.to_exe
);
/*
always @(posedge clk) begin
    if (valid_dmem_access_exe) begin
        assert($countones(mem_region.exe) == 1)
        else $warning( // may be speculative, so just warn
            "DMEM INST REGION FAULT EXE - dmem=%0b uart=%0b clint=%0b",
            mem_region.exe.dmem, mem_region.exe.uart, mem_region.exe.clint
        );
    end
end
*/
logic valid_dmem_access_mem;
`STAGE_E_M(1'b1, valid_dmem_access_exe, valid_dmem_access_mem, 'h0)
always @(posedge clk) if (valid_dmem_access_mem) begin
    assert($countones(mem_region.mem) == 1)
    else $fatal(1, // spec can't reach this far, so error out
        "DMEM INST REGION FAULT MEM - dmem=%0b uart=%0b clint=%0b",
        mem_region.exe.dmem, mem_region.exe.uart, mem_region.exe.clint
    );
end

// committed Zicsr read must see a fully drained backend (counters settled)
// so minstret/instret reads are precise
always @(posedge clk) begin
    if (csr_ctrl_exe.en && csr_ctrl_exe.re) begin
        assert(csr_drain_done)
        else $error(
            "CSR READ COMMIT WITHOUT DRAIN: mem=%0b wbk=%0b ret=%0b perf_ret=%0b",
            pc_nz.mem, pc_nz.wbk, pc_nz.ret, inst_retired_d
        );
    end
end

// perf checks
int cpe_ret;
assign cpe_ret = $countones({cpe.ret_simd, cpe.ret_mul, cpe.ret_div});

int ct_stall_be_core, ct_stall_be, ct_stall_fe_core;
assign ct_stall_be_core = $countones({
    ct.ret.stall_mul_simd_use,
    ct.ret.stall_div,
    ct.ret.stall_load_use,
    ct.ret.stall_csr
});
assign ct_stall_be = $countones({ct.ret.stall_l1d, ct_stall_be_core});
assign ct_stall_fe_core = $countones(
    {ct.ret.stall_l1i, ct.ret.stall_act_flow, ct.ret.spec_ic_miss_sink}
);

always @(posedge clk) begin
    if (cpe_ret) begin
        assert(cpe_ret == 1)
        else $warning(
            "CORE RETIRED INST DOUBLE COUNTED: cpe_ret - mul=%0b, div=%0b, simd=%0b" ,
            cpe.ret_simd, cpe.ret_mul, cpe.ret_div
        );
    end

    if (ct_stall_be_core) begin
        assert(ct_stall_be_core == 1)
        else $warning(
            "CORE CYCLE TAG DOUBLE COUNTED: stall_be_core - mul/simd=%0b div=%0b load=%0b csr=%0b",
            ct.ret.stall_mul_simd_use, ct.ret.stall_div, ct.ret.stall_load_use,
            ct.ret.stall_csr
        );
    end

    if (ct_stall_be) begin
        assert(ct_stall_be == 1)
        else $warning(
            "CORE CYCLE TAG DOUBLE COUNTED: stall_be - stall_l1d=%0b stall_be_core=%0b",
            ct.ret.stall_l1d, ct_stall_be_core
        );
    end

    if (ct_stall_fe_core) begin
        assert(ct_stall_fe_core == 1)
        else $warning(
            "CORE CYCLE TAG DOUBLE COUNTED: stall_fe - stall_l1i=%0b act_flow=%0b sink=%0b",
            ct.ret.stall_l1i, ct.ret.stall_act_flow, ct.ret.spec_ic_miss_sink
        );
    end
end
`endif

endmodule
