AleksandarLilic/ama-riscv/verif/unit_test/uart_fpga_tb.sv

// Description:
// Instantiates uart_fpga (DUT) and a uart (off_chip_uart) connected via
// cross-connected serial lines. The off-chip UART sends characters to the
// DUT, which performs case-flipping on ASCII letters and echoes them back.
// The testbench verifies each echoed character against the expected value.
// Data Flow:
//    Testbench -> off_chip_uart -> FPGA_SERIAL_RX -> DUT (uart_fpga)
//    Testbench <- off_chip_uart <- FPGA_SERIAL_TX <- DUT (uart_fpga)

`timescale 1ns/1ps

// redefine these two during build if needed
`define CLK_PERIOD 10 // ns - 100 MHz
`define BAUD_RATE 115_200

parameter unsigned CLOCK_FREQ   = (1000 / `CLK_PERIOD) * 1_000_000; // Hz
parameter unsigned BITS_PER_SYM = (1 + 8 + 1); // 8N1: start + 8 data + stop
parameter unsigned CLKS_PER_BIT = (CLOCK_FREQ / `BAUD_RATE);
parameter unsigned CLKS_PER_SYM = (CLKS_PER_BIT * BITS_PER_SYM);
parameter unsigned SYMBOLS_TO_SEND = 50;
// each symbol needs one send + one echo receive (two serial transfers)
parameter unsigned TIMEOUT_CLKS = CLKS_PER_SYM * 2 * SYMBOLS_TO_SEND + 1000;

`define FAILED \
    $display(msg_fail); \
    $finish();

`define TB uart_fpga_tb

module `TB();

logic done = 0;
logic [7:0] payload;
logic [7:0] expected;
integer i;
integer err_cnt;

// I/O
logic clk = 0;
logic rst;
logic FPGA_SERIAL_RX;
logic FPGA_SERIAL_TX;
logic [5:0] leds;

// Off-chip UART rv_if channels
rv_if #(.DW(8)) off_chip_send_req_ch ();
rv_if #(.DW(8)) off_chip_recv_rsp_ch ();
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
