AleksandarLilic/ama-riscv/(commit log)

2021-06-09 feat(button parser): add synchronizer
2021-06-09 test(button parser): add synchronizer tb
2021-06-09 feat(button parser): add debouncer
2021-06-09 test(button parser): add debouncer tb
2021-06-09 feat(button parser): add edge_detector
2021-06-09 test(button parser): add edge_detector tb
2021-06-09 feat(button parser): add button_parser
2021-06-09 feat(button parser): add button_parser_fpga
2021-06-09 test(button parser): add button_parser_fpga tb
2021-06-09 feat(button parser): add button_parser_fpga constraint
2021-06-12 feat(uart core): add uart_transmitter
2021-06-12 feat(uart core): add uart_receiver
2021-06-12 feat(uart core): add uart_core
2021-06-12 test(uart core): add uart_core_tb
2021-06-12 feat(uart core): add uart_core_fpga
2021-06-12 test(uart core): add uart_core_fpga_tb
2021-06-12 feat(uart core): add uart_core_fpga constraint
2021-07-17 fix(decoder): update decoder 0.1.1 - add imem_en signal
    [ama_riscv_decoder.v]
2021-07-17 fix(decoder): update decoder 0.1.2 - fix wb_sel
    [ama_riscv_decoder.v]
2021-07-17 fix(decoder): update decoder 0.1.3 - remove imem_en signal (write only port)
    [ama_riscv_decoder.v]
2021-07-17 fix(defines): update defines 0.7.1
    [ama_riscv_defines.v]
2021-09-13 feat(core): add core 0.1.0 - initial - if stage
2021-09-13 test(core): add core_tb 0.1.0 - initial - if stage
2021-09-13 fix(core): fix core 0.1.1 - fix imem address signal
    [ama_riscv_core.v]
2021-09-13 test(core): update core_tb 0.2.0 - add model - if stage
2021-09-13 test(core): update core_tb 0.3.0 - add checker - if stage
2021-09-14 feat(core): update core 0.2.0 - add id stage
2021-09-14 test(core): update core_tb 0.4.0 - wip - add model - id stage
2021-09-15 test(core): update core_tb 0.5.0 - wip - add imm_gen and decoder model - id stage
2021-09-16 feat(decoder): update decoder 0.11.0 - add reset sequence
    [ama_riscv_decoder.v]
2021-09-16 test(core): update core_tb 0.6.0 - add reset sequence
    [ama_riscv_core_tb.v]
2021-09-17 test(core): core_tb 0.7.0 - rework checkers
    [ama_riscv_core_tb.v]
2021-09-17 test(core): core_tb 0.8.0 - add id/ex stage ff checkers
2021-09-18 test(core): core_tb 0.8.1 - fix id stage names
    [ama_riscv_core_tb.v]
2021-09-18 test(core): core_tb 0.8.2 - fix pc notation - match rtl
    [ama_riscv_core_tb.v]
2021-09-18 feat(core): core 0.4.0 - add ex stage
2021-09-18 fix(core): core 0.4.1 - fix dmem_we
    [ama_riscv_core.v]
2021-09-18 fix(core): core 0.4.2 - fix dmem_addr
    [ama_riscv_core.v]
2021-09-21 fix(core): core 0.4.3 - fix store_inst_ex
    [ama_riscv_core.v]
2021-09-21 test(core): core_tb 0.12.1 - fix store_inst_ex
    [ama_riscv_core_tb.v]
2021-09-21 feat(core): core 0.5.0 - add mem stage and writeback
2021-09-21 test(core): core_tb 0.14.0 - add mem stage and writeback
2021-09-30 fix(core): core 0.7.1 - fix tohost write
    [ama_riscv_core.v]
2021-09-30 fix(core): core 0.7.2 - fix store mask for sb and sh
    [ama_riscv_core.v]
2021-10-02 fix(core): core 0.7.3 - fix stall_if_q1 reset value
    [ama_riscv_core.v]
2021-10-02 test(core): core_tb 0.17.0 - add csrrw and csrrwi and branch/store fixes
    [ama_riscv_core_tb.v]
2021-10-05 fix(uart_core): uart_core 1.0.1 - update comments - integration
2021-10-05 test(uart_core): uart_core_tb 1.1.0 - add longer wait times for data_out_ready
2021-10-11 feat(core): core 0.10.0 - change to load/store uart signals
2021-10-11 fix(core): core 0.10.1 - fix branch compare op_uns input
    [ama_riscv_core.v]
2021-10-28 fix(core): core 0.10.2 - fix imem ports and mmio address
    [ama_riscv_core.v]
2021-11-01 test(core): core_tb 0.22.1 - fix model calls - separate block
    [ama_riscv_core_tb.v]
2021-11-04 test(core): dut_m 0.4.0 - add stall on forwarding from load
    [ama_riscv_core_tb.v]
2021-11-05 test(core): core_tb 0.26.0 - add regr test status arrays, verbosity switch
2022-09-07 test(core_top): fix waiting after test has passed but stimuli not ended; add pc vector for checker; fix all vector inputs to be read as integer values; add pc checker
    [ama_riscv_core_top_tb.v]
2022-09-16 test(core_top): Remove manual vector import; Add sample counters for each vector read; Add exit on unsuccessful vector file openening
2022-09-20 test(core_top): Fix decoder reg_we for CSR instruction; Add alu checkers
    [ama_riscv_core_top_tb.v, ama_riscv_decoder.v]
2022-09-24 test(core_top): Convert defines to strings where possible; Fix functions to use strings instead; Add event to sync main task and vector loads; Add support for regression run in vector load tasks; Con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
    [ama_riscv_core_top_tb.sv]
2022-09-24 test(core_top): Fix checker names for easier search; Fix hang on last line read from txt; Close vector after reading last line; Cycle accurate with model
    [ama_riscv_core_top_tb.sv]
2024-02-26 test: set up Make-based simulation flow
2024-02-27 core: update reset vector to 0x8000_0000
    [ama_riscv_core.v, ama_riscv_defines.v]
2024-02-27 test(core_top_tb): remove model vector imports and checkers; clean up prints, unused variables, etc.
2024-03-05 test(dpi): add DPI wrapper around C++ simulator; update make flow to build DPI shared object
2024-03-05 core: propagate stall_id to wb stage for proper nop detection (hw vs sw nop)
    [ama_riscv_core.v]
2024-03-13 test(core): fix compile warnings about mismatched types for int/integer; fix warnings about explicit declaration of automatic variables in tasks
    [ama_riscv_core_top_tb.sv]
2024-03-17 test(core): add cosim compile swtich, and runtime cosim checker enable switch; fix handling of temp logs during RTL compile; allow make to use all available cores when called from test suite script
    [ama_riscv_core_top_tb.sv, run_test.py]
2024-03-20 test(core): separate logging of DUT execution from cosim; fix return types for checker functions
    [ama_riscv_core_top_tb.sv]
2024-05-06 test(build): minor cleanup of build logs and stdout prints
2024-07-05 test(suite): fix to abort on build fail instead of trying to run tests
    [run_test.py]
2024-11-17 test(core): minor fixes to stdout prints to make execution log easier to follow
    [ama_riscv_core_top_tb.sv]
2024-11-17 pd: add initial asap7 config and constraints for openroad flow scripts
2024-11-17 test(dpi): update sim submodule and update DPI build switches and core_dpi.cpp
2024-11-18 test: add stop_on_cosim_error plusarg and use by default; update testlist; update reset vector; bump the sim submodule
    [ama_riscv_core_top_tb.sv, ama_riscv_defines.v, run_test.py]
2024-11-18 core: move CSR to mem stage; add complete Zicsr support; add mscratch csr
2024-11-20 core(rf): simplify rf design and remove the reset; update tb accordingly and add delayed start to rf checkers until the first write happens
    [ama_riscv_core.v, ama_riscv_core_top_tb.sv]
2025-02-11 test: update logging to use LOG for all prints; move test loop to a separate task
2025-02-14 profiler(perf): collect profiler trace by default; bump the sim submodule
2025-02-16 test(build): add slang for quick builds and verilator for lint; minor fix for testbench functions; add vcd wave logging
    [ama_riscv_core_top_tb.sv]
2025-02-17 peripherals: fix filename extension
    [button_parser.sv, button_parser_fpga.sv, debouncer.sv, edge_detector.sv, fifo.sv, synchronizer.sv]
2025-05-02 test(suite): update testlist; display mismatched search patterns more prominently; prevent zombie jobs when the run_test.py is killed
    [run_test.py]
2025-09-10 test: clarify naming usage between isa_sim, cosim, and dpi; update build flow and source names accordingly; update isa sim submodule to the latest and match updates in RTL env; tweaks for clarity in 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
2025-09-10 test(suite): add -m/--make_args to pass arguments straight to make from test suite; read last 100 lines from test log instead of the entire file and add more useful error messages in test.status
    [run_test.py]
2025-09-14 test: add log levels; change makefile to print all outputs to stdout; add option to 'rebuild all' in run_test; add timeout clocks and log level to run_test; add 'run' alias for 'run_test.py' for conv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
2025-09-14 test: fix error message for low log levels
    [ama_riscv_core_top_tb.sv, run_test.py]
2025-09-16 test(build): fix run_test that used wrong cosim_bdir; add run.sh to repeat just that one test; fix phony targets in makefiles
    [run_test.py]
2025-09-16 test(tb): tweaks to timescale formatting; replace all calls to 'display' with 'LOGNT' for logging
    [ama_riscv_core_top_tb.sv]
2025-09-16 core(decoder): fix missing default value for bubble_dec
    [ama_riscv_decoder.sv]
2025-09-21 test(build): log only failed tests again at the end of the sim for a more compact preview
    [run_test.py]
2025-09-21 core: fix imem stall in decoder, and bubble up pc in core decode stage; use DFF macro in register file
    [ama_riscv_core.sv, ama_riscv_decoder.sv, ama_riscv_reg_file.sv]
2025-09-21 test(suite): update testlist to include 'vector_ew_basic' and to prevent inclusion of more isa tests that are currently unsupported
2025-09-28 perf(trace): add initial support for tracing from RTL; update ISA sim submodule
2025-09-30 dmem: fix to disable 'load shift and mask' on non-load instructions
    [ama_riscv_decoder.sv]
2025-10-01 test(tb): move rest of the tb defines to the tb_defines header; small fixes for cosim functions args and ret type
    [ama_riscv_core_top_tb.sv]
2025-10-02 core: switch from macros to typedef enum for decoder and alu control signals
2025-10-09 test(suite): reformat multi-line error logs for readability
    [run_test.py]
2025-10-09 core: rename 'clear' to 'flush' for pipeline control; move reset sequence to core
    [ama_riscv_core.sv, ama_riscv_core_top_tb.sv, ama_riscv_decoder.sv]
2025-10-10 core: move decoder, op_fwd, and store_mask to core, and delete control module; rework pipeline interface without struct; add typed pipeline interface; rework remaining defines to enums; clean lint
    [ama_riscv_core.sv, ama_riscv_core_top_tb.sv, ama_riscv_decoder.sv, ama_riscv_imem.sv, ama_riscv_imm_gen.sv, ama_riscv_load_shift_mask.sv, ama_riscv_operand_forwarding.sv, ama_riscv_store_mask.sv]
2025-10-10 decoder: rework to use packed structs for decoded signals and outputs; use enum for rf_addr
    [ama_riscv_core.sv, ama_riscv_core_top_tb.sv, ama_riscv_decoder.sv, ama_riscv_operand_forwarding.sv, ama_riscv_reg_file.sv]
2025-10-12 fe: move frontend stall/bubble logic to fe_ctrl module; move branch resolution to core
    [ama_riscv_core.sv, ama_riscv_core_top_tb.sv, ama_riscv_decoder.sv, ama_riscv_fe_ctrl.sv]
2025-10-17 perf: consolidate cache stats collection; parametrize core perf stats with cnt struct; fix mem stage flushing on dc_stalled to insert bubbles instead
    [ama_riscv_core.sv, ama_riscv_core_top_tb.sv]
2025-10-17 mem: add initialization when not synthesizing; fix module and array hierarchical paths
    [ama_riscv_core_top_tb.sv, ama_riscv_mem.sv]
2025-10-17 icache: fix defines naming conflict with dcache; remove unused signal
    [ama_riscv_icache.sv]
2025-10-19 uart: RTL cleanup; set up standalone testbench
2025-10-19 uart: use ready/valid interfaces instead of separate signals; update tb to finish sim on fail
    [uart.sv, uart_rx.sv, uart_tb.sv, uart_tx.sv]
2025-10-19 uart: fix serial in/out lines to reset high; add option to log uart data being sent; fix tb params for clock frequency and symbol periods; print sent uart data at the end of the sim
    [uart.sv, uart_tb.sv]
2025-10-19 top: add uart
2025-10-20 uart: add shortcut option to always be ready for sending new character, matching the isa sim and reducing simulation time, with warning about innacurate clk measurement if used
    [uart.sv]
2025-10-20 csr: add mtime, and a workaround for passing it to the ISA sim
    [ama_riscv_core.sv, ama_riscv_tb.sv]
2025-10-22 test(tb): add core_view module, exposing instruction breakdown for wave; add retired instruction dasm to wave; fix perf class and perf struct members
    [ama_riscv_core_view.sv, ama_riscv_tb.sv]
2025-10-23 test(tb): better test status report on fail; fix error/warning counting; some variables type cleanup
    [ama_riscv_tb.sv, uart.sv]
2025-10-23 mem: match reset pattern with isa sim (0xA5)
    [ama_riscv_mem.sv]
2025-10-24 test: consolidate test paths between Makefile and run_test.py so both can be used from any dir; add runtime print to the default run_cfg.tcl; remove TB uart when UART_SHORTCUT is used; change clk to 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
2025-10-26 perf: add dmem access info to trace; update ISA sim submodule
2025-10-26 test(build): fix run_cfg path
    [run_test.py]
2025-10-26 fe_ctrl: fix how stalled_entry is stored and cleared
    [ama_riscv_fe_ctrl.sv]
2025-10-26 icache: invalidate cache line on miss; fix lru count to update on current instead of delayed version of req.addr
    [ama_riscv_icache.sv]
2025-10-26 test(tb): add cosim profiling switches as testplusargs; tie host UART valid low when not used
2025-10-27 test(tb): fix profiling testplusargs to interpret input as hex value; remove deprecated dpi_prof_on_boot; update ISA sim submodule
    [ama_riscv_tb.sv]
2025-10-27 test(tb): fix strip_extension() to only use filename
    [ama_riscv_tb.sv]
2025-10-28 decoder: fix default assignment
    [ama_riscv_decoder.sv]
2025-10-28 core: consolidate STAGE macros
2025-10-28 fe: fix bubble in decode
    [ama_riscv_core.sv, ama_riscv_fe_ctrl.sv]
2025-10-29 perf: add bp to trace; add bp stats; update ISA sim submodule
2025-10-29 perf: simplify core counters; add option to track down bubbles
2025-10-30 params: move params and types to 'types.svh', leave 'defines.svh' just for macros; replace caches hardcoded instatiation values with params; fix defines for slang & verilator
    [ama_riscv_core_top.sv, ama_riscv_dcache.sv, ama_riscv_icache.sv]
2025-11-02 dcache: fixes for LRU cnt update (still not matching HW models)
    [ama_riscv_dcache.sv]
2025-11-03 dcache: rework store to properly infer byte write enables
    [ama_riscv_dcache.sv]
2025-11-06 fpga: rename SYNTHESIS to SYNT to avoid collision with Vivado builtin define for synt/impl
    [ama_riscv_dcache.sv, ama_riscv_icache.sv, ama_riscv_mem.sv, ama_riscv_tb.sv, uart.sv]
2025-11-06 icache: fix implicit signal creation due to wrong signal name
    [ama_riscv_icache.sv]
2025-11-07 core: add pipe stage for dmem; add tohost check; update ISA sim submodule
2025-11-07 test(tb): fix number of clock cycles to wait to retire the last inst at the end of sim
    [ama_riscv_tb.sv]
2025-11-07 test(tb): fix branch_resolution for trace
    [ama_riscv_core_view.sv, ama_riscv_tb.sv]
2025-11-07 fe_ctrl: fix exit from speculative execution after backend stall is resolved
    [ama_riscv_fe_ctrl.sv]
2025-11-07 icache: fix to properly discard wrong speculative miss and request to main memory
    [ama_riscv_icache.sv]
2025-11-09 core: simplify mux in DEC for getting new inst while be in stall; clean up some signal and gen block names
    [ama_riscv_core.sv]
2025-11-11 perf: fix trace entry recording after adding dmem pipe stage
    [ama_riscv_core_view.sv, ama_riscv_tb.sv]
2025-11-12 core: fix branch compare fwd path from mem to only use arithmetic (alu/mult) output
    [ama_riscv_core.sv]
2025-11-12 "core: revert a8836fb - branch fwd can't use only arith out"
    This reverts commit a8836fb1d97d2b9cf62b3c5965dee142d74df689.
    [ama_riscv_core.sv]
2025-11-13 core(csr): fix conditions for CSR inst to update CSRs; enable ISA sim exec logging; add Zicsr and AAPG Zmmul tests; Update ISA sim submodule
    [ama_riscv_core.sv, ama_riscv_decoder.sv, ama_riscv_tb.sv]
2025-11-13 decoder(lint): add missing signal declaration
    [ama_riscv_decoder.sv]
2025-11-14 perf(profiling): add memory throughput to trace; Update ISA sim submodule
2025-11-17 simd: replace generic multiplier with one built for packed simd
    [ama_riscv_core.sv, ama_riscv_simd.sv, csa.sv, csa_b.sv, csa_tree_8.sv]
2025-11-18 core(op_fwd): group rs checks on rd into function per stage
2025-11-19 test(suite): fix to only print test name once when test finishes to reduce clutter; add chunksize=2 to try and prevent single worker getting all long tests; remove unnecessary pool termination on ctr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
    [run_test.py]
2025-11-19 simd: add pipe stage
2025-11-19 core: add IT/IT_P defines as shorthand for iterators
    [ama_riscv_bp.sv, ama_riscv_dcache.sv, ama_riscv_icache.sv, ama_riscv_simd.sv, csa.sv]
2025-11-20 fe_ctrl: simplify wrong speculative path logic
    [ama_riscv_fe_ctrl.sv]
2025-11-20 lint: fix simd wide-view matrix widths; remove unused csa_b module
    [ama_riscv_simd.sv]
2025-11-20 test(suite): add filtering to testlist instead of keeping multiple testlists
2025-11-21 core: move csr and uart out of core into their separate modules
2025-11-23 core: remove forwarding from ewb to decode stage; fix forwarding to execute stage from wb on dcache miss
    [ama_riscv_core.sv, ama_riscv_fe_ctrl.sv, ama_riscv_operand_forwarding.sv]
2025-11-23 test(suite): add option to keep passed tests; fix regex search to find any instead of beginning; add runtime to suite's run.tcl
    [run_test.py]
2025-11-23 perf(core): add six perf events for TDA; add temporary counting and printout in tb
2025-11-23 test(suite): fix to cleanup previous run_dir when tb is built; add the rest of the embench benchmarks
    [run_test.py]
2025-11-26 fe_ctrl: fix not to go into spec exec on be stall
    [ama_riscv_core.sv, ama_riscv_fe_ctrl.sv]
2025-11-26 test(caches): fix direct-mapped debug views gen condition
    [ama_riscv_dcache.sv, ama_riscv_icache.sv]
2025-11-26 tb(perf): update TDA print to show all stats when test ends
2025-11-26 test(suite): fix filtering when the same test appears in more than one group; consolidate test paths gen
    [run_test.py]
2025-11-27 perf: add ISA sim hw models stats classes for RTL env; separate out tb types from defines; make core_stats virtual class as it doesn't have state anyways; update ISA sim submodule; update .gitattribu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
    [ama_riscv_tb.sv]
2025-11-30 perf: add total simulation cycles count to end of test stdout print to easily compare against profiled cycles
2025-12-01 lint: 'case' cleanup
2025-12-03 imm_gen: rework such that all immediates are produced beforehand, and only muxed out based on sel; tap branch type imm for BP builds so predictors don't wait for decoder's sel
    [ama_riscv_core.sv, ama_riscv_imm_gen.sv]
2025-12-04 icache: decouple data array lookup from r/v control; fix core inst read when not imem_valid
    [ama_riscv_core.sv, ama_riscv_icache.sv]
2025-12-05 icache: add mem banks instead of flat arrays; update IT macros; fix spec_wrong port (no need for entire struct)
    [ama_riscv_core.sv, ama_riscv_core_top.sv, ama_riscv_csr.sv, ama_riscv_icache.sv, mem.sv]
2025-12-07 core: generate jal PC in decode, avoiding 1 cycle stall
    [ama_riscv_core.sv, ama_riscv_decoder.sv, ama_riscv_fe_ctrl.sv, ama_riscv_imm_gen.sv]
2025-12-07 icache: revert ef7d349 to bank enables tied high due it being on critical path (way index lookup)
    [ama_riscv_icache.sv]
2025-12-07 imm_gen: drop j_type from output mux as it's no longer used
    [ama_riscv_imm_gen.sv]
2025-12-08 test(tb): fix inst_shadow for wave
    [ama_riscv_core_view.sv]
2025-12-08 icache: fix to improve localparams naming and bank address slicing
    [ama_riscv_icache.sv]
2025-12-08 core: rework decode & be muxes (operand select and forwarding) to simplify execute stage muxing and improve timing
    [ama_riscv_alu.sv, ama_riscv_core.sv, ama_riscv_decoder.sv, ama_riscv_fe_ctrl.sv, ama_riscv_imm_gen.sv, ama_riscv_operand_forwarding.sv]
2025-12-08 core: move csr output to e_wbk mux (exe stage) and rework be muxes
    [ama_riscv_core.sv, ama_riscv_decoder.sv]
2025-12-09 core: add STAGE enable, and use where applicable
2025-12-09 test(suite): fix ctrl-c termination (previously removed in 9fbc051)
    [run_test.py]
2025-12-10 core: move dcache read to mem_wbk ff, to have mem stage for way and lru lookup; also move uart to align with dcache
2025-12-10 simd: fix naming for the last csa to avoid confusion
    [ama_riscv_simd.sv]
2025-12-10 core: remove separate saved writeback FFs and use dec_exe FFs for saving writeback rs1/rs2 values on backend stall
    [ama_riscv_core.sv]
2025-12-11 core: don't propagate pc & inst through backend unless in simulation (for wave and cosim); add per stage macro for STAGE FF wrapper; extend pipeline if to include 'ret' stage
2025-12-14 icache: remove dependency on 'hit' for address generation (timing fix)
    [ama_riscv_icache.sv]
2025-12-16 lint: core, bp, fe_ctrl, icache, uart, params
2025-12-16 icache(debug): fix bank indexing for data_view
    [ama_riscv_icache.sv]
2025-12-18 core: move branch and jalr resolution results to mem stage
2025-12-18 test(make): fix end of test stdout print
2025-12-18 simd: timing improvements for the second stage addition
2025-12-19 perf: fix branch hit tracking
    [ama_riscv_core_view.sv, ama_riscv_tb.sv]
2025-12-21 reg_file: fix to not write to rdp when rd=x0
    [ama_riscv_reg_file.sv]
2025-12-25 test(suite): search also for 'tohost fail' after simulation finished
    [run_test.py]
2025-12-25 core(op_fwd): forward c operand for simd in mem stage instead of doing it in exe when inst is dispatched
2025-12-28 core(op_fwd): fix forwaring on paired register from mem/wbk in exe; add aapg widen tests; update ISA sim submodule
    [ama_riscv_operand_forwarding.sv]
2025-12-30 mem: fix dcache port such that only read or write can happen in a single cycle
    [ama_riscv_dcache.sv, ama_riscv_mem.sv]
2025-12-30 dcache: fix to remove reduntant extra cycle on miss refill
    [ama_riscv_dcache.sv]
2025-12-30 test(suite): fix how seconds for runtime print are compensated after rounding
    [run_test.py]
2025-12-31 core: fix core & dcache handshake on dcache load response
    [ama_riscv_core.sv, ama_riscv_dcache.sv]
2026-01-06 test(cosim): update to new single_step method; fix mhpm counter padding; update ISA sim submodule
    [ama_riscv_tb.sv]
2026-01-09 test(suite): catch simulation fatal/error messages as well
    [run_test.py]
2026-01-11 simd: fix dot8 overflow
    [ama_riscv_simd.sv]
2026-01-11 lint(rf): fix width expand on index adder
    [ama_riscv_reg_file.sv]
2026-01-18 test(suite): add runtime print for each test
2026-02-10 fe_ctrl: fix speculative entry save/clear
    [ama_riscv_fe_ctrl.sv]
2026-02-10 test(suite): fix to remove duplicated test status stdout print
    [run_test.py]
2026-02-16 core(perf): fix for inst_ret count enable
    [ama_riscv_core.sv]
2026-02-19 perf(konata): add konata tracer
2026-02-20 perf(konata): move stage valid flags to core view; remove pipe flush debug message
2026-03-05 core(hpm): fix ctrl_flow and mem combined events
    [ama_riscv_core.sv]
2026-03-05 icache(hpm): fix for counting cache miss on bad spec
    [ama_riscv_icache.sv]
2026-03-05 tb(core_view): fix spec exec port type change missing from 19201eb
    [ama_riscv_core_view.sv, ama_riscv_tb.sv]
2026-03-05 icache(hpm): fix for counting cache events on spec exec enter/exit
    [ama_riscv_fe_ctrl.sv, ama_riscv_icache.sv]
2026-03-08 perf(hpm): collect, save, and print all hardware counters in simulation; update ISA sim submodule
2026-03-08 perf: add more events; simplify json core counters export; fix csr mhpmevent length define
    [ama_riscv_core.sv, ama_riscv_csr.sv, ama_riscv_dcache.sv, ama_riscv_tb.sv]
2026-03-09 perf(cosim): add AMAT print for icache & dcache
2026-03-20 test(suite): fix for single test run hex search
    [run_test.py]
2026-03-27 docs(readme): add new features and examples
    [hw_stats_tda_l1.csv]
2026-03-29 simd: fix to drop redundant dot8u OF detection; update ISA sim submodule
    [ama_riscv_simd.sv]
2026-03-29 fpga: add uart standalone module
2026-03-29 fpga(uart): light up led on reset release
    [uart_fpga.sv]
2026-03-30 fpga(uart): minor reorg for leds
2026-03-30 top: fix to properly propagate CLOCK_FREQ
    [ama_riscv_core_top.sv, ama_riscv_top.sv]
2026-04-02 uart: fix to not raise ready when CTRL reg is accessed
    [ama_riscv_uart.sv]
2026-04-02 fpga(uart): use enum for UART baud rate instead of hardcoding value
2026-04-03 build: by default run make with 'nproc' threads, with fallback to 8
2026-04-03 simd: move 'y' and 'flip' declarations outside of 'for generate' loop
    [ama_riscv_simd.sv]
2026-04-03 simd: tweak to reuse the same adder for both signed and unsigned operations in the last stage
2026-04-07 uart: fix tx_ready being high just as data has been received
    [ama_riscv_uart.sv]
2026-04-09 core(hpm): fix bad_spec to count flushed cycles; add bp_miss to count just the miss even; update ISA sim submodule
    [ama_riscv_core.sv, ama_riscv_csr.sv, ama_riscv_tb.sv]
2026-04-12 perf(cosim): separate all empty cycles from pipeline stalls
2026-04-14 build(make): ignore checking sources timestamp if running simulation only; fix build.log not picking up RTL/TB build logs
    [run_test.py]
2026-04-15 test(suite): print 'fail' message before raising exception when make/simulator fail at runtime
    [run_test.py]
2026-04-15 perf(konata): add switch for enabling konata logging
2026-04-16 perf(cosim): unify naming for TDA counters print; add missing 'lost_cycles' to json output; update ISA sim submodule
2026-04-16 csr: fix read enable on rd=x0; fix perf_cnt testlist entry; update ISA sim submodule
    [ama_riscv_decoder.sv]
2026-04-27 script(fpga): add script for collecting stats dicts from UART outputs
2026-04-27 docs(perf_runs): add perf runs results collected from FPGA
    [hw_stats_benchmarks.csv, hw_stats_mlp.csv]
2026-04-29 docs(perf_runs): update embench perf runs results
    [hw_stats_benchmarks.csv]
2026-05-03 tb: fix 'enable_konata' plusarg name
    [ama_riscv_tb.sv]
2026-05-03 tb(core_view): fix 'k_valid_id.exe' to exclude !dc_stalled condition
    [ama_riscv_core_view.sv]
2026-05-05 div: don't cache special case results
2026-05-05 div: fix to not invalidate result cache entry on special case
    [ama_riscv_div.sv, ama_riscv_div_tb.sv]
2026-05-10 div: bundle wires with packed structs and clean up signal names
2026-05-10 tb: fix instantiation port lists
    [ama_riscv_tb.sv]
2026-05-13 perf: fix be & bad_spec overlap counting; move ret_inst to perf_event struct with all other events
    [ama_riscv_core.sv, ama_riscv_csr.sv]
2026-05-14 memory: move boot address to 0x8000_0000; increase ram to 128K; move uart0 to dedicated region; update ISA sim submodule
2026-05-14 docs(perf_runs): update results after adding divider and new bp config
    [hw_stats_benchmarks.csv, hw_stats_mlp.csv]
2026-05-15 test(suite): raise exception if no tests were found after filtering
2026-05-15 test(unit): port lib modules TBs to SV; fix FIFO typo; clean up deprecated headers
    [button_parser.sv, button_parser_fpga.sv, button_parser_fpga_tb.sv, debouncer.sv, debouncer_tb.sv, edge_detector.sv, edge_detector_tb.sv, fifo.sv]
2026-05-17 test(suite): fix return codes; fix subprocess cleanup on interrupt; other minor cleanups
    [run_test.py]
2026-05-19 decoder(assert): fix i-type unsupported inst check
    [ama_riscv_decoder.sv]
2026-05-19 types: fix data_fmt 'op_class' and 'op' types
    [ama_riscv_core.sv, ama_riscv_decoder.sv]
2026-05-24 core: fix imem_req address width (bug from mem increase to 128K in 9641430)
    [ama_riscv_core.sv]
2026-05-24 decoder: print warning for unsupported instruction in comb decode
2026-05-24 core: don't stall on div cache hit
    [ama_riscv_core.sv, ama_riscv_div.sv]
2026-05-26 script(fpga): add runtime print for update_mem and flash_bit
2026-05-27 div: initialize rem to 'bits(b) - 1' instead of 0 to skip producing 0 quotient bits in the beginning; update div_tb timing expectations; update ISA sim submodule
    [ama_riscv_div.sv, ama_riscv_div_tb.sv]
2026-05-27 div: revert e123525 - stall 1 clk on cache hit due to timing implications for the frontend
    [ama_riscv_core.sv, ama_riscv_div.sv, ama_riscv_div_tb.sv]
2026-05-28 docs(perf_runs): update results after divider optimization on rem initialization
    [hw_stats_benchmarks.csv, hw_stats_mlp.csv]
2026-05-28 fpga(constraints): explicitly set bank voltage config; add false paths for I/O
2026-05-31 docs(perf_runs): add ustress results
    [hw_stats_ustress.csv]
2026-05-31 docs(readme): update VERBOSE log with stall source print
2026-06-03 test(cosim): enable insertion of RTL values into ISA sim on accesses to CSRs that can't be modelled in the ISA sim enviroment; update ISA sim submodule
2026-06-03 test(cosim): print all executed instructions to stdout (before profiling summary); update ISA sim submodule
2026-06-04 core(perf): cycle tagging fix - don't count stall_load on dcache miss
    [ama_riscv_core.sv]
2026-06-07 fpga: use PLL settings that give the lowest jitter
    [ama_riscv_fpga.sv]
2026-06-07 test(suite): update -f/--filter arg to use space separated values
2026-06-11 fpga: add vivado tcl synthesis flow; add driver script
2026-06-11 core: fix divider raising stall on speculative exec flush
    [ama_riscv_core.sv]
2026-06-12 tb: add 'heartbeat_clocks' plusarg, and print under INFO level during execution
2026-06-12 mem(perf): track down number of cycles with both icache and dcache requests (to main mem) in flight
2026-06-12 fpga: add .mmi gen; add --tag for run_synt.py; update update_mem.sh and flash_bit.tcl to use the new flow
2026-06-12 fpga(constraints): use on-board usb-uart interface
2026-06-14 csa(simd): fix params that can be 'bit' instead of 'unsigned'
    [csa.sv, csa_tree_8.sv]
2026-06-14 test(suite): update -t/--test to accept more than one test; add --log_kanata arg; replace stdout quotes <> with ''
    [run_test.py]
2026-06-14 core(refactor): move reset sequencing to be together with pipeline control
    [ama_riscv_core.sv]
2026-06-18 bp: fix pc slicing to exclude bottom two bits (word aligned access)
    [ama_riscv_bp.sv]
2026-06-18 docs(readme): update perf_est correlation, and fpga results
    [hw_stats_benchmarks.csv, hw_stats_mlp.csv, hw_stats_ustress.csv]
2026-06-19 uart: add rx buffer
2026-06-23 core: add clint; add support for interrupts; update ISA sim submodule
2026-06-23 uart_rx: remove stale FPGA_OFFSET
2026-06-23 core(assert): fix assert on icache returning zero to also exclude the check when DEC is bubbled
    [ama_riscv_core.sv]
2026-06-26 perf(konata): fix konata logging after adding traps; wrap konata logging to two separate functions in tb
    [ama_riscv_core_view.sv, ama_riscv_tb.sv]
2026-06-26 fe_ctrl: fix to not take in branch/jalr_in_dec on bubbled decode slot
    [ama_riscv_core.sv]
2026-06-26 test: improve test pass/fail handling - write test.status file from tb, read it in from makefile and run_test.py
    [ama_riscv_tb.sv, run_test.py]
2026-06-28 mem: properly parametrize dmem region access based on the main mem size; add asserts to check dmem region access; fix asserts for cycle_tag
    [ama_riscv_core.sv]
2026-06-28 fe_ctrl: fix speculative exec entry on non-valid branch in decode
    [ama_riscv_core.sv, ama_riscv_fe_ctrl.sv]
2026-07-01 csr: skip minstret increment when writing to that CSR
    [ama_riscv_core.sv, ama_riscv_csr.sv]
2026-07-01 fe_ctrl: fix to ignore decode stage flow stall on stale icache miss
    [ama_riscv_fe_ctrl.sv]
2026-07-03 test(suite): print log name to stdout on failed test
    [run_test.py]
2026-07-05 perf_event: drop redundant ret_inst as custom event, and wire in ret_inst separately; update isa sim submodule
2026-07-09 lint: minor fixes in core, and notes on barrel shifter
    [ama_riscv_core.sv, barrel_shift_seg.sv]
2026-07-12 core(cycle_tag): add spec_ic_miss_sink as core_fe_stall; classify stall_csr as core_be_stall; update isa sim submodule
    [ama_riscv_core.sv, ama_riscv_fe_ctrl.sv]
2026-07-12 tb(log): add more info about empty cycle stall source, and other tweaks for easier log highlighting
    [ama_riscv_tb.sv]
2026-07-12 core(cycle_tag): fix load_use_stall on dcache miss tagging
    [ama_riscv_core.sv]
2026-07-12 docs(readme): update perf_est correlation, and fpga results; update isa sim submodule
    [hw_stats_benchmarks.csv, hw_stats_mlp.csv, hw_stats_ustress.csv]
2026-07-13 fpga: add uart and interrupt tests to update_mem.sh; update isa sim submodule
2026-07-19 cosim(build): add '-Werror=conversion' and fix/cast surfaced issues; update isa sim submodule
    [ama_riscv_tb.sv]
2026-09-06 test(suite): improve filtering capabilities with -g/--group option; convert 'run' from alias to function; update isa sim submodule
